WeymenKoo/STIM-Rev1-Hardware/01_client_board/tests/B0-bringup/photos/P4a_prepower.jpg

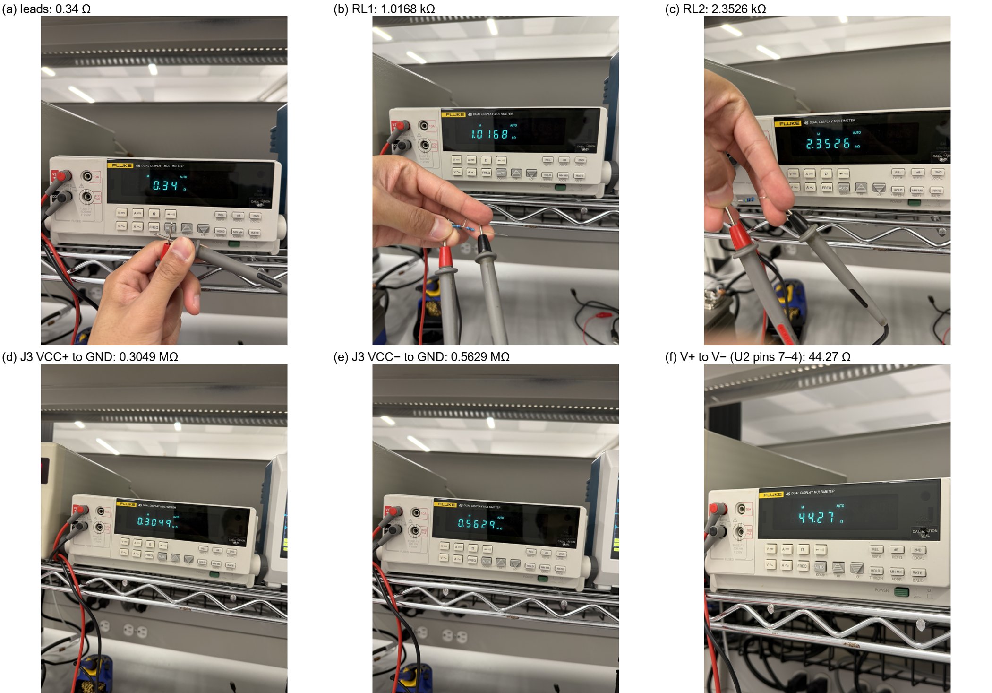
01_client_board/tests/B0-bringup/photos/P4a_prepower.jpg
