WeymenKoo/STIM-Rev1-Hardware/01_client_board/tests/B0-bringup/photos/P4_board_closeup.jpg

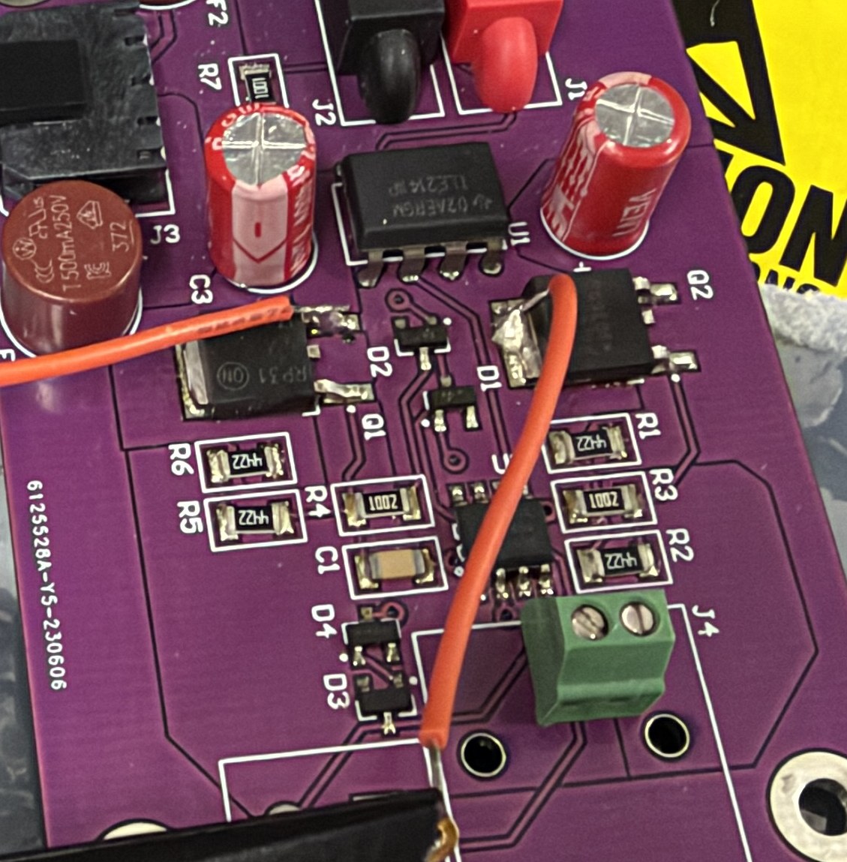
01_client_board/tests/B0-bringup/photos/P4_board_closeup.jpg
