WeymenKoo/STIM-Rev1-Hardware/01_client_board/BENCH-SESSION_30V.docx

Client STIM Board Bench Session Record

Acceptance tests A1, A2, A5b, A4, A3 and A7 at ±30 V — simulation versus bench

JY063 Multi-Channel Neural Interface for Immersive VR · UBC ELEC 491 · Team JY · Weymen Koo

Revision 2026-11-07 · MCLD 3042 bench equipment with a Rigol DHO804 or a Tektronix TBS1000C (2 ch) · companion scripts bench/bench_rig.py (DHO804) and bench/bench_tbs.py (TBS1000C)

# 1. Session identification

Fill in before power is applied. Every number written in this record is a bench value [B]; grey italic values are LTspice predictions [L] from the 2026-10-27 model runs and are provided for comparison only.

Field
Date / location | ____________ MCLD 3042 (3rd-year lab), bench no. ____
Operator(s)
Board | client STIM board (STIM.SchDoc 2026-10-16), S/N: ______ DPAK markings: Q2 top = ________ Q1 bottom = ________
Rails | Xantrex XPH 35-4T, bench unit S/N ______: output 1 = +30.0 V, output 2 = −30.0 V, both I-limit 50 mA (set with output OFF, read on the right meter), outputs floating, out1(−) joined to out2(+) = GND → J3 pin 2
Generator | Rigol DG1022 (bench) via USB, HiZ, Vpp ☐ —or— FG085 ☐ (Vpp field, fixed 50 Ω, set 0 V before connecting)
Scope / probes | Rigol DHO804 S/N ______ via USB ☐ / LAN ☐, 4 × 10× probes, all grounds on J2. preflight run on ______ (date) —or— Tektronix TBS1___C S/N ______ (2 ch) ☐: Default Setup pressed, CH1 + CH2 probe menu 10X and probe switches 10X ☐, bench_tbs.py preflight passed ☐
DMM precision | Fluke 45 (bench) S/N ______, RATE S (5 digits), leads zeroed ☐
DMM second | Brymen BM235 (rail current −)
Load resistors | RL1 nominal 1.00 kΩ, measured: ________ Ω RL2 nominal 2.2 kΩ, measured: ________ Ω (Fluke 45 Ω)
Laptop | bench_rig.py check ☐ lists DHO8 + DG1022 session_log.csv started ☐ (TBS: bench_tbs.py check lists TBS1xxxC + DG1022 ☐)

## 1.1 Probe points (STIM.SchDoc)

Node | Where to clip (never bare tips on SOIC pins — clips or soldered wires)
VCC+ / VCC− | F1 / F2 board side, or J3 pins 1 / 3 (3-pos Micro-Fit: 1 = VCC+, 2 = GND, 3 = VCC−)
GND | J3 pin 2, J2, J5 GND — all scope grounds on J2
VP (V+) | C2 1 µF lead that is NOT on GND (= Q2 emitter, U2 pin 7, U1 pin 7)
VN (V−) | C3 1 µF lead that is NOT on GND (= Q1 emitter, U2 pin 4, U1 pin 4)
OUT | D1–D2 junction = top end of R7 1 k (U2 INA149 pin 6)
LOAD | J1 electrode connector = bottom end of R7 (U1 pin 3)
REF | U1 pin 6 (op-amp output; also U2 pins 1 and 5)
INPUT | J4 BNC centre (generator goes here) = D3/D4 junction = U2 pin 3. J5 screw terminal is the same net
Q2 / Q1 base | R2–R3 junction / R4–R5 junction (DMM only, test 1a)

## 1.2 Before power (tick all)

☐ Laptop: `python3 bench_rig.py check` shows the DHO804 and the DG1022. preflight was run at home (decode OK, generator edge written on sheet 5).

☐ TBS1000C instead of the DHO804: Default Setup on the scope, then `python bench_tbs.py check` (lists TBS1xxxC + DG1022, both probe attenuations read 10) and `python bench_tbs.py preflight` (both probes read ≈ 5 V on PROBE COMP). Only two probes: CH1 LOAD, CH2 OUT. VP / VN / REF loops stay free until the script asks.

☐ Xantrex: both outputs OFF; output 1 preset 30.0 V, output 2 preset 30.0 V; both current limits 50 mA; out1(−) wired to out2(+) and to J3 pin 2.

☐ Fluke 45 in series with the VCC+ lead (mA, 300 mA range for power-up), BM235 in series with the VCC− lead (mA).

☐ RL1 between J1 and J2. Generator BNC on J4, generator output OFF / 0 V. No electrodes, no humans in the loop.

☐ Scope probes on LOAD, OUT, VP, VN; grounds on J2 only. Probe clips not touching anything else; check with the DMM that VP–VN clips are not shorted.

☐ This sheet printed. tests/bench/ folder empty or from a previous run renamed.

## 1.3 Rules

• Both rails on and off together: two fingers on the two Xantrex output buttons. Never one rail alone for more than the press (A7 sim: ~6.6 mA while one rail is missing at ±30 V — test 6 does it on purpose, nothing else should).

• Generator to 0 V before changing the load or the wiring — the script does this at every swap. OUT swings to a rail if the load opens with a command applied.

• Rail current > 15 mA at idle → both outputs OFF, do not debug live. The script stops itself if you type > 15.

• The Fluke 45 is the only meter that resolves ±1 %. The BM235 is for rail current only. The Xantrex meters (10 mA) are not readings.

• Every number written here is tagged [B]. Grey italic numbers are [L] from generic op-amp macromodels; the ones marked “validates the model” are the ones that matter.

## 1.4 Wiring

Xantrex out1 (+30 V) -- Fluke 45 mA -- J3.1 VCC+

Xantrex out1 (-) ---+

Xantrex out2 (+) ---+-- GND -- J3.2 / J2 (fixture GND post)

Xantrex out2 (-30 V) -- BM235 mA -- J3.3 VCC-

DG1022 -- BNC -- J4 INPUT RL fixture: J1 (LOAD) -- J2 (GND)

Scope CH1 LOAD CH2 OUT->REF CH3 VP CH4 VN grounds on the GND post

TBS1000C: CH1 LOAD (never moves) CH2 OUT/VP/VN/REF in turn (A1), INPUT (A3/A4), VCC+ (A7)

Laptop USB -> DHO804 + DG1022 (USB ground = earth = scope ground = J2)

## 1.5 Running order and time (script commands on each sheet)

# | Test | Changes from previous | Time | Done ☐

0 | preflight (at home) | no board: probe-comp decode check, generator flatness + edge | 10 min
1 | A1 bias / bootstrap window | — (1d onset sweep and 1e rail sweep inside) | 40 min
2 | A2 DC accuracy | generator to DC; Fluke 45 to INPUT / LOAD | 10 min
3 | A5b load change | pull fixture link, Fluke 45 in series; swap fixture once | 5 min
4 | A4 frequency response | CH2 to INPUT; scripted sweep | 3 min
5 | A3 step response | scripted single-shot, square 0 / 2 V | 5 min
6 | A7 rail loss (optional) | Xantrex output buttons on prompt | 10 min

## 1.6 Using the TBS1000C when the DHO804 is not there (2 channels)

Same tests, same prompts, same session_log.csv and output files; run bench_tbs.py instead of bench_rig.py with the same options. Where a test needs more than two nodes at the same instant (A1 only), CH1 stays on LOAD and the script asks you to move CH2 between captures. Every capture triggers on LOAD, and the script lines them up on the LOAD phase before it forms VP − VN, REF − VN and VP − REF, so the numbers are the same quantities as on the DHO. It prints the shift it applied (expect < 1 µs of a 3333 µs period).

# | Test | TBS1000C: channels and what changes | Extra | Done ☐

0 | preflight | both probes on PROBE COMP in turn: ≈ 5 V or the 1X/10X setting is wrong; then generator → CH1 | +3 min
1 | A1 | CH1 LOAD fixed. CH2: OUT → VP → VN at idle, then OUT / VP / VN / REF at each amplitude (one prompt per move). 1d onset swept twice (pk+, then pk−) so 1 V/div covers each peak. 1e: CH2 VP → VN | +15 min
2 | A2 | identical: Fluke 45 does the work, scope idle | 0
3 | A5b | identical | 0
4 | A4 | CH1 LOAD, CH2 INPUT. First 20 s: CH1 also on INPUT, so the CH1/CH2 gain (±3 % each [DS]) is divided out | +2 min
5 | A3 | CH1 LOAD, CH2 INPUT, 16 averages per capture instead of single-shot (8 bit: 1 % of 2 V ≈ 1 count) | +1 min
6 | A7 | CH1 LOAD, CH2 VCC+ (F1 board side): shows when the + rail leaves and returns | 0

• 8 bit instead of 12: the script averages 16× and re-scales until each trace fills more than 1/3 of the screen without clipping. The A1 1b “±1 %” and A4 “absolute gain ±1 %” rows are indicative only. Tick them from A2 (Fluke 45), which is the ±1 % arbiter either way.

• Press Default Setup on the TBS before starting (trigger at mid-screen) and set the CH1 and CH2 probe menus to 10X. The script does not change the probe setting; preflight checks it.

• Probe ground clips: both on J2, as on the DHO. The TBS channels share a ground with each other and with mains earth, the same as the DHO.

# 2. Harnesses, fixtures and kit (made and checked at home)

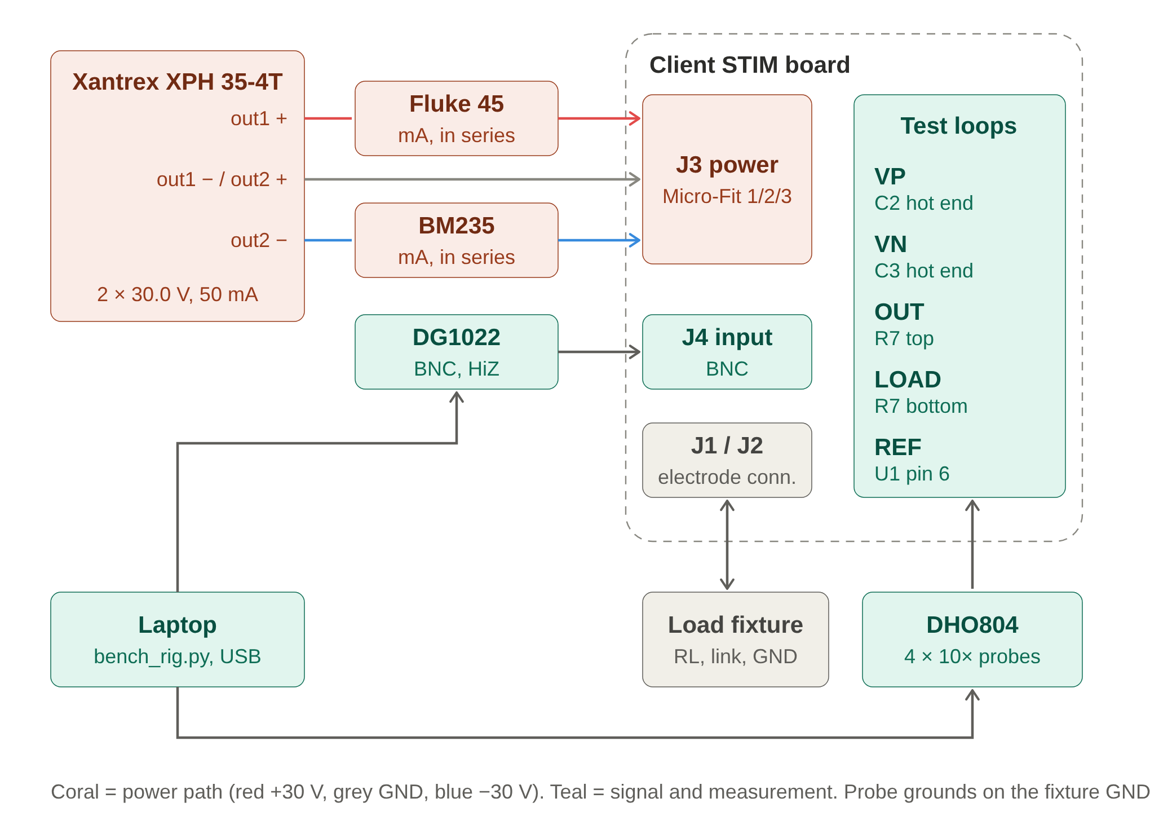
[picture p38: figure]

Figure 1. Bench wiring. Coral = power path, teal = signal and measurement. Rail ammeters sit at the Xantrex posts. All probe grounds on the fixture GND post.

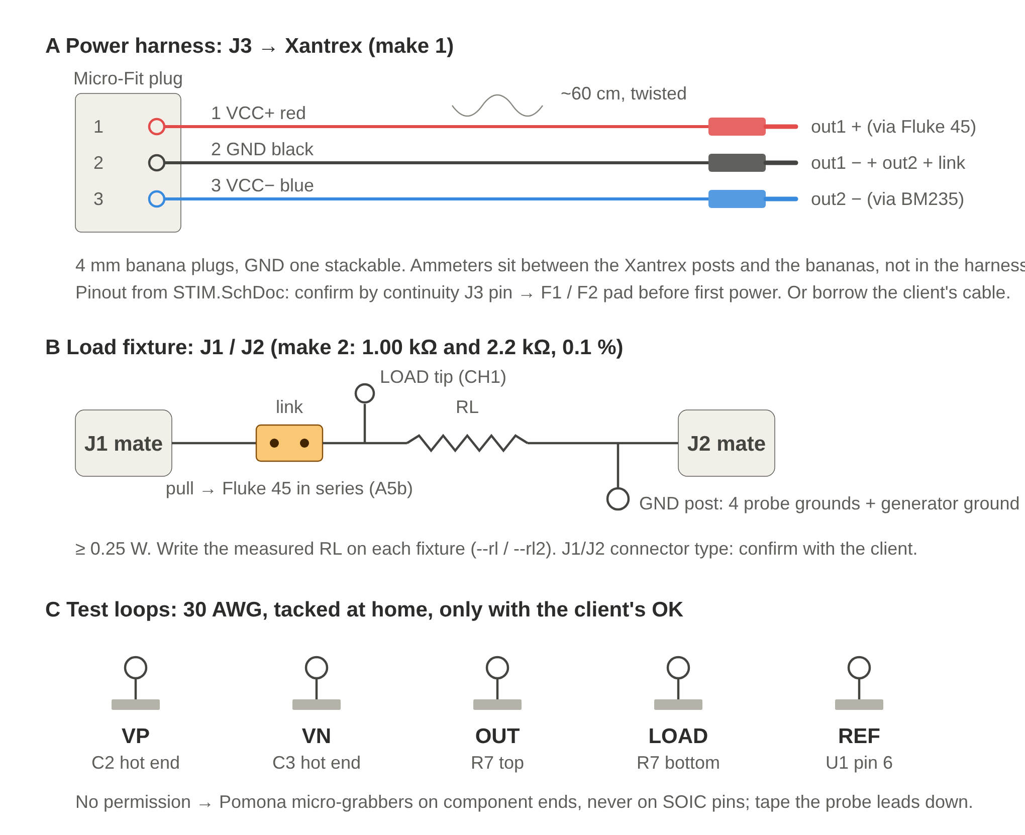
[picture p39: figure]

Figure 2. Harness and fixture mockups. A: J3 → Xantrex. B: load fixture, one per resistor, with the series link for A5b. C: test loops at the five probe nodes.

## 2.1 A. Power harness (make 1)

3-pin Molex Micro-Fit plug on J3 (1 = VCC+, 2 = GND, 3 = VCC−, from STIM.SchDoc) → ~60 cm twisted triple → 4 mm bananas red / black / blue, GND banana stackable. Short banana jumper out1(−) ↔ out2(+). The Fluke 45 and BM235 go between the Xantrex posts and the red / blue bananas, not inside the harness. Micro-Fit needs a crimp tool: ask the client for the cable they already use, or pre-crimped Micro-Fit leads + housing (Digi-Key, next day).

## 2.2 B. Load fixtures (make 2)

J1 mate → 2-pin link → RL → J2 mate, with a GND post (wire loop or turret) at the J2 end and a LOAD loop at the J1 end. RL = 1.00 kΩ and 2.2 kΩ, 0.1 %, ≥ 0.25 W. Pull the link to put the Fluke 45 in series (A5b). Swapping loads = unplug one fixture, plug the other. Write the measured RL on each fixture; those are --rl / --rl2. Confirm the J1/J2 connector type with the client and get two mates.

## 2.3 C. Test loops (with the client's OK)

30 AWG loops tacked at VP (C2 lead not on GND), VN (C3 lead not on GND), OUT (R7 top), LOAD (R7 bottom), REF (U1 pin 6). INPUT is J4. If no permission: Pomona micro-grabbers on component ends only, never SOIC pins, probe leads taped down.

## 2.4 Bring

Item | Note
DHO804 + adapter + 4 × 10× probes + USB cable | preflight run at home with this exact cable
Laptop + charger + USB-B cable for the DG1022 | small USB hub if short on ports
BM235 | optional: rail currents are equal when the load current averages to zero; Fluke 45 on VCC+ is enough
Board, 2 load fixtures, power harness, GND jumper
4 banana–banana leads, 2 banana–minigrabber leads | do not count on the lab's
Spare F1 / F2 fuses | read the marking on the board first
ESD strap, screwdriver, Kapton, zip ties, this sheet, pen
From the lab | Xantrex XPH 35-4T, Fluke 45, DG1022, BNC–BNC cable; TBS1000C + 2 × 10× probes + USB-B cable if the DHO804 is not there

## 2.5 At home before the session (~30 min, tick all)

☐ Continuity: each harness end to end; J3 pin 1 → F1 pad, pin 3 → F2 pad, pin 2 → J2 on the board (unpowered).

☐ Unpowered resistance with the Fluke: VCC+ → GND ______ Ω, VCC− → GND ______ Ω, VCC+ → VCC− ______ Ω. Very low or a short → do not power.

☐ RL1 measured ______ Ω, RL2 measured ______ Ω, written on the fixtures.

☐ python3 bench_rig.py preflight passed (decode OK, generator edge noted) with the DHO804 and FG085 --gen manual.

☐ Client emailed: J3 cable loan, J1/J2 connector part / two mates, permission to tack test loops.

# 3. Test 1 — A1 Bias point and bootstrap window

Question. Does the floating op-amp supply (VP–VN window) form at ±30 V, and can the pump deliver 2 mA and 5 mA? Decides the working current for every test after it, and measures the Q1/Q2 emitter-follower drops (the transistor question).

Probes. CH1 LOAD (J1 / bottom of R7) · CH2 OUT (D1–D2 junction / top of R7) · CH3 VP (C2 lead that is not GND) · CH4 VN (C3 lead that is not GND) · all probe grounds on J2. Fluke 45 in series with the VCC+ lead (mA), BM235 in series with the VCC− lead (mA). ~40 min.

Script: python3 bench_rig.py a1 --rl <RL1> --onset (add --rails 35 for a ±35 V point; --rails 35 40 50 only with a second dual supply)

TBS1000C: python bench_tbs.py a1 --rl <RL1> --onset (CH1 LOAD fixed; the script asks for each CH2 move: OUT → VP → VN → REF)

TBS1000C: 1b “I_load ±1 %” is indicative (8 bit). Decide the ±1 % from A2. VP / VN at I pk+, REF − VN and VP − REF come from separate CH2 captures aligned on LOAD.

## 3.1 1a. Power-up, no signal (generator OFF) — script prompts for the DMM values, reads the scope itself

Quantity | Expected [L] ±30 V | Bench [B] (write here) | Tol. / Pass ☐
Rail current + / − (Fluke 45 / BM235 in series) | ~3.5–5 mA each | | > 15 mA → OFF
VCC+ / VCC− vs GND (Fluke 45, J3 pins 1 / 3) | +30.0 / −30.0 V | | —
VP / VN vs GND (scope mean) | +2.5 / −2.4 V | | ±1 V
OUT / LOAD vs GND | ≈ 0 / 0 V | | —
Window VP − VN | 4.97 V | | ±2 V ☐
Q2 Vbase (R2/R3 junction) − VP | +0.65 V (NPN follower, as modelled) | | record
Q1 Vbase (R4/R5 junction) − VN | −0.65 V (PNP follower, as modelled) | | record
LOAD ripple (AC, 50 mV/div, 1 µs/div): Vpp / f | none [L]; TI models ~1 MHz | | record

Sign of Vbase − Vemitter wrong, or |Vbe| ≫ 0.7 V → the fitted transistor is not what the model assumes. Write the DPAK markings here and carry on; the window numbers decide, not the part.

Q2 marking / Q1 marking _________________________________________________________

## 3.2 1b. 2 mA run (2 Vpk 300 Hz) — script reads at the positive current peak; CH2 moves OUT → REF (U1 pin 6) when prompted

Quantity | Expected [L] ±30 V | Bench [B] (write here) | Tol. / Pass ☐
I_load pk+ / pk− (V(LOAD) ÷ RL) | 2.000 / −2.000 mA | | ±1 % ☐
OUT at I pk+ | 4.00 V | | ±0.2 V
VP / VN at I pk+ | +6.0 / +1.1 V | | ±1 V
REF − VN min (CH2 on REF) | 0.92 V ← validates the model | | record
VP − REF min | 1.05 V | | record
Window VP − VN avg | 4.97 V | | ±2 V ☐
Rail current + / − | 5.2 / 5.2 mA | | ±20 % ☐

Figure 3. Expected 2 mA waveforms [L]. Script saves A1_30V_2mA_bench.csv / _ref.csv and the overlay PNG.

## 3.3 1c. 5 mA run (5 Vpk) — the sim says the current clips; look at the LOAD trace shape first

Quantity | Expected [L] ±30 V | Bench [B] (write here) | Tol. / Pass ☐
Plateau present? flat or sloped? (script: fraction of period on plateau) | yes, flat (> 0.1) | | record
I_load plateau + / − | +4.01 / −3.38 mA | | ±0.5 mA ☐
REF − VN during the + plateau | 0.20 V | | record
VP − REF during the − plateau | 1.00 V | | record
Window VP − VN avg | 4.84 V | | ±2 V ☐
Rail current + / − | 6.0 / 5.9 mA | | ±20 % ☐

D3/D4 (5 V zeners) start to conduct near 5 V: the INPUT the board sees may be below the generator setting. The script uses the measured LOAD, not the setting.

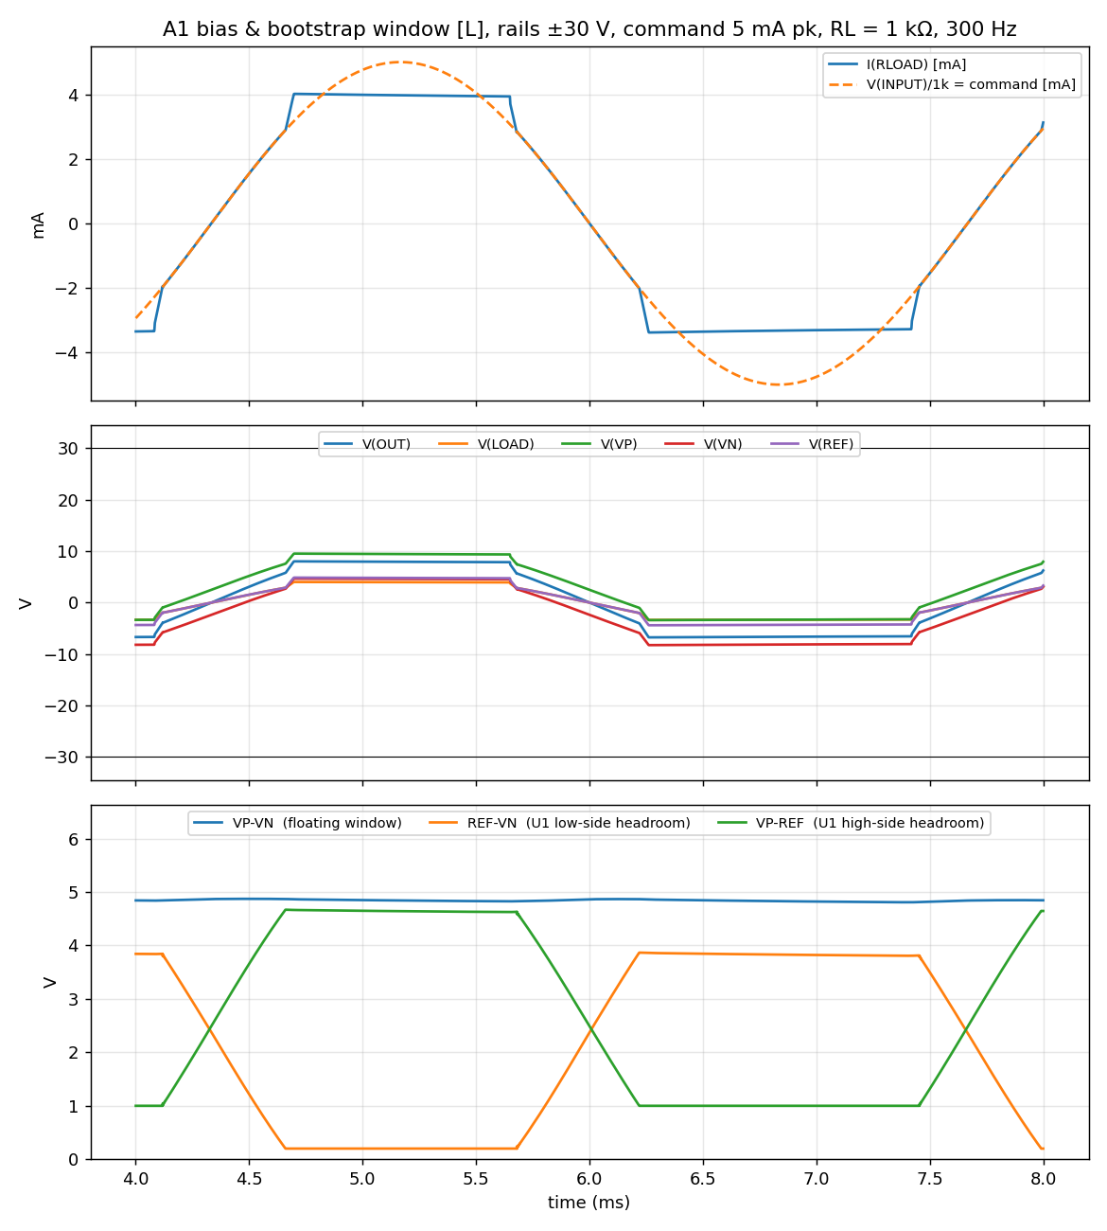
[picture p40: figure]

## 3.4 1d. Plateau onset (scripted, 1 min): 2.0 → 4.0 mA in 0.25 mA steps

Sourcing onset (mA cmd where pk+ < 98 %) Sinking onset (mA) ________________

## 3.5 1e. Optional — window vs rail (the ±50 V claim). Generator OFF, ramp both rails together, DMM/scope only

Rails | VP / VN (V) | Window (V) | Window [L] scaling | I rail + (mA) | 2 mA pk+ / pk− (mA)
±30 V | | | 4.97
±35 V (Xantrex max) | | | ~5.8
±40 V (2 supplies) | | | ~6.6
±50 V (2 supplies) | | | ~8.2

Stop if rail current > 15 mA or window > 30 V (INA149 abs max ±18 V). ±40/±50 V = Xantrex 35 V + TTI EX354RT 5–15 V in series on each side, both units' outputs floating.

## 3.6 Decision after A1 (circle one)

☐ Window within ±2 V and 2 mA within 1 % → model OK at ±30 V; run tests 2–6 at 2 mA (as printed).

☐ Window OK but 2 mA a few % low → real op-amp swing worse than model; run tests 2–6 at 1 mA (script: --cmd-scale 0.5).

☐ Window off by > 2 V → write the DPAK markings; stop, fix the model before test 2.

Notes ___________________________________________________________________________

# 4. Test 2 — A2 DC accuracy vs command

Question. Is I_load = V(INPUT) / 1 kΩ within 1 %? Sim column is a zero-error reference; the bench produces the real offset and gain error.

Method. Fluke 45, RATE S (5 digits), 3 V range for INPUT and LOAD, 30 V range only where the reading exceeds 3 V. At each command the script sets the generator (DC, no AC) and asks for V(INPUT) then V(LOAD); it computes I = V(LOAD)/RL against V(INPUT)/1 kΩ, so the generator's offset accuracy drops out. RL1 measured first with the Fluke 45 (Ω, leads zeroed). ~10 min.

Script: python3 bench_rig.py a2 --rl <RL1>

TBS1000C: python bench_tbs.py a2 --rl <RL1> (identical)

RL1 measured (Ω, Fluke 45) ______________________________________________________

Command | Expected I [L] | V(INPUT) bench | V(LOAD) bench | I = V/RL · error % | Pass ☐
+0.5 V | 0.5000 mA | | | | ±1 %
+1 V | 1.0000 mA | | | | ±1 %
+2 V | 2.0000 mA | | | | ±1 %
−2 V | −2.0000 mA | | | | ±1 %
+5 V | 3.837 mA (clips) | | | | record
−5 V | −3.188 mA (clips) | | | | record

Uncertainty budget: Fluke 45 0.025 % + 2 d on each reading, RL 0.05 % → ≈ ±0.1 % on the error figure; the ±1 % line is resolved. (BM235 would be ±0.7 %: do not use it here.)

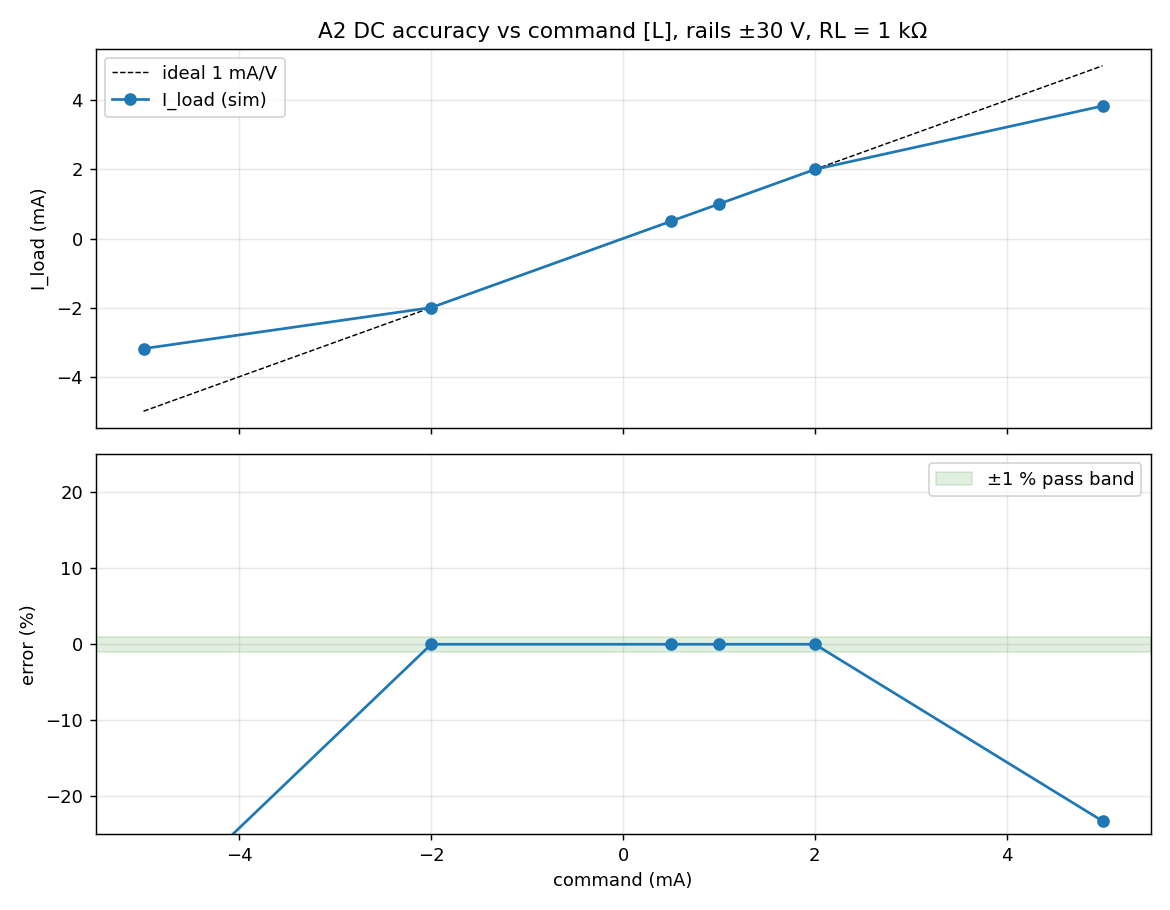
[picture p41: figure]

Offset (µA) / gain error (%) — script prints from the 0.5…2 mA fit _____________

Notes ___________________________________________________________________________

# 5. Test 3 — A5b Output impedance by load change

Question. Does the current move when RL goes 1.0 → 2.2 kΩ at 2 mA? Pass = ΔI/I < 0.1 %.

Method. Fluke 45 IN SERIES with RL (A input, mA DC, manual range 30 mA, RATE S → 1 µA = 0.05 % at 2 mA). Same range for both loads so the meter's gain error cancels; the resistor values only enter Z_out, not ΔI/I. Generator DC 2 V; script takes it to 0 V for the swap. ~5 min.

Script: python3 bench_rig.py a5b --rl <RL1> --rl2 <RL2>

TBS1000C: python bench_tbs.py a5b --rl <RL1> --rl2 <RL2> (identical)

RL1 measured (Ω) RL2 measured (Ω) _____________

Quantity | Expected [L] ±30 V | Bench [B] (write here) | Tol. / Pass ☐
I at RL1 (1.0 kΩ) | 2.0000 mA | | —
I at RL2 (2.2 kΩ) | 2.0003 mA | | —
ΔI / I | +0.015 % | | < 0.1 % ☐ (meter floor 0.05 %)
Z_out = ΔV / ΔI | |8.1 MΩ| | | > 1.2 MΩ ☐

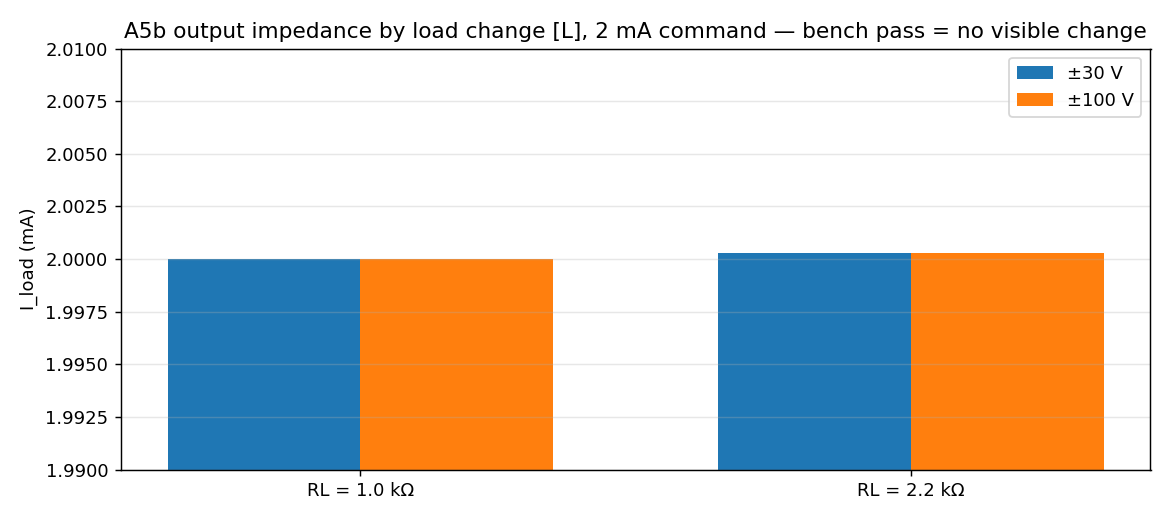
[picture p42: figure]

Notes ___________________________________________________________________________

# 6. Test 4 — A4 Frequency response (scripted)

Question. Is the current flat to 10 kHz? Expected dead flat; ±0.5 dB is the measurement's tolerance, not the circuit's.

Method. CH1 LOAD, CH2 INPUT (J4 BNC centre). Script sets the DG1022 to 2 Vpk at each frequency, sine-fits both channels and takes the ratio I_load / V(INPUT), so generator flatness and scope gain drop out. 1 and 10 Hz use single acquisitions (slow), the rest average 8. ~3 min. With FG085 / --gen manual: dial each frequency when prompted.

Script: python3 bench_rig.py a4 --rl <RL1> --extra

TBS1000C: python bench_tbs.py a4 --rl <RL1> --extra (first: CH1 clipped on INPUT beside CH2 for the gain cal, then back on LOAD)

TBS1000C: write the CH1/CH2 gain the script prints: ________ . The absolute gain at 10 Hz is after that correction and is still only good to a few tenths of a %.

f (Hz) | Expected [L] | mA/V bench | dB vs 10 Hz | phase ° | Pass ☐ (±0.5 dB)
1 | 0.000 dB
10 | 0.000 dB (ref) | | 0 (ref)
100 | 0.000 dB
300 | 0.000 dB
1 k | 0.000 dB (−0.02°)
10 k | +0.002 dB
extra: 3 / 30 / 3 k / 30 k / 100 k | flat; loop peak +6 dB at ~600 kHz, not reached | | | | record

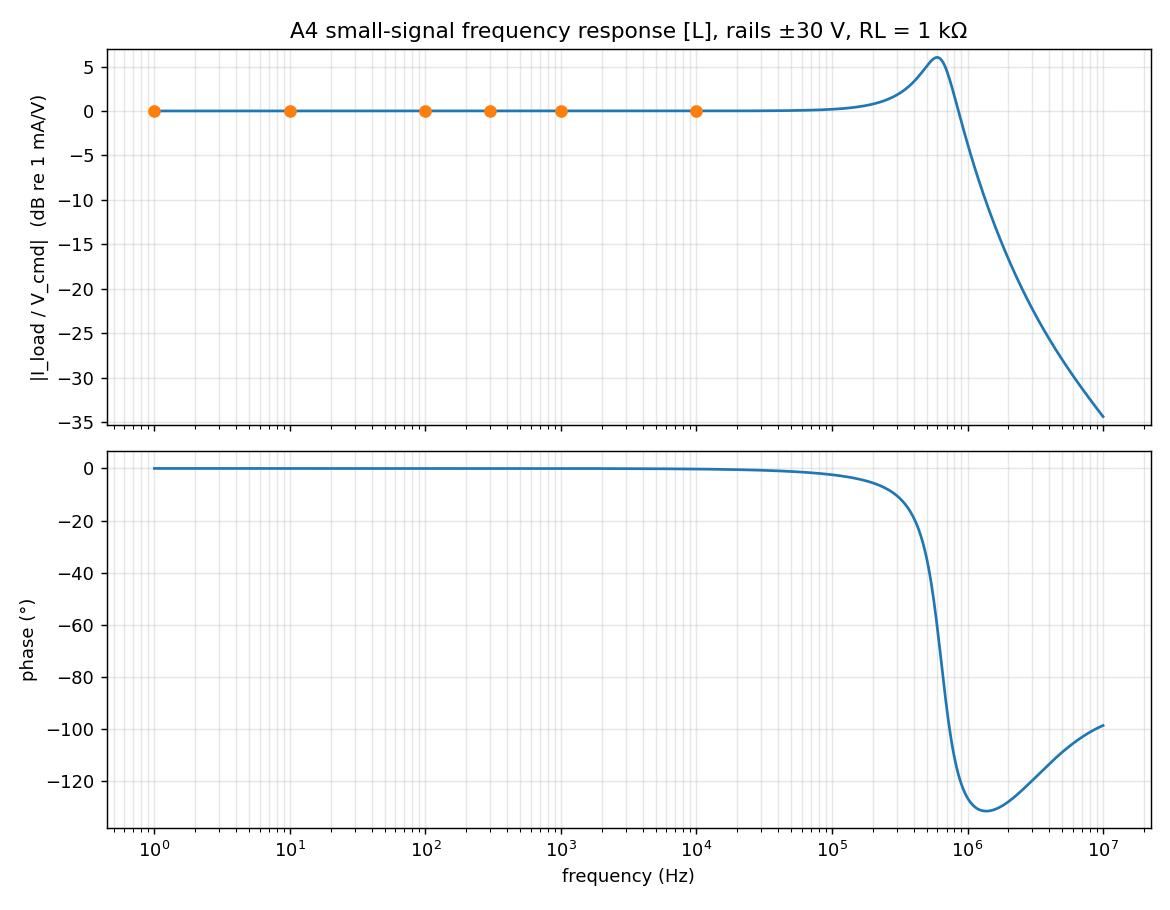
[picture p43: figure]

Figure 4. Expected [L]: flat to 10 kHz. Script writes A4_30V_bench.csv/.png with the sim overlaid.

Absolute gain at 10 Hz (mA/V, expect 1.000 ±1 %) ________________________________

Notes ___________________________________________________________________________

# 7. Test 5 — A3 Step response and settling (scripted single-shot)

Question. How fast does the pump settle to 1 % after a 0 → 2 mA step, and how much does it overshoot?

Method. CH1 LOAD (0.5 V/div), CH2 INPUT. DG1022 square 0 / 2 V, 500 Hz (edge ~10 ns [DS] — much faster than the 1 µs sim stimulus, so expect MORE overshoot than [L], not less). Script triggers on CH2 rising, captures 5 µs/div then 100 µs/div, computes everything. ~5 min.

Script: python3 bench_rig.py a3 --rl <RL1>

TBS1000C: python bench_tbs.py a3 --rl <RL1> (16 averages per capture)

Generator edge 10–90 % (ns) — from preflight / script ___________________________

Quantity | Expected [L] ±30 V | Bench [B] (write here) | Tol. / Pass ☐
Overshoot vs final (pk − 2 mA) / 2 mA | 18.4 % (1 µs edge) | | ±10 pts ☐
Last exit from ±1 % band (µs after edge end) | 2.75 µs | | ±50 % ☐
Ring frequency (MHz) | ~0.7 MHz | | record
Final value | 2.000 mA | | ±1 %

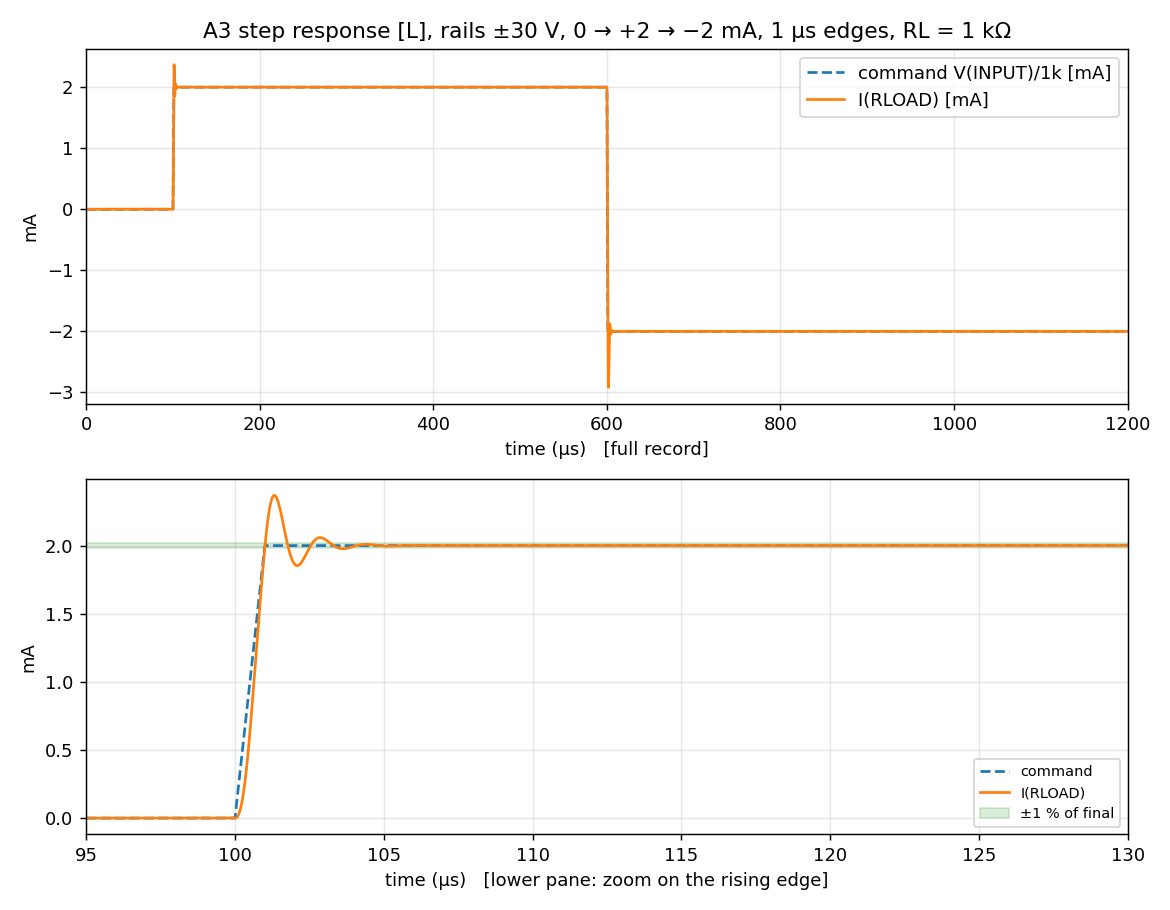
[picture p44: figure]

Figure 5. Expected [L] with a 1 µs edge. If the overshoot is much larger with the 10 ns edge, re-run the sim with the measured edge before calling it a mismatch.

Notes ___________________________________________________________________________

# 8. Test 6 — A7 Single-rail loss (optional; the client's only prototype)

Question. What current reaches the load when the + rail drops out mid-stimulus? FMEA input for the 10 mA hard limit.

Method. Generator DC 2 V, RL 1 kΩ, CH1 LOAD, 10 ms/div single-shot (script arms the trigger each time). SEQ 2: Xantrex output 1 (+ rail) OFF when prompted, then ON. SEQ 3: both outputs OFF, then both ON with two fingers — this also measures the stagger of the two-finger power-up used all session. SEQ 1 (one rail for seconds) is NOT done. 50 mA limit on both outputs. Alternative: Korad as the + rail, scripted (--korad), its (−) on GND only. ~10 min.

Script: python3 bench_rig.py a7 --rl <RL1> [--korad /dev/tty.usbserial-XXXX]

TBS1000C: python bench_tbs.py a7 --rl <RL1> (CH2 on VCC+ at F1)

Quantity | Expected [L] ±30 V | Bench [B] (write here) | Tol. / Pass ☐
SEQ 2: I_load after + rail lost (continuous) | −5.9 mA | | ±50 % ☐
SEQ 2: transient peak during the drop | −6.3 mA | | record
SEQ 2: I_load after + rail restored | 2.000 mA | | ±1 %
SEQ 3: peak during two-finger enable | 2.02 mA (ideal simultaneous) | | < 3 mA ☐
SEQ 3: stagger between the two outputs (ms, from the trace) | 0 | | record

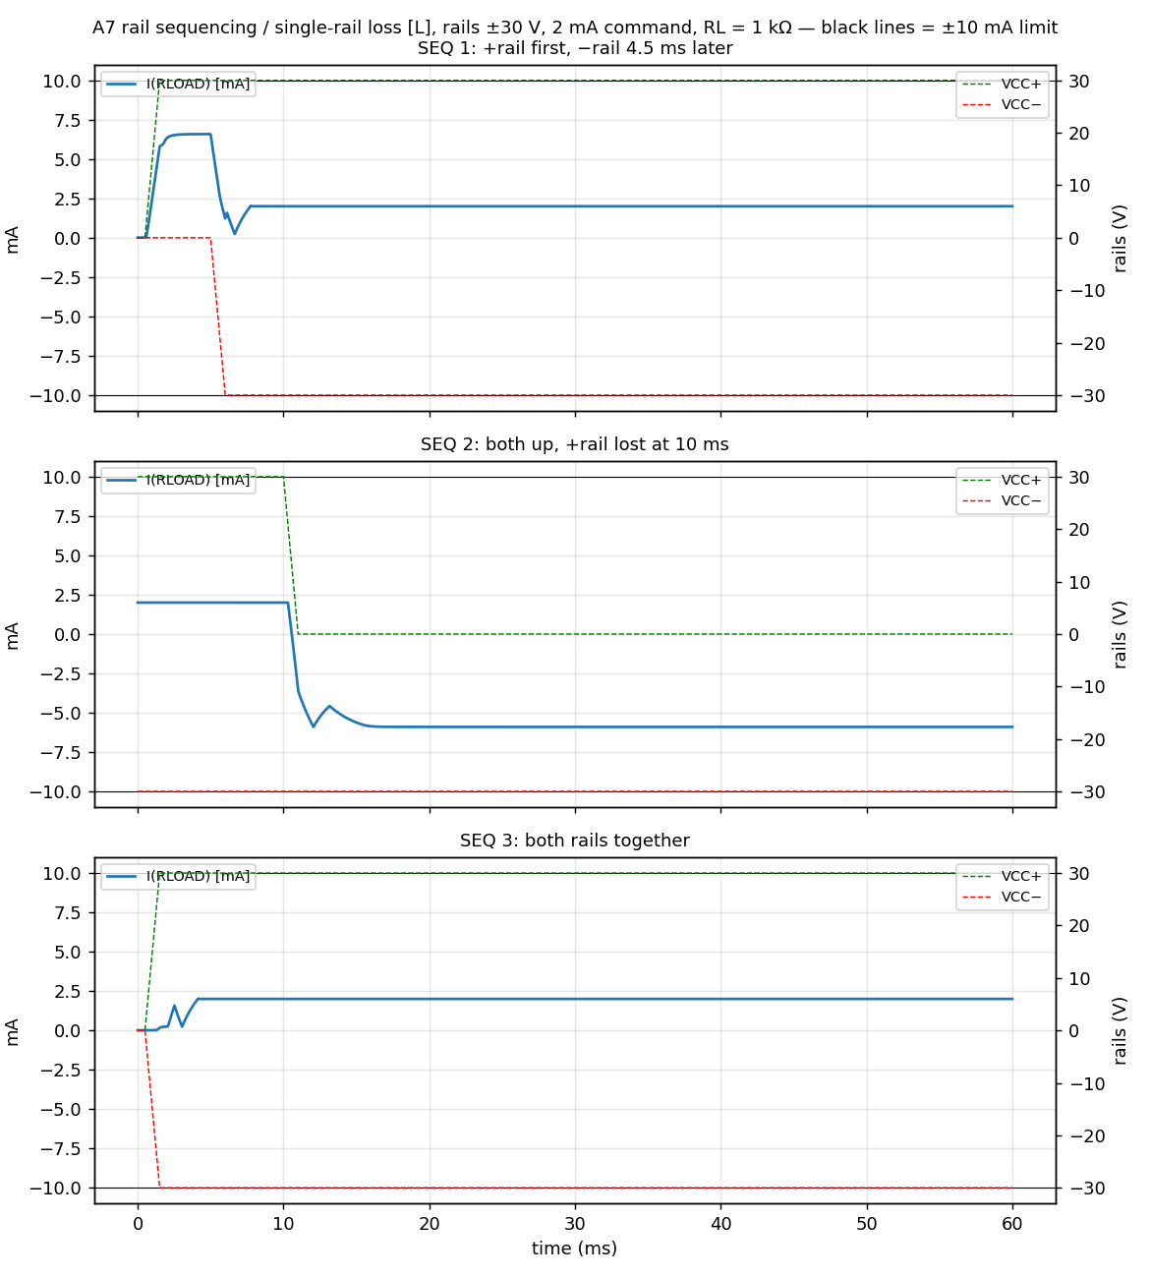
[picture p45: figure]

Notes ___________________________________________________________________________

# 9. After the session

session_log.csv has every number with its expected value and pass flag — paste the [B] columns into tests/<ID>/RECORD.md and acceptance-tests.md from it; the overlay PNGs (sim dashed, bench solid) are already in tests/<ID>/bench/. Decide the A2–A5 working current from the test-1 decision box. A3: if the 10 ns edge gives much more overshoot than [L], re-run A3-step-settling.asc with the measured edge before calling it a mismatch. One line per Rev-2 thought to 03_safety_plan/parking-lot.md. Transistor finding (1a Vbe rows, 1e window law) → DECISIONS.md.

JY063 · Client STIM board bench session record · ±30 V
