WeymenKoo/STIM-Rev1-Hardware/01_client_board/deck/stim-stage-design-calculator.xlsx

JY063 STIM stage — bootstrapped Howland current pump: design calculator |  |  |  |  |  | Legend: yellow + blue = input you may edit · green = key result · black = calculated (do not edit)
# | Quantity | Symbol | Value | Unit | Formula | What it means | Source / notes
 | Purpose: quick hand-calculation model of the stimulator output stage (the circuit in TI SLYY054 as built on the client board). It is the mathematical counterpart of the LTspice model: change any yellow cell and every result below updates.
 | How to use: (1) edit only YELLOW cells with BLUE numbers; (2) read the KEY RESULTS block; (3) every result row shows its formula in column F and a plain-language explanation in column G. Units are chosen so Ohm's law works directly: volts (V) = milliamps (mA) × kilo-ohms (kΩ); power in milliwatts (mW) = V × mA.
 | Example operating point already entered: ±100 V rails, 5 mA peak into a 10 kΩ dummy head, 1 kΩ sense resistor (the values used in the simulation deck).
 | Limits of this sheet: steady-state (DC / slow-signal) maths only. Stability, ringing, power-up faults and ripple coupling come from the LTspice simulation and are quoted, not derived. Hand estimates are typically within ~10–20 % of the simulation; where they differ, trust the simulation and the bench.
 | KEY RESULTS (auto-filled from the calculations below)
 | Command voltage needed from the DAC |  | 10.00 | V | → see row 95
 | Voltage across the head at peak |  | 100.0 | V | → see row 96
 | Headroom left at this operating point (must be ≥ 1.5 V) |  | -2.76 | V | → see row 116
 | Largest head resistance for full current — typical parts |  | 5.81 | kΩ | → see row 130
 | Largest head resistance for full current — worst-case parts |  | 3.07 | kΩ | → see row 131
 | Rail voltage needed for this head — worst-case parts |  | 169.3 | V | → see row 134
 | Worst-case current error at this current |  | 0.19% |  | → see row 166
 | Smallest current that still meets the accuracy target |  | 0.471 | mA | → see row 168
 | Output impedance near DC (higher = better current source) |  | 31.6 | MΩ | → see row 174
 | Hottest power transistor (normal operation) |  | 103.8321837 | °C | → see row 145
 | Power transistor temperature if the output is shorted |  | 221.0919615 | °C | → see row 148
 | Allowed supply ripple at the chosen switching frequency (preliminary) |  | 294.1176471 | mVpp | → see row 181
 | Highest full-current frequency (slew-rate limit) |  | 7.2 | kHz | → see row 185
 | Battery current drawn (all channels, peak) |  | 142.0178336 | mA | → see row 193
 | Pass / fail checks
 | Operating point inside compliance (headroom) |  | FAIL: current will clip |  |  | → see row 122
 | Head resistance OK with worst-case parts |  | FAIL: raise rails |  |  | → see row 135
 | Op-amp floating supply inside its allowed range |  | PASS |  |  | → see row 123
 | Command below the input clamp (zener) voltage |  | WARN: clamp may conduct — needs stiff DAC buffer or 6V2 zener |  |  | → see row 98
 | Accuracy target met at this current |  | PASS |  |  | → see row 169
 | Power transistor voltage rating (80 % derating) |  | PASS |  |  | → see row 149
 | Power transistor temperature, normal operation |  | PASS |  |  | → see row 150
 | Power transistor survives an output short |  | FAIL: add copper area / current limit |  |  | → see row 151
 | Frequency band reachable at full current |  | PASS |  |  | → see row 186
 | 1. OPERATING POINT (what you want the stimulator to do)
 | These describe the job, not the circuit. Change them to explore other heads, currents or supplies.
1 | Supply rail magnitude (the converter makes +Vrail and −Vrail) | V_rail | 100.0 | V | (input) | Higher rails let the board push current through higher-resistance heads, at the cost of heat and safety margin. | Project design value (power team); deck Fig 7
2 | Peak stimulation current requested | I | 10.000 | mA | (input) | The largest current the stimulator must deliver (positive or negative). Project KPI: 5 mA. | Project KPI
3 | Head + electrode resistance to drive | R_load | 10.00 | kΩ | (input) | The 'dummy head'. Real skin+gel electrodes: measure and enter here. Higher = needs more voltage. | Simulation deck default (10 kΩ); replace with measured value
4 | Sense resistor R7 (sets the current per volt of command) | R7 | 1.000 | kΩ | (input) | The circuit forces the command voltage across this resistor, so current = command ÷ R7. | Client STIM.SchDoc (as modelled in S01_STIM_board.asc)
5 | Output resistance of whatever drives the input (DAC buffer) | R_src | 0.0 | Ω | (input) | 0 Ω = ideal DAC buffer. The bench function generator is 50 Ω, which adds a small gain error. | Deck Step 4/8 (50 Ω generator vs DAC buffer)
6 | Air temperature inside the enclosure | T_a | 40 | °C | (input) | Used for the transistor temperature estimate. 40 °C allows for a warm enclosure. | Assumption (edit as needed)
7 | Accuracy target (current error allowed) | ε_KPI | 1.0% |  | (input) | ±1 % = the delivered current must be within 1 % of the request. | Project KPI 1
8 | Highest signal frequency the stimulator must reproduce | f_KPI | 1.000 | kHz | (input) | 300 Hz waveforms with 1 kHz DAC updates → 1 kHz used as the requirement. | Project KPI
9 | Flyback converter switching frequency | f_sw | 150 | kHz | (input) | Ripple from the converter leaks into the head more at higher frequency. Client schematics: 500 kHz and 950 kHz. | Power team / client schematics
10 | Allowed ripple current in the head | I_rip | 5.0 | µA peak | (input) | 5 µA = 0.1 % of 5 mA. A project choice, not a standard. | Deck Step 6 (chosen budget)
11 | Number of stimulation channels on the battery | N | 1 | - | (input) | Each channel has its own copy of this stage. | Project (edit)
12 | Converter efficiency (battery → ±rails) | η | 0.80 | - | (input) | Fraction of battery power that reaches the rails. 0.7–0.85 is typical for a small flyback. | Assumption
13 | Battery voltage | V_bat | 18.0 | V | (input) | 18 V alkaline pack. | Project (power team)
 | 2. BOARD COMPONENT VALUES (client prototype)
 | Values on the client board. R4–R6 mirror R3–R1 (the bottom half is a mirror image), so only the top half is entered.
14 | Bias string resistor R1 | R1 | 44.2 | kΩ | (input) | Top of the bias string, from +rail. | Client STIM.SchDoc (as modelled in S01_STIM_board.asc); same value in SLYY054 Fig 4
15 | Bias string resistor R2 | R2 | 44.2 | kΩ | (input) | In series with R1. | Client STIM.SchDoc (as modelled in S01_STIM_board.asc)
16 | Bias string resistor R3 (sets the half-window) | R3 | 10.0 | kΩ | (input) | The current through R3 sets how far the op-amp supply sits above the output (≈ I × R3). | Client STIM.SchDoc (as modelled in S01_STIM_board.asc)
17 | Upper string resistance R1 + R2 | R_top | 88.4 | kΩ | R_top = R1 + R2 | Big resistor that feeds current from the rail into the bootstrap. | Derived
18 | Window-setting resistance | R_mid | 10.0 | kΩ | R_mid = R3 | Renamed for clarity. | Derived
19 | Diode forward drop D1/D2 (BAS16) at ~1 mA | V_D | 0.65 | V | (input) | Each diode cancels the base–emitter drop of its transistor. | BAS16 datasheet (≈0.62–0.72 V at 1 mA)
20 | Transistor base–emitter drop (MJD340/350) at a few mA | V_BE | 0.65 | V | (input) | A silicon transistor turns on at about 0.6–0.7 V. | Typical silicon BJT
 | 3. COMPONENT DATASHEET LIMITS
 | From manufacturer datasheets. 'Typical' values describe an average part; 'max/min' are guaranteed limits for the worst part you might receive.
 | U2 — INA149 difference amplifier (drives the output)
21 | Minimum total supply |  | 4.0 | V | (input) | Below this the chip stops working properly. | TI INA149 datasheet / product page, https://www.ti.com/product/INA149
22 | Maximum total supply |  | 36.0 | V | (input) | Above this the chip can be damaged (±18 V). | TI INA149 datasheet / product page, https://www.ti.com/product/INA149
23 | Supply current, typical |  | 0.81 | mA | (input) | Current the chip draws just to run. | TI INA149 datasheet / product page, https://www.ti.com/product/INA149
24 | Supply current, maximum |  | 0.90 | mA | (input) |  | TI INA149 datasheet / product page, https://www.ti.com/product/INA149
25 | Offset voltage, maximum |  | 1.10 | mV | (input) | A small built-in error voltage; becomes an error current of Vos ÷ R7. | TI INA149 datasheet / product page, https://www.ti.com/product/INA149
26 | Gain error, maximum |  | 0.02% |  | (input) | Its internal resistors are trimmed to 0.02 %. | TI INA149 datasheet / product page, https://www.ti.com/product/INA149
27 | Common-mode rejection, minimum |  | 90 | dB | (input) | How well it ignores the large voltage it is floating at. 90 dB = 1 part in 31,600. | TI INA149 datasheet / product page, https://www.ti.com/product/INA149
28 | Output cannot get closer than this to its own supply |  | 1.50 | V | (input) | Datasheet: ±13.5 V swing on ±15 V supplies → 1.5 V short of each rail. | TI INA149 datasheet / product page, https://www.ti.com/product/INA149; TI SLYY054, J. Caldwell, 'A High-Voltage Bidirectional Current Source' (2013), https://www.ti.com/lit/pdf/slyy054 (Eq. 3)
29 | Output short-circuit current |  | 25 | mA | (input) | Most current the chip can push if the output is shorted. Used for the transistor short-circuit check. | TI SLYY054, J. Caldwell, 'A High-Voltage Bidirectional Current Source' (2013), https://www.ti.com/lit/pdf/slyy054 (Eq. 6)
30 | Input resistance from +IN to REF |  | 400 | kΩ | (input) | 380 kΩ + 20 kΩ internal network. Matters only if the driving source has resistance. | INA149 datasheet (internal 380 kΩ/20 kΩ network); deck model 399 kΩ
31 | Slew rate, typical |  | 5.0 | V/µs | (input) | Fastest the output voltage can change. | TI INA149 datasheet / product page, https://www.ti.com/product/INA149
32 | Input common-mode range (at ±15 V supplies) |  | 275 | V | (input) | Inputs may sit this far from the chip's own supply — the property that makes the bootstrap possible. | TI INA149 datasheet / product page, https://www.ti.com/product/INA149
 | U1 — TLE2141 op-amp (copies the load voltage onto REF)
33 | Maximum total supply |  | 44 | V | (input) |  | TI TLE2141 datasheet / product page, https://www.ti.com/product/TLE2141
34 | Supply current, typical |  | 3.40 | mA | (input) |  | TI TLE2141 datasheet / product page, https://www.ti.com/product/TLE2141
35 | Supply current, maximum |  | 4.50 | mA | (input) |  | TI TLE2141 datasheet / product page, https://www.ti.com/product/TLE2141
36 | Offset voltage, maximum |  | 1.40 | mV | (input) | Becomes an error current of Vos ÷ R7. | TI TLE2141 datasheet / product page, https://www.ti.com/product/TLE2141 (most pessimistic grade)
37 | Input bias current, maximum |  | 1.50 | µA | (input) | Its input draws this current out of the load node, so it adds directly to the current error. | TI TLE2141 datasheet / product page, https://www.ti.com/product/TLE2141
38 | Input must stay this far below its + supply |  | 1.8 | V | (input) |  | TI TLE2141 datasheet / product page, https://www.ti.com/product/TLE2141
 | Q1 / Q2 — MJD350 (PNP) / MJD340 (NPN) high-voltage transistors
39 | Maximum collector–emitter voltage |  | 300 | V | (input) | Voltage the transistor can block. | onsemi MJD340/MJD350 datasheet, https://www.onsemi.com/pdf/datasheet/mjd340-d.pdf
40 | Maximum continuous collector current |  | 500 | mA | (input) |  | onsemi MJD340/MJD350 datasheet, https://www.onsemi.com/pdf/datasheet/mjd340-d.pdf
41 | Current gain hFE, minimum | β_min | 30 | - | (input) | Guaranteed minimum at 50 mA. At the few-mA currents used here it may differ; this is the safe assumption. | onsemi MJD340/MJD350 datasheet, https://www.onsemi.com/pdf/datasheet/mjd340-d.pdf
42 | Current gain hFE, typical (estimate) | β_typ | 75 | - | (input) | Chosen so this sheet reproduces the simulated 13.75 kΩ compliance limit. Measure on the bench to confirm. | Fitted to Project LTspice characterisation deck (STIM_Characterized), v4, Oct 2026 (Fig 7)
43 | Power rating with minimal copper at 25 °C ambient |  | 1.56 | W | (input) |  | onsemi MJD340/MJD350 datasheet, https://www.onsemi.com/pdf/datasheet/mjd340-d.pdf
44 | Maximum junction temperature |  | 150 | °C | (input) |  | onsemi MJD340/MJD350 datasheet, https://www.onsemi.com/pdf/datasheet/mjd340-d.pdf
45 | Thermal resistance, junction to air (minimal copper) | θ_JA | 80.1 | °C/W | θ_JA = (Tj_max − 25) / P_D | Degrees of temperature rise per watt. Larger copper area on the PCB lowers it — override if known. | onsemi MJD340/MJD350 datasheet, https://www.onsemi.com/pdf/datasheet/mjd340-d.pdf (derived from 1.56 W rating)
 | Other parts
46 | Input clamp zener BZX84C5V1, lowest voltage |  | 4.80 | V | (input) | Protects the input. A low-tolerance part starts conducting near this voltage. | BZX84C5V1 datasheet (4.8–5.4 V)
47 | Sense resistor R7 tolerance |  | 0.1% |  | (input) | 0.1 % precision resistor assumed. | Deck Step 8 assumption
48 | Ripple leakage at 150 kHz (both rails in phase) |  | 34.0 | µA/V | (input) | Simulated: each volt of rail ripple at 150 kHz pushes 34 µA into the head. Model-dependent (preliminary). | Project LTspice characterisation deck (STIM_Characterized), v4, Oct 2026 Fig 17
49 | Effective output capacitance |  | 36 | pF | (input) | Inferred from the simulated output impedance falling to 4.4 MΩ at 1 kHz. | Project LTspice characterisation deck (STIM_Characterized), v4, Oct 2026 Fig 23
50 | Battery usable capacity |  | 500 | mAh | (input) | Rough alkaline-pack figure; edit for your pack. | Assumption
 | STEP 1 — How the current is set (ideal behaviour)
 | The INA149 makes OUT = command + REF. U1 copies the load voltage onto REF. So the voltage across R7 always equals the command, and the current through R7 (which is the current through the head) equals command ÷ R7 — no matter what the head resistance is.
51 | Current per volt of command (transconductance) | G_m | 1.000 | mA/V | G_m = 1 / R7 | With R7 = 1 kΩ: 1 mA for every 1 V of command. | Derived
52 | Command voltage needed from the DAC | V_in | 10.000 | V | V_in = I × R7 | The DAC must produce this peak voltage. | Derived
53 | Voltage across the head at peak current | V_load | 100.00 | V | V_load = I × R_load (Ohm's law) | The head needs this voltage to carry the current. | Derived
54 | Amplifier output voltage at peak | V_out | 110.00 | V | V_out = V_in + V_load | The amplifier sits above the head by exactly the R7 drop. | Derived
55 | Command stays below the input clamp |  | WARN: clamp may conduct — needs stiff DAC buffer or 6V2 zener |  | V_in < V_Z(min) | If the command reaches the zener voltage the clamp steals input current (accuracy loss with a 50 Ω source). | Deck Step 1 footnote
 | STEP 2 — The floating (bootstrapped) supply at this operating point
 | The op-amps can only take 36–44 V, so they are powered from a ≈20 V 'window' that rides up and down with the output. Q2 (top) and Q1 (bottom) are emitter followers: their emitters copy their base voltage minus V_BE, and they carry the op-amps' current from the high-voltage rails. The base voltages come from the resistor string R1-R2-R3-D1-OUT (and its mirror below). Unlike SLYY054 Eq. 4, the transistor base current is included here, because it is what limits compliance on this board.
56 | Node conductance at the transistor base | G | 0.11131 | 1/kΩ | G = 1/R_top + 1/R_mid | Helper quantity for solving the base voltage (sum of the two currents' paths). | Derived
57 | Fraction of the output change that reaches across R3 | k | 0.1016 | - | k = R_mid / (R_top + R_mid) | Small (≈0.1): this is why the window shrinks only slowly as the output moves. | Derived
58 | Op-amp supply current, both chips, typical | I_Q | 4.21 | mA | I_Q = I_Q(INA149) + I_Q(TLE2141) | Current that flows from the top window rail to the bottom one just to run the chips. | Derived
59 | Op-amp supply current, both chips, maximum | I_Q,max | 5.40 | mA | I_Q,max = sum of maxima |  | Derived
 | Idle (no current, output at 0 V)
60 | Transistor base current at idle | I_B0 | 0.0554 | mA | I_B = I_Q / (β + 1) | The transistor needs only a small base current to pass the chips' supply current. | Derived
61 | Q2 base voltage at idle | V_A0 | 10.25 | V | V_A = (V_rail/R_top + (V_out+V_D)/R_mid − I_B) / G, with V_out = 0 | Current balance at the base node (Kirchhoff): current in from the rail = base current + current down R3. | Derived
62 | Top of the floating supply at idle | V_P0 | 9.60 | V | V_P = V_A − V_BE | Emitter = base − 0.65 V. | Derived
63 | Floating supply width at idle | V_P − V_N | 19.20 | V | Window = 2 × V_P0 (symmetric at idle) | Simulation: ≈19.5 V. The chips see only this, not the ±100 V rails. | Derived
64 | Bias string current at idle | I_str | 1.015 | mA | I_str = (V_rail − V_A0) / R_top | Standing current each string draws from its rail. | Derived
 | At the positive peak (output high, Q2 supplies the load current)
65 | Q2 emitter current at the positive peak | I_E2 | 14.21 | mA | I_E2 = I_Q + I | Q2 must supply the chips AND the stimulation current they deliver to the head. | Derived
66 | Q2 base current at the positive peak | I_B2 | 0.1870 | mA | I_B2 = I_E2 / (β + 1) | This current is stolen from the bias string, which lowers the top of the window. | Derived
67 | Q2 base voltage at the peak | V_A | 107.89 | V | V_A = (V_rail/R_top + (V_out+V_D)/R_mid − I_B2) / G | Kirchhoff current balance at the base node. | Derived
68 | Top of the floating supply at the peak | V_P | 107.24 | V | V_P = V_A − V_BE |  | Derived
69 | Headroom: room between output and top of its supply | V_P − V_out | -2.76 | V | HR = V_P − V_out | Must stay above 1.5 V or the current clips (deck Fig 6: 3.8 V simulated at 10 kΩ). | Derived
70 | Q1 base current at the positive peak (chips only) | I_B1 | 0.0554 | mA | I_B1 = I_Q / (β + 1) |  | Derived
71 | Q1 base voltage at the peak | V_B | 88.57 | V | V_B = ((V_out − V_D)/R_mid − V_rail/R_top + I_B1) / G | Mirror-image balance on the lower string. | Derived
72 | Bottom of the floating supply at the peak | V_N | 89.22 | V | V_N = V_B + V_BE |  | Derived
73 | Room between output and bottom of its supply | V_out − V_N | 20.78 | V | V_out − V_N | Grows as the top shrinks: the window slides off-centre (deck Fig 3: ≈16 V). | Derived
74 | Floating supply width at the peak | V_P − V_N | 18.02 | V | Window = V_P − V_N | Stays near 19 V. | Derived
75 | Operating point inside compliance |  | FAIL: current will clip |  | HR ≥ 1.5 V | If not, the head resistance is too high for this rail voltage. | Derived
76 | Floating supply inside op-amp ratings |  | PASS |  | 4 V ≤ window ≤ 36 V (INA149), ≤ 44 V (TLE2141) |  | Derived
 | STEP 3 — Compliance: the largest head the board can drive at full current
 | Clipping starts when the headroom falls to 1.5 V. Setting HR = 1.5 V in the Step 2 equation and solving for V_out gives the highest output voltage. Three versions: SLYY054's estimate (ignores base current), typical parts, and worst-case parts (lowest β, highest chip current).
77 | Max output voltage — SLYY054 method (no base current) | V_O,max | 85.24 | V | V_O,max = V_rail − HR_min × (R_top + R_mid)/R_mid [SLYY054 Eq. 7–8] | Optimistic: SLYY054 itself says so. | TI SLYY054, J. Caldwell, 'A High-Voltage Bidirectional Current Source' (2013), https://www.ti.com/lit/pdf/slyy054
78 | Max output voltage — typical parts | V_O,max | 68.06 | V | V_O,max = [ (V_rail/R_top + V_D/R_mid − I_B)/G − V_BE − HR_min ] / k, I_B = (I_Q + I)/(β_typ + 1) | Includes the base current Q2 draws at full load. | Derived
79 | Max output voltage — worst-case parts | V_O,max | 40.68 | V | Same, with I_Q,max and β_min | A bad batch of transistors and chips. Design to this. | Derived
80 | Largest head — SLYY054 method | R_max | 7.52 | kΩ | R_max = (V_O,max − V_in) / I |  | TI SLYY054, J. Caldwell, 'A High-Voltage Bidirectional Current Source' (2013), https://www.ti.com/lit/pdf/slyy054
81 | Largest head — typical parts | R_max | 5.81 | kΩ | R_max = (V_O,max − V_in) / I | Simulation (deck Fig 7): 13.75 kΩ at ±100 V. | Derived
82 | Largest head — worst-case parts | R_max | 3.07 | kΩ | R_max = (V_O,max − V_in) / I | If this is below your measured head resistance, raise the rails or stiffen the bias string. | Derived
83 | Voltage 'lost' to the circuit (typical) | V_rail − I·R_max | 41.9 | V | V_lost = V_rail − I × R_max | Roughly constant (~31 V in simulation). Quick rule: R_max ≈ (V_rail − V_lost) / I. | Derived
84 | Rail voltage needed for the entered head — typical parts | V_rail,req | 141.9 | V | V_rail ≥ R_top × [ (V_out·k + V_BE + HR_min)·G − V_D/R_mid + I_B ] | Step 3 equation solved the other way round: what rail is needed for this head? | Derived
85 | Rail voltage needed for the entered head — worst-case parts | V_rail,req | 169.3 | V | Same, with I_Q,max and β_min | Give this number to the power team. | Derived
86 | Head resistance OK with worst-case parts |  | FAIL: raise rails |  | R_load ≤ R_max (worst case) |  | Derived
 | The negative half is a mirror image (Q1 and the lower string), so the same limits apply to negative currents.
 | STEP 4 — Power transistors Q1/Q2 (voltage, heat, short circuit)
 | Each transistor drops the difference between the ±rail and the floating supply. Power = voltage × current turns into heat. The worst case for Q2 is when the output is at its negative peak (largest voltage across Q2), or when the output is shorted.
87 | Q2 voltage at the positive peak | V_CE | -7.2 | V | V_CE = V_rail − V_P |  | Derived
88 | Q2 power at the positive peak | P | -102.8514115 | mW | P = V_CE × I_E2 (V × mA = mW) |  | Derived
89 | Top of the window at the negative peak | V_P | -89.2 | V | Step 2 formula with V_out → −V_out (Q2 carries only the chips' current here) |  | Derived
90 | Q2 voltage at the negative peak | V_CE | 189.2 | V | V_CE = V_rail − V_P |  | Derived
91 | Q2 power at the negative peak | P | 796.6256531 | mW | P = V_CE × I_Q |  | Derived
92 | Highest transistor power, normal operation | P_max | 796.6256531 | mW | P_max = max(P_pos, P_neg) | DC worst case (a sine averages lower). Q1 is the mirror image and sees the same. | Derived
93 | Transistor junction temperature, normal operation | T_j | 103.8321837 | °C | T_j = T_a + P × θ_JA | Keep below ~125 °C for reliability. | Derived
94 | Largest Q2 voltage anywhere in the swing | V_CE,max | 151.5 | V | V_CE at V_out = −V_O,max | Happens at the opposite extreme of the swing. | Derived
95 | Q2 power if the output is shorted (SLYY054 Eq. 6) | P_SC | 2260.02768 | mW | P_SC = (V_rail − V_window/2) × I_SC(INA149) | The chip pushes its full short-circuit current through Q2. | TI SLYY054, J. Caldwell, 'A High-Voltage Bidirectional Current Source' (2013), https://www.ti.com/lit/pdf/slyy054
96 | Transistor temperature during an output short | T_j,SC | 221.0919615 | °C | T_j = T_a + P_SC × θ_JA | SLYY054 used large copper areas for exactly this reason. | Derived
97 | Voltage rating with 80 % derating |  | PASS |  | V_CE,max ≤ 0.8 × V_CEO |  | onsemi MJD340/MJD350 datasheet, https://www.onsemi.com/pdf/datasheet/mjd340-d.pdf
98 | Temperature, normal operation |  | PASS |  | T_j ≤ 125 °C |  | Derived
99 | Survives an output short |  | FAIL: add copper area / current limit |  | T_j,SC ≤ 150 °C | Lower θ_JA (bigger copper pour) in Section 3 to see how much copper is needed. | Derived
 | STEP 5 — Op-amp input limits
 | Each chip's inputs must stay inside a range set by its own (floating) supply.
100 | U1 input distance below its + supply | V_P − V_load | 7.24 | V | V_P − V_load | U1's input sits at the head voltage; it must stay 1.8 V below the top of the window. | Derived
101 | U1 input inside its range |  | PASS |  | V_P − V_load ≥ 1.8 V |  | TI TLE2141 datasheet / product page, https://www.ti.com/product/TLE2141
102 | INA149 inputs' distance from its floating supply | |V_out| | 110.0 | V | |V_out − 0| | The inputs sit near 0 V while the chip floats at V_out. | Derived
103 | INA149 common-mode inside ±275 V |  | PASS |  | |V_out| ≤ 275 V | Specified at ±15 V supplies; the chip runs on ≈±10 V here — confirm against the datasheet curve. | TI INA149 datasheet / product page, https://www.ti.com/product/INA149
 | STEP 6 — Accuracy budget (worst case)
 | Every imperfection adds a small error. Offsets add a FIXED error current (dominant at small currents); gain-type errors add a FIXED PERCENTAGE. The worst-case total assumes every error pushes the same way; the RSS total is a more realistic estimate.
104 | Fixed error current from offsets and bias current | I_off | 4.00 | µA | I_off = Vos(INA)/R7 + Vos(TLE)/R7 + I_B(TLE) (mV/kΩ = µA) | Deck Fig 24: ≈4.0 µA. Flows even with zero command. | Derived
105 | … as a fraction of the current | ε_off | 0.040% |  | ε_off = I_off / I |  | Derived
106 | Gain errors (INA149 trim + R7 tolerance) | ε_gain | 0.120% |  | ε_gain = ε_INA + ε_R7 |  | Derived
107 | CMRR as a ratio | CMRR | 31622.7766 | - | CMRR = 10^(dB/20) |  | Derived
108 | Error from finite common-mode rejection | ε_CMRR | 0.032% |  | ε_CMRR = R_load / (R7 × CMRR) | Grows with head resistance. | Derived
109 | Error from the driving source resistance | ε_src | 0.000% |  | ε_src = R_src × R_load / (R7 × R_in) | Deck: 50 Ω generator into 10 kΩ → ≈0.11–0.125 %. Zero with an ideal buffer. | Derived
110 | Total error, worst case | ε_WC | 0.19% |  | ε_WC = sum of all terms | Deck: 0.95 % at 0.5 mA, 0.23 % at 5 mA (10 kΩ, ideal source). | Derived
111 | Total error, statistical (RSS) | ε_RSS | 0.11% |  | ε_RSS = √(Σ terms²) | Typical spread across many boards (deck Monte Carlo is in between). | Derived
112 | Smallest current that meets the accuracy target | I_min | 0.471 | mA | I_min = I_off / (ε_KPI − ε_gain − ε_CMRR − ε_src) | Below this, offsets dominate; a stored zero calibration removes most of them. | Derived
113 | Accuracy target met at this current |  | PASS |  | ε_WC ≤ ε_KPI |  | Derived
 | STEP 7 — Output impedance (how 'stiff' the current source is)
 | An ideal current source has infinite output impedance: the current does not change when the head resistance changes. Here it is limited by the INA149's common-mode rejection (and by the driving source's resistance).
114 | Limit set by CMRR | Z_CMRR | 31.6 | MΩ | Z = R7 × CMRR |  | Derived
115 | Limit set by the driving source | Z_src | 1000000.0 | MΩ | Z = R7 × R_in / R_src (very large if R_src = 0) | 50 Ω source → ≈8 MΩ (deck Fig 23). | Derived
116 | Output impedance near DC | Z_out | 31.6 | MΩ | Z_out = Z_CMRR ∥ Z_src | Deck Fig 23: 35 MΩ with worst-case CMRR. | Derived
117 | Current change when the head changes by R_load (near DC) | ΔI/I | 0.032% |  | ΔI/I ≈ R_load / Z_out |  | Derived
118 | Output capacitance reactance at 1 kHz | X_C | 4.42 | MΩ | X_C = 1 / (2π f C_out) | Above ~100 Hz the output impedance is set by this capacitance (deck Fig 23: 4.4 MΩ at 1 kHz). | Derived
119 | Timing lag this causes at R_load | τ | 0.36 | µs | τ = R_load × C_out (kΩ × pF = ns) | A timing shift, not an amplitude error (deck Fig 12: 0.39 µs at 10 kΩ). | Derived
 | STEP 8 — Supply ripple allowance (PRELIMINARY)
 | Ripple on the ±rails leaks into the head. In simulation the leakage grows in proportion to frequency up to ~300 kHz, then peaks near 0.8 MHz. Valid only for switching frequencies up to ~300 kHz; above that read deck Fig 18. The value depends on op-amp supply rejection, so confirm on the bench.
120 | Leakage per volt of ripple at f_sw | k(f) | 34.0 | µA/V | k(f) = k₁₅₀ × f_sw / 150 kHz |  | Project LTspice characterisation deck (STIM_Characterized), v4, Oct 2026
121 | Largest allowed ripple on each rail | V_pp | 294.1176471 | mVpp | V_pp = 2 × I_rip / k(f) | Deck Fig 18: 290 mVpp at 150 kHz. | Derived
122 | Switching frequency inside this formula's valid range |  | PASS |  | f_sw ≤ 300 kHz |  | Derived
 | STEP 9 — Speed (how fast a full-current waveform can be)
 | The INA149 output can only change at 5 V/µs. A sine wave of peak voltage V needs a slope of 2πfV, which sets the highest full-amplitude frequency.
123 | Highest frequency at full current into this head | f_max | 7.2 | kHz | f_max = SR / (2π × V_out) | Conservative: uses the datasheet typical 5 V/µs. SLYY054 measured ≈31 V/µs (50 kHz at ±10 mA into 10 kΩ), so the real board is likely faster. | TI SLYY054, J. Caldwell, 'A High-Voltage Bidirectional Current Source' (2013), https://www.ti.com/lit/pdf/slyy054; TI INA149 datasheet / product page, https://www.ti.com/product/INA149
124 | Required band reachable at full current |  | PASS |  | f_max ≥ f_KPI |  | Derived
 | Small-signal settling (≤5.4 µs to 1 %) and the loop's light damping (ζ ≈ 0.25–0.5) come from simulation only — see deck Steps 3 and 7.
 | STEP 10 — Power budget (for the battery / power team)
 | Peak current each rail must supply per channel: bias strings + op-amps + stimulation current. Conservative (uses the peak, not the average).
125 | Standing current per rail, per channel | I_stand | 5.23 | mA | I_stand = I_str + I_Q | Flows from both rails all the time, even with no stimulation. | Derived
126 | Power from both rails, per channel (at peak current) | P_ch | 2045.056804 | mW | P = V_rail × (2·I_stand + I) | The stimulation current comes from only one rail at a time (+rail for positive, −rail for negative). | Derived
127 | Total rail power, all channels | P_tot | 2045.056804 | mW | P_tot = N × P_ch |  | Derived
128 | Battery current | I_bat | 142.0178336 | mA | I_bat = P_tot / (η × V_bat) |  | Derived
129 | Battery life at this (peak) load | t | 3.5 | h | t = capacity / I_bat | Pessimistic: real stimulation averages well below peak. | Derived
 | NOT COMPUTED HERE — results that need simulation or the bench
 | Supply faults (deck Step 5): out-of-order power-up → 21.9 mA pulse; loss of one rail → ≈9.7 mA continuous (model estimates). Requires an output disconnect + independent current limit.
 | Loop stability (deck Step 7): stable in simulation but lightly damped (ζ ≈ 0.25 at 1 kΩ, ≈0.5 at 10 kΩ). Bench check: step response into 1 kΩ and 10 kΩ.
 | Ripple above 300 kHz, harmonics, and op-amp supply rejection (deck Step 6). Electrode–skin impedance (must be measured, then entered in Section 1).
