WeymenKoo/STIM-Rev1-Hardware/02_rev1_channel/Kicad Projects/STIM_Rev1/Manufacturing/README.md

# Manufacturing

Filled after layout: Fabrication Toolkit writes Gerbers, drill, BoM and CPL here.
