WeymenKoo/STIM-Rev1-Hardware/01_client_board/tests/A3-step-settling/A3_30V_5mA.png

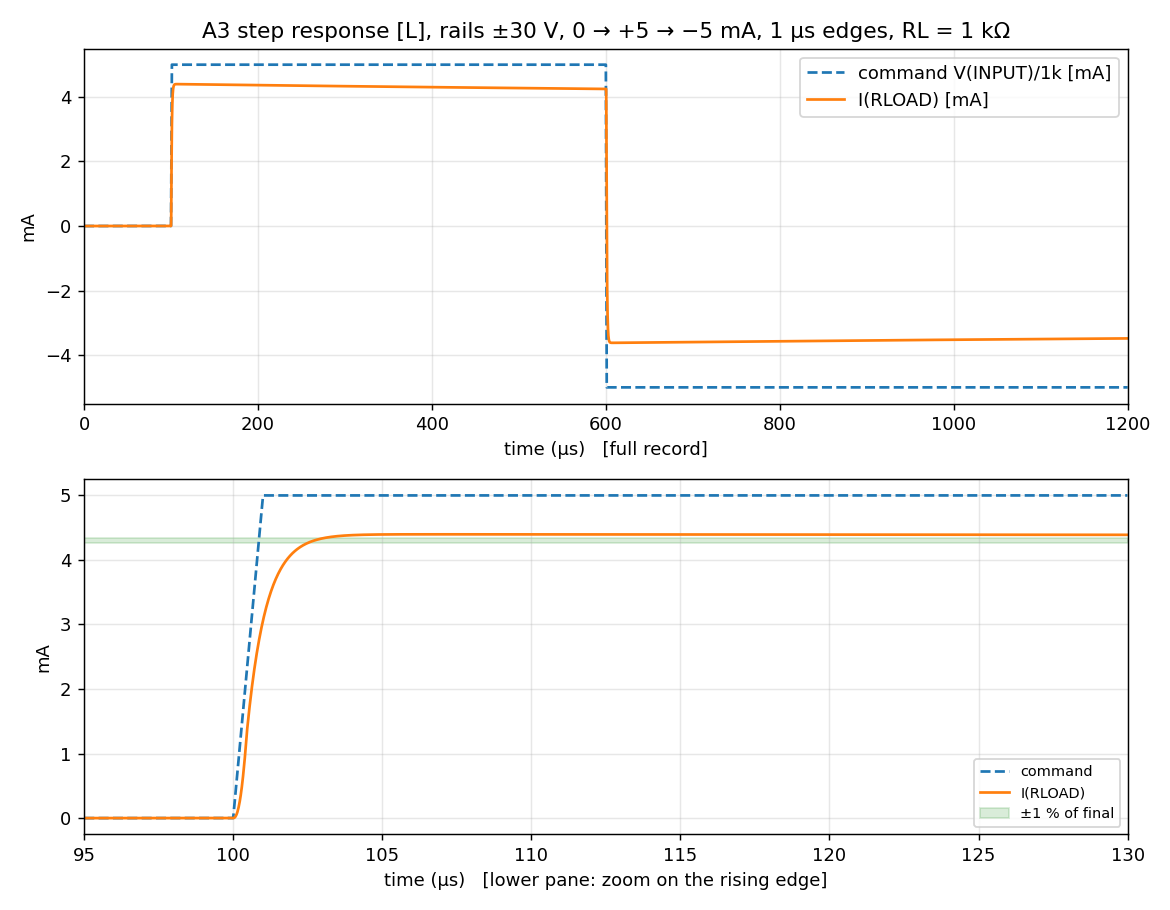
01_client_board/tests/A3-step-settling/A3_30V_5mA.png
