WeymenKoo/STIM-Rev1-Hardware/01_client_board/tests/bench/preflight_tbs_gen_flatness.csv

f_Hz | Vpk_fit | Vpp_scope | dB_vs_10Hz
1 | 0.017846824046606747 | 4.04 | -0.0005819212876817438
10 | 0.01784801975541302 | 4.04 | 0.0
100 | 1.9927898515680234 | 4.0067 | 40.957429297476715
300 | 1.9941439652450488 | 4.0111 | 40.96332941167408
1000.0 | 1.9976467337587187 | 4.0184 | 40.97857303081171
10000.0 | 2.010438410187281 | 4.0355 | 41.034014700827335
100000.0 | 2.0260671629263673 | 4.0664 | 41.101275997694756
