WeymenKoo/STIM-Rev1-Hardware/01_client_board/tests/bench/preflight_tbs_probecomp_ch1.csv

t_s | CH1
-0.0032 | -0.0425
-0.0031968 | -0.0540625
-0.0031936 | -0.0565625
-0.0031904000000000004 | -0.0615625
-0.0031872000000000003 | -0.0584375
-0.003184 | -0.0428125
-0.0031808 | -0.0365625
-0.0031776 | -0.03125
-0.0031744 | -0.06
-0.0031712000000000003 | -0.026875
-0.0031680000000000002 | -0.043125000000000004
-0.0031648 | -0.050625
-0.0031616 | -0.0409375
-0.0031584 | -0.045
-0.0031552000000000004 | -0.041875
-0.0031520000000000003 | -0.051562500000000004
-0.0031488 | -0.0271875
-0.0031456 | -0.0325
-0.0031424 | -0.030625
-0.0031392 | -0.056875
-0.0031360000000000003 | -0.0371875
-0.0031328000000000003 | -0.051250000000000004
-0.0031296 | -0.0303125
-0.0031264 | -0.03375
-0.0031232 | -0.0275
-0.0031200000000000004 | -0.051562500000000004
-0.0031168000000000003 | -0.04
-0.0031136000000000002 | -0.04
-0.0031104 | -0.03875
-0.0031072 | -0.0340625
-0.003104 | -0.04125
-0.0031008000000000003 | -0.0346875
-0.0030976000000000003 | -0.0228125
-0.0030944 | -0.0309375
-0.0030912 | -0.0309375
-0.003088 | -0.03625
-0.0030848 | -0.0471875
-0.0030816000000000003 | -0.0403125
-0.0030784000000000002 | -0.03
-0.0030752 | -0.0490625
-0.003072 | -0.0453125
-0.0030688 | -0.0340625
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
