WeymenKoo/STIM-Rev1-Hardware/01_client_board/tests/bench/preflight_tbs_probecomp_ch2.csv

t_s | CH2
-0.0032 | -0.00875
-0.0031968 | -0.00875
-0.0031936 | -0.015
-0.0031904000000000004 | -0.0071875
-0.0031872000000000003 | -0.0046875
-0.003184 | -0.00375
-0.0031808 | -0.010937500000000001
-0.0031776 | -0.012812500000000001
-0.0031744 | -0.00875
-0.0031712000000000003 | -0.00875
-0.0031680000000000002 | -0.021562500000000002
-0.0031648 | -0.00375
-0.0031616 | 0.0
-0.0031584 | -0.0084375
-0.0031552000000000004 | -0.0153125
-0.0031520000000000003 | -0.006875
-0.0031488 | -0.0175
-0.0031456 | -0.00625
-0.0031424 | -0.012812500000000001
-0.0031392 | -0.010625
-0.0031360000000000003 | -0.006875
-0.0031328000000000003 | -0.01125
-0.0031296 | -0.0103125
-0.0031264 | -0.0115625
-0.0031232 | -0.0046875
-0.0031200000000000004 | -0.0096875
-0.0031168000000000003 | 0.0
-0.0031136000000000002 | -0.004375
-0.0031104 | -0.020625
-0.0031072 | -0.005
-0.003104 | -0.00625
-0.0031008000000000003 | -0.01375
-0.0030976000000000003 | -0.0203125
-0.0030944 | -0.0040625
-0.0030912 | -0.0190625
-0.003088 | -0.010625
-0.0030848 | -0.0190625
-0.0030816000000000003 | -0.005625
-0.0030784000000000002 | -0.0115625
-0.0030752 | 0.0
-0.003072 | -0.008125
-0.0030688 | -0.014375
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
