WeymenKoo/STIM-Rev1-Hardware/01_client_board/tests/B0-bringup/bench/B0_pm05p0V.csv

t_s | V+ (CH1) | V- (CH2)
-0.008 | 3.9115625 | 2.6546875
-0.007992 | 3.91875 | 2.666875
-0.007984 | 3.9225 | 2.658125
-0.007976 | 3.9228125 | 2.6590625
-0.007968 | 3.915625 | 2.6565625
-0.00796 | 3.9203125 | 2.6584375000000002
-0.007952 | 3.916875 | 2.65875
-0.007944 | 3.9146875 | 2.6534375
-0.007936 | 3.91875 | 2.6671875000000003
-0.007928000000000001 | 3.92875 | 2.6578125
-0.00792 | 3.90875 | 2.666875
-0.007912 | 3.9146875 | 2.6584375000000002
-0.007904 | 3.9246875 | 2.658125
-0.007896 | 3.9234375 | 2.6621875
-0.007888000000000001 | 3.9196875 | 2.6621875
-0.00788 | 3.92375 | 2.6584375000000002
-0.007872 | 3.9228125 | 2.6621875
-0.007864 | 3.9234375 | 2.658125
-0.007856 | 3.9103125000000003 | 2.658125
-0.007848 | 3.9234375 | 2.6553125
-0.00784 | 3.9246875 | 2.6621875
-0.007832 | 3.9103125000000003 | 2.6621875
-0.007824 | 3.9196875 | 2.6621875
-0.007816 | 3.9165625 | 2.6621875
-0.007808 | 3.9146875 | 2.6621875
-0.0078000000000000005 | 3.9103125000000003 | 2.6621875
-0.007792 | 3.915625 | 2.658125
-0.007784 | 3.915625 | 2.6621875
-0.007776 | 3.9162500000000002 | 2.6634375
-0.007768000000000001 | 3.9196875 | 2.6571875
-0.00776 | 3.9109375 | 2.6553125
-0.007752 | 3.91875 | 2.666875
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
