WeymenKoo/STIM-Rev1-Hardware/01_client_board/tests/B0-bringup/bench/B0_pm05p0V_run2_raw.csv

# TBS1102C CURVe? counts, LSB-first order (re-decoded 2026-11-06 from the first write, where the byte-order guess had swapped some records); V = (counts - YOFF) * YMULT + YZERO; t = XZERO + (n - PT_OFF) * XINCR
# CH1 @1.9s | YMULT=0.0003125 | YOFF=0.0 | YZERO=0.0 | XINCR=8e-06 | XZERO=-0.008 | PT_OFF=0.0 | width=2 | byte_order=little
# CH2 @1.9s | YMULT=0.0003125 | YOFF=0.0 | YZERO=0.0 | XINCR=8e-06 | XZERO=-0.008 | PT_OFF=0.0 | width=2 | byte_order=little
# CH1 @3.1s | YMULT=0.0003125 | YOFF=0.0 | YZERO=0.0 | XINCR=8e-06 | XZERO=-0.008 | PT_OFF=0.0 | width=2 | byte_order=little
# CH2 @3.1s | YMULT=0.0003125 | YOFF=0.0 | YZERO=0.0 | XINCR=8e-06 | XZERO=-0.008 | PT_OFF=0.0 | width=2 | byte_order=little
# CH1 @4.4s | YMULT=0.0003125 | YOFF=0.0 | YZERO=0.0 | XINCR=8e-06 | XZERO=-0.008 | PT_OFF=0.0 | width=2 | byte_order=little
# CH2 @4.4s | YMULT=0.0003125 | YOFF=0.0 | YZERO=0.0 | XINCR=8e-06 | XZERO=-0.008 | PT_OFF=0.0 | width=2 | byte_order=little
# CH1 @5.6s | YMULT=0.0003125 | YOFF=0.0 | YZERO=0.0 | XINCR=8e-06 | XZERO=-0.008 | PT_OFF=0.0 | width=2 | byte_order=little
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
