WeymenKoo/STIM-Rev1-Hardware/01_client_board/tests/B0-bringup/bench/B0_pm05p0V_run2_startup.csv

t_s | V+ (CH1) | V- (CH2)
-0.32 | -0.08 | 0.0
-0.31968 | -0.08 | 0.0
-0.31936000000000003 | -0.08 | -0.08
-0.31904 | -0.08 | 0.0
-0.31872 | -0.08 | -0.08
-0.3184 | -0.08 | 0.0
-0.31808000000000003 | -0.08 | -0.08
-0.31776 | -0.08 | 0.0
-0.31744 | -0.08 | 0.0
-0.31712 | -0.08 | -0.08
-0.3168 | -0.08 | -0.08
-0.31648 | -0.08 | 0.0
-0.31616 | -0.08 | -0.08
-0.31584 | -0.08 | -0.08
-0.31552 | -0.16 | 0.0
-0.3152 | -0.08 | 0.0
-0.31488 | -0.08 | 0.0
-0.31456 | -0.08 | 0.0
-0.31424 | -0.08 | 0.0
-0.31392000000000003 | -0.08 | 0.0
-0.3136 | -0.08 | -0.08
-0.31328 | -0.08 | 0.0
-0.31296 | -0.08 | -0.08
-0.31264000000000003 | -0.16 | 0.0
-0.31232 | -0.08 | -0.08
-0.312 | -0.08 | -0.08
-0.31168 | -0.08 | -0.08
-0.31136 | -0.08 | 0.0
-0.31104 | -0.08 | 0.0
-0.31072 | -0.08 | -0.08
-0.3104 | -0.08 | 0.0
-0.31008 | -0.08 | -0.08
-0.30976 | 0.0 | 0.0
-0.30944 | -0.08 | -0.08
-0.30912 | -0.08 | 0.0
-0.3088 | -0.08 | -0.08
-0.30848000000000003 | -0.08 | 0.0
-0.30816 | -0.16 | 0.0
-0.30784 | -0.08 | 0.0
-0.30752 | -0.16 | -0.08
-0.30720000000000003 | -0.08 | -0.08
-0.30688 | -0.16 | -0.08
-0.30656 | -0.08 | -0.08
-0.30624 | -0.08 | -0.08
-0.30592 | -0.08 | 0.0
-0.3056 | 0.0 | 0.0
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
