WeymenKoo/STIM-Rev1-Hardware/01_client_board/tests/B0-bringup/bench/B0_pm05p0V_run2_startup_raw.csv

# TBS1102C CURVe? counts; V = (counts - YOFF) * YMULT + YZERO; t = XZERO + (n - PT_OFF) * XINCR
# CH1 | YMULT=0.0003125 | YOFF=0.0 | YZERO=0.0 | XINCR=0.00032 | XZERO=-0.32 | PT_OFF=0.0 | width=2 | byte_order=little
# CH2 | YMULT=0.0003125 | YOFF=0.0 | YZERO=0.0 | XINCR=0.00032 | XZERO=-0.32 | PT_OFF=0.0 | width=2 | byte_order=little
n | CH1 counts | CH2 counts
0 | -256 | 0
1 | -256 | 0
2 | -256 | -256
3 | -256 | 0
4 | -256 | -256
5 | -256 | 0
6 | -256 | -256
7 | -256 | 0
8 | -256 | 0
9 | -256 | -256
10 | -256 | -256
11 | -256 | 0
12 | -256 | -256
13 | -256 | -256
14 | -512 | 0
15 | -256 | 0
16 | -256 | 0
17 | -256 | 0
18 | -256 | 0
19 | -256 | 0
20 | -256 | -256
21 | -256 | 0
22 | -256 | -256
23 | -512 | 0
24 | -256 | -256
25 | -256 | -256
26 | -256 | -256
27 | -256 | 0
28 | -256 | 0
29 | -256 | -256
30 | -256 | 0
31 | -256 | -256
32 | 0 | 0
33 | -256 | -256
34 | -256 | 0
35 | -256 | -256
36 | -256 | 0
37 | -512 | 0
38 | -256 | 0
39 | -512 | -256
40 | -256 | -256
41 | -512 | -256
42 | -256 | -256
43 | -256 | -256
44 | -256 | 0
45 | 0 | 0
46 | -256 | -256
47 | 0 | -256
48 | -256 | -256
49 | -256 | -256
50 | -512 | -256
51 | -256 | -256
52 | -256 | -256
53 | -512 | 0
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
