WeymenKoo/STIM-Rev1-Hardware/01_client_board/tests/B0-bringup/bench/B0_pm05p0V_run2_trend.csv

t_since_on_s | Vplus_V | Vminus_V | Vplus_minus_Vminus_V | ptp_Vplus_V | ptp_Vminus_V
1.9 | 4.4857 | 3.0522 | 1.4334 | 0.08 | 0.16
3.1 | 4.4857 | 3.0533 | 1.4324 | 0.06 | 0.11
4.4 | 4.4855 | 3.0513 | 1.4342 | 0.06 | 0.08
5.6 | 4.4854 | 3.0525 | 1.4329 | 0.06 | 0.1
6.9 | 4.4866 | 3.0517 | 1.4349 | 0.08 | 0.08
8.1 | 4.4855 | 3.0492 | 1.4363 | 0.06 | 0.08
9.4 | 4.4863 | 3.0483 | 1.4381 | 0.06 | 0.08
10.6 | 4.4856 | 3.0483 | 1.4373 | 0.08 | 0.08
11.9 | 4.4858 | 3.0474 | 1.4384 | 0.08 | 0.08
13.1 | 4.4863 | 3.0482 | 1.4381 | 0.06 | 0.11
14.4 | 4.4872 | 3.0495 | 1.4377 | 0.08 | 0.11
15.6 | 4.4863 | 3.0472 | 1.4391 | 0.08 | 0.11
16.9 | 4.4864 | 3.0471 | 1.4392 | 0.06 | 0.08
18.2 | 4.4898 | 3.0477 | 1.4421 | 0.08 | 0.08
19.4 | 4.4871 | 3.0469 | 1.4402 | 0.08 | 0.06
20.7 | 4.4857 | 3.0469 | 1.4388 | 0.08 | 0.08
21.9 | 4.4874 | 3.047 | 1.4405 | 0.08 | 0.09
