WeymenKoo/STIM-Rev1-Hardware/01_client_board/tests/B0-bringup/bench/B0_pm05p0V_run2_wave.csv

t_s | V+ @1.9s | V- @1.9s | V+ @3.1s | V- @3.1s | V+ @4.4s | V- @4.4s | V+ @5.6s | V- @5.6s | V+ @6.9s | V- @6.9s | V+ @8.1s | V- @8.1s | V+ @9.4s | V- @9.4s | V+ @10.6s | V- @10.6s | V+ @11.9s | V- @11.9s | V+ @13.1s | V- @13.1s | V+ @14.4s | V- @14.4s | V+ @15.6s | V- @15.6s | V+ @16.9s | V- @16.9s | V+ @18.2s | V- @18.2s | V+ @19.4s | V- @19.4s | V+ @20.7s | V- @20.7s | V+ @21.9s | V- @21.9s
-0.008 | 4.48 | 3.04 | 4.48 | 3.0100000000000002 | 4.48 | 3.0700000000000003 | 4.48 | 3.04 | 4.51 | 3.04 | 4.48 | 3.0700000000000003 | 4.48 | 3.04 | 4.48 | 3.04 | 4.48 | 3.04 | 4.48 | 3.04 | 4.48 | 3.04 | 4.48 | 3.04 | 4.48 | 3.04 | 4.5 | 3.04 | 4.48 | 3.09 | 4.48 | 3.04 | 4.51 | 3.04
-0.007992 | 4.48 | 3.04 | 4.48 | 3.04 | 4.48 | 3.04 | 4.48 | 3.04 | 4.51 | 3.04 | 4.48 | 3.04 | 4.48 | 3.04 | 4.51 | 3.0700000000000003 | 4.5 | 3.04 | 4.48 | 3.04 | 4.48 | 3.0700000000000003 | 4.54 | 3.04 | 4.48 | 3.04 | 4.51 | 3.0700000000000003 | 4.51 | 3.04 | 4.48 | 3.04 | 4.48 | 3.04
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
