WeymenKoo/STIM-Rev1-Hardware/01_client_board/tests/A1-bias-bootstrap/A1_100V_5mA.png

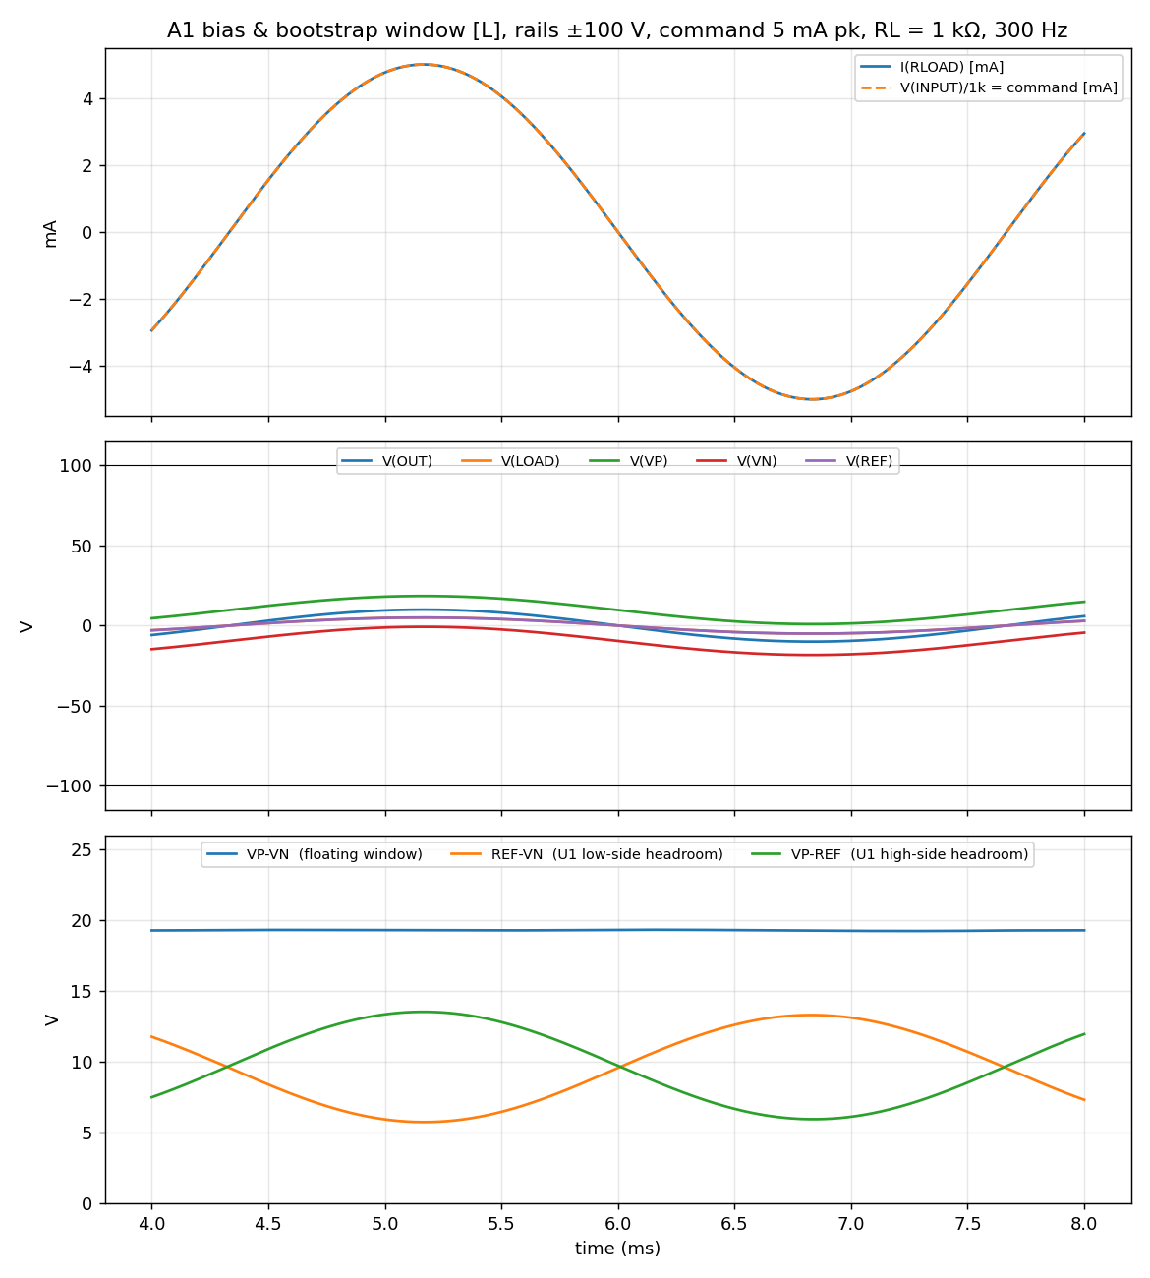
01_client_board/tests/A1-bias-bootstrap/A1_100V_5mA.png
