WeymenKoo/STIM-Rev1-Hardware/01_client_board/tests/A2-accuracy-vs-command/A2_100V.png

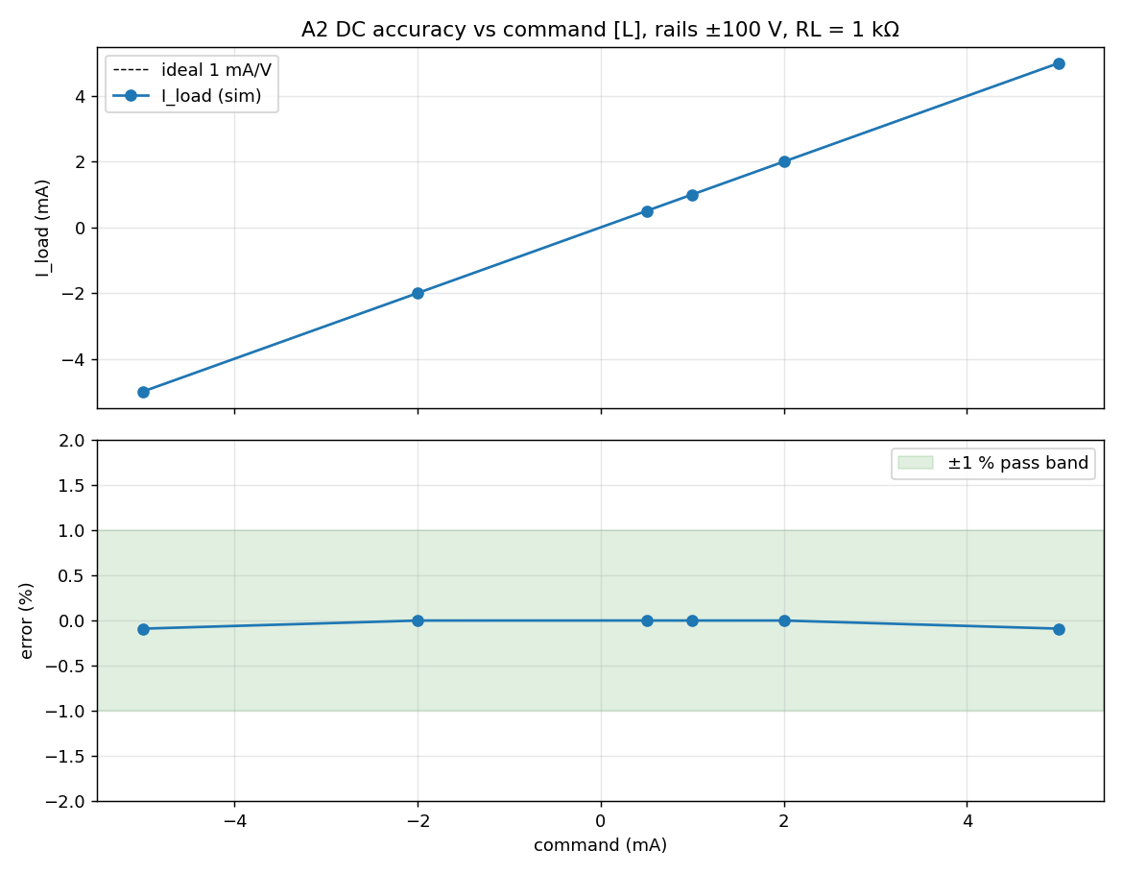
01_client_board/tests/A2-accuracy-vs-command/A2_100V.png
