WeymenKoo/STIM-Rev1-Hardware/01_client_board/tests/A5a-output-impedance-ac/A5a_30V.png

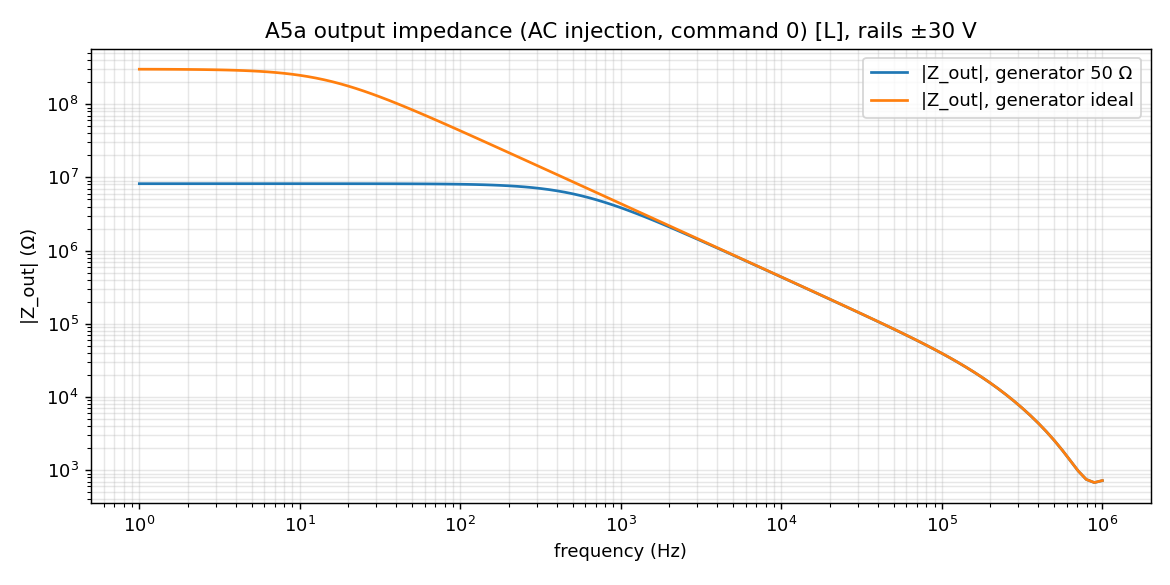
01_client_board/tests/A5a-output-impedance-ac/A5a_30V.png
