WeymenKoo/STIM-Rev1-Hardware/01_client_board/tests/A7-rail-loss/A7_100V.png

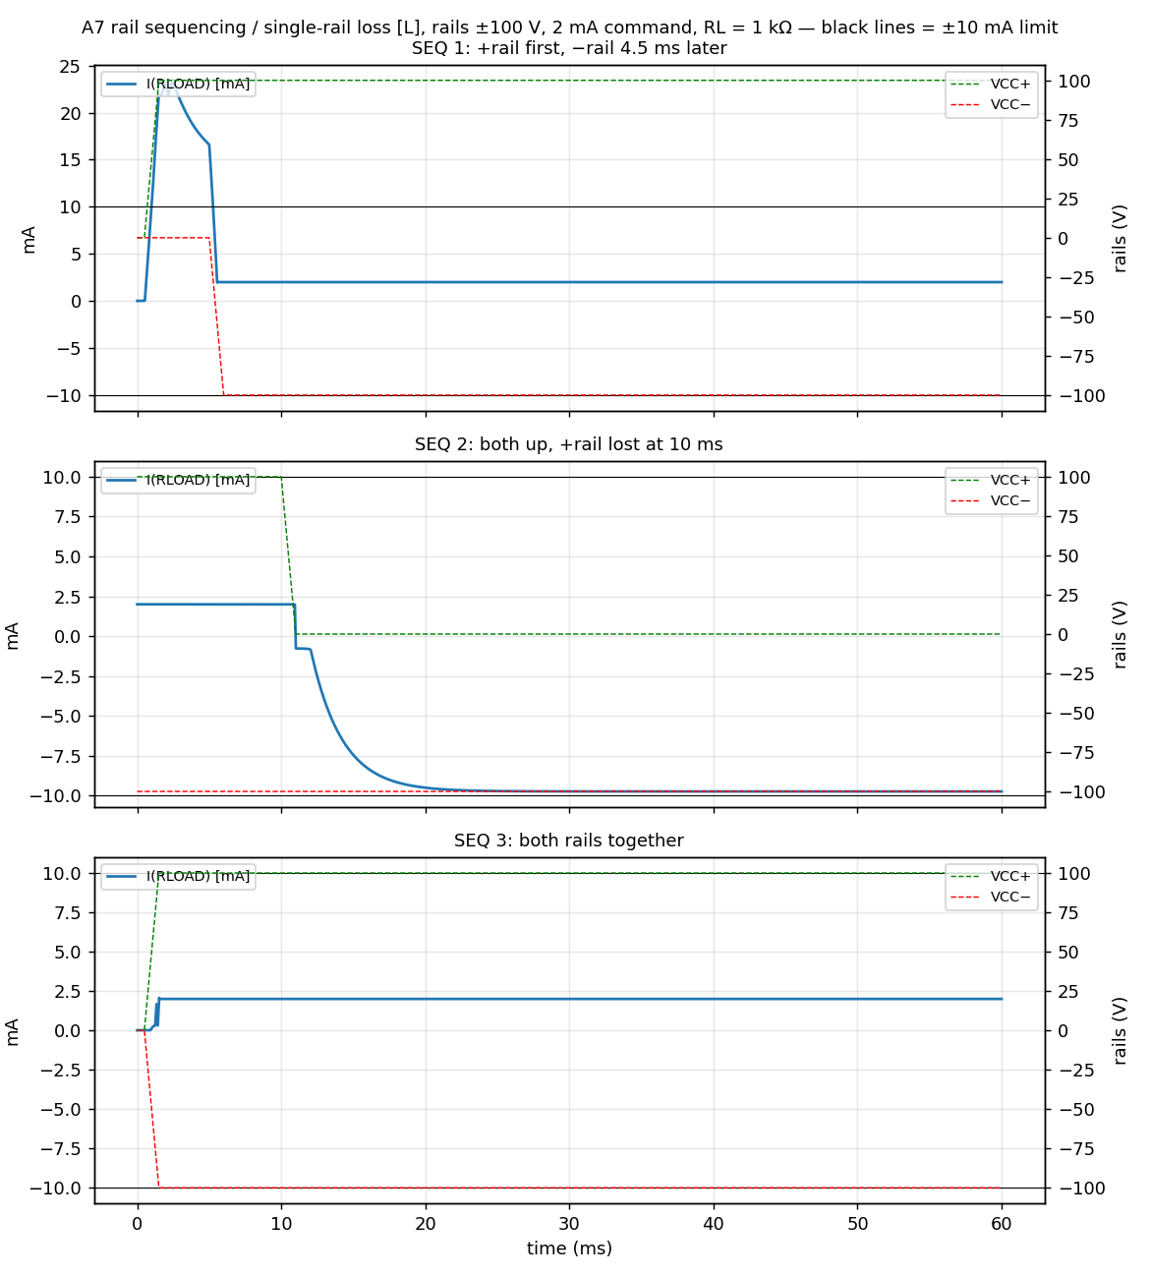
01_client_board/tests/A7-rail-loss/A7_100V.png
