WeymenKoo/STIM-Rev1-Hardware/01_client_board/tests/B0-bringup/bench/B0_pm05p0V.png

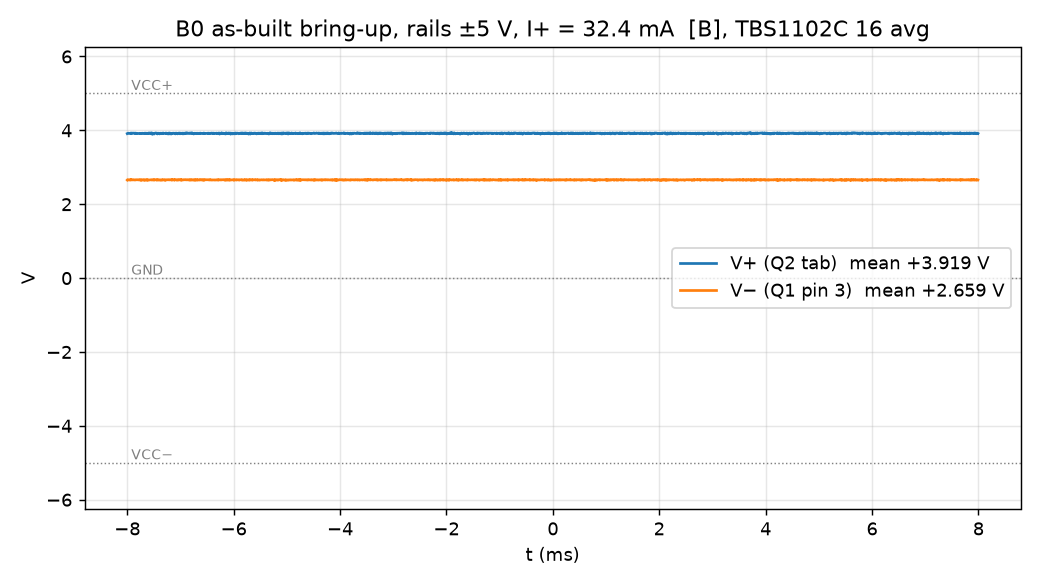
01_client_board/tests/B0-bringup/bench/B0_pm05p0V.png
