WeymenKoo/STIM-Rev1-Hardware/01_client_board/tests/B0-bringup/bench/B0_pm05p75V_heat_noRL.png

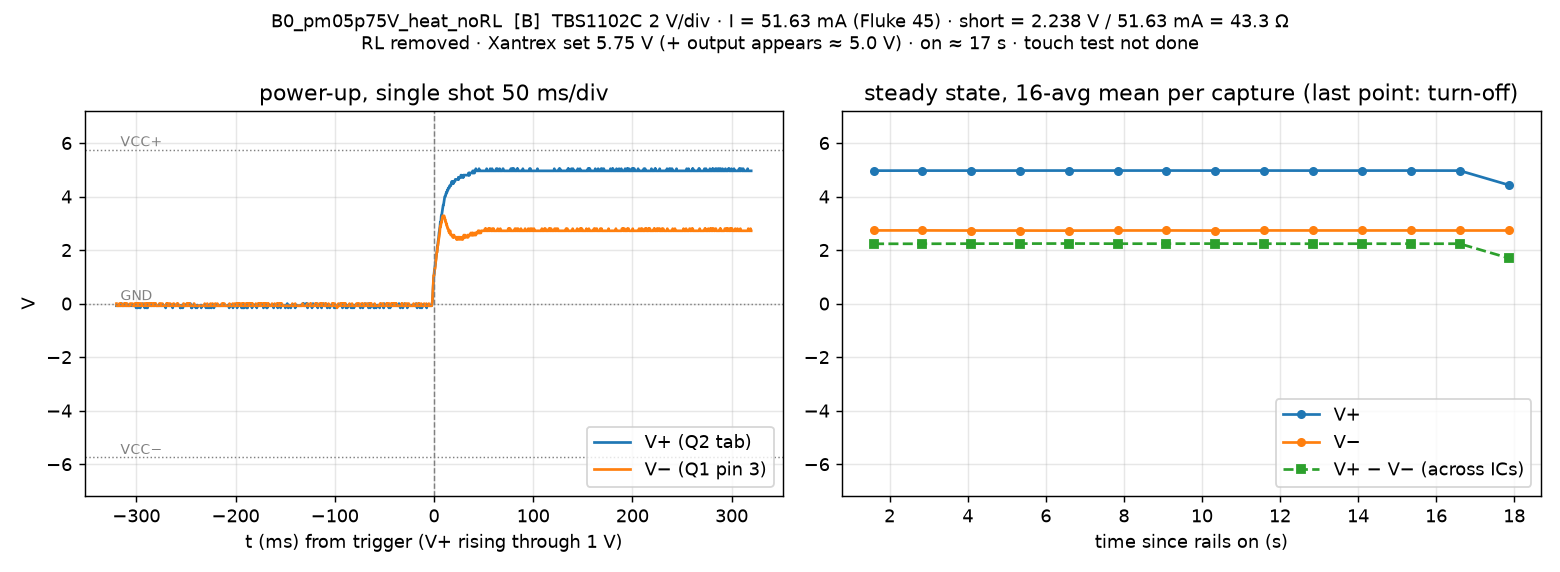
01_client_board/tests/B0-bringup/bench/B0_pm05p75V_heat_noRL.png
