WeymenKoo/STIM-Rev1-Hardware/02_rev1_channel/Kicad Projects/STIM_Rev1/Schematic/STIM_Rev1.pdf

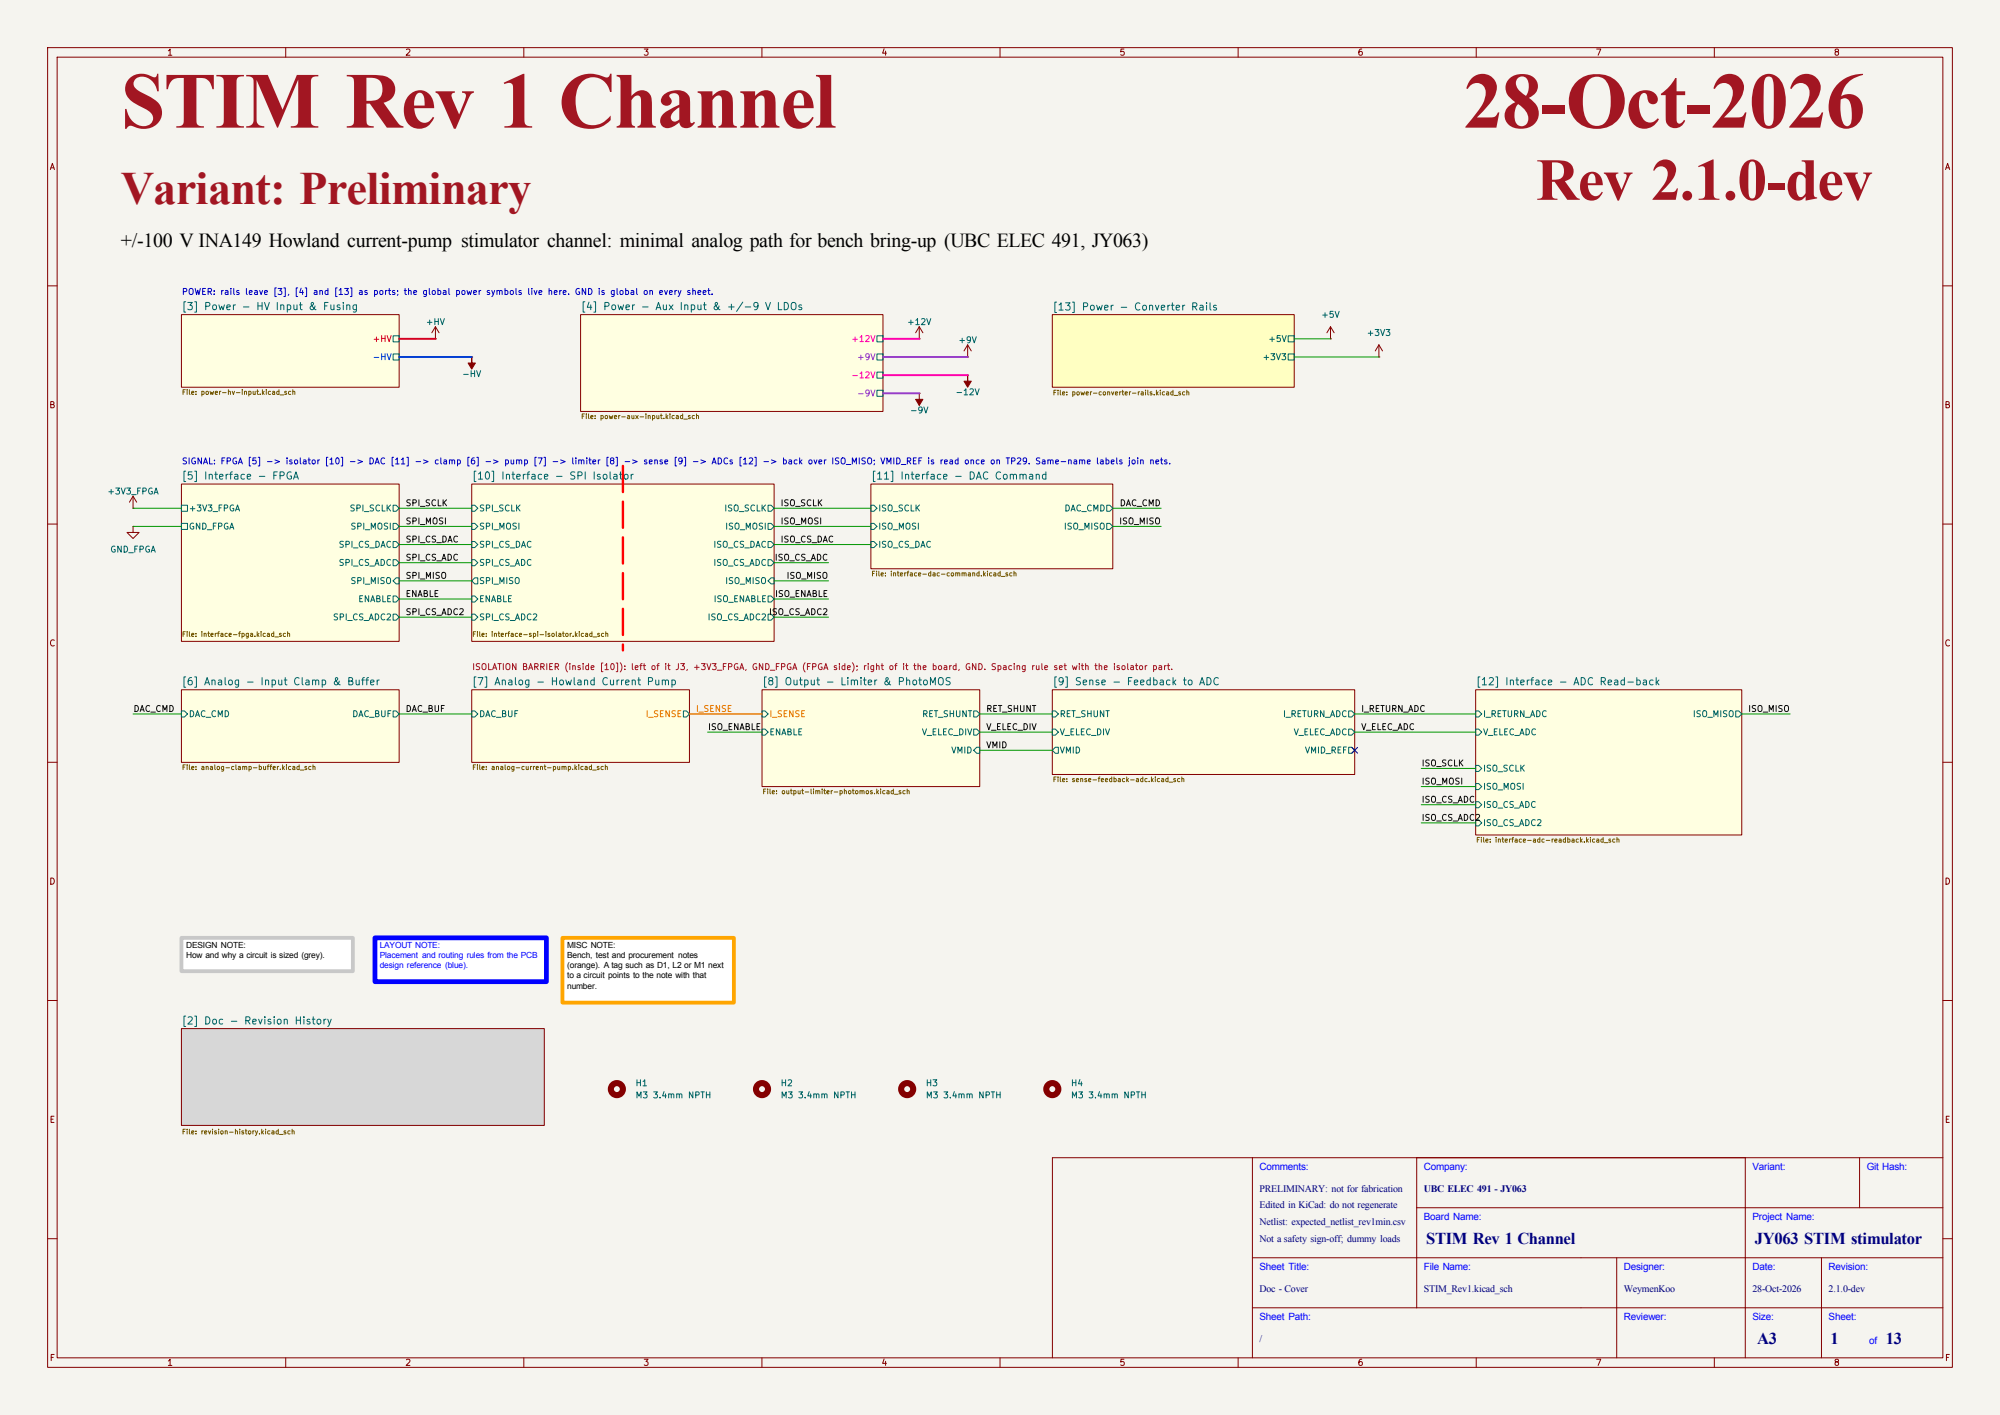
[picture p98: page 1]

+/-100 V INA149 Howland current-pump stimulator channel: minimal analog path for bench bring-up (UBC ELEC 491, JY063)

POWER: rails leave [3], [4] and [13] as ports; the global power symbols live here. GND is global on every sheet. SIGNAL: FPGA [5] -> isolator [10] -> DAC [11] -> clamp [6] -> pump [7] -> limiter [8] -> sense [9] -> ADCs [12] -> back over ISO_MISO; VMID_REF is read once on TP29. Same-name labels join nets.
[3] Power - HV Input & Fusing

[4] Power - Aux Input & +/-9 V LDOs

File: power-aux-input.kicad_sch +HV -HV

File: interface-adc-readback.kicad_sch +12V +9V -12V -9V

File: power-converter-rails.kicad_sch

ISO_MISO MISC NOTE: Bench, test and procurement notes

File: interface-dac-command.kicad_sch

ISOLATION BARRIER (inside [10]): left of it J3, +3V3_FPGA, GND_FPGA (FPGA side); right of it the board, GND. Spacing rule set with the isolator part.
[7] Analog - Howland Current Pump

[6] Analog - Input Clamp & Buffer

[9] Sense - Feedback to ADC

[12] Interface - ADC Read-back

(orange). A tag such as D1, L2 or M1 next

Revision: 2.1.0-dev Date: Project Name: 28-Oct-2026 Reviewer: Designer:

1 | 2 | 3 | 4 | 5 | 6

AB

C

D

AB

C

D 2

### Sheet: of 13 Size: A4

### Revision: 2.1.0-dev Date: Project Name: 28-Oct-2026 Reviewer: Designer:

revision-history.kicad_sch | WeymenKoo Board Name: Company: | Variant: UBC ELEC 491 - JY063 STIM Rev 1 Channel | JY063 STIM stimulator
Sheet Title: | File Name:
/[2] Doc - Revision History/ Sheet Path: Doc - Revision History Comments: PRELIMINARY: not for fabrication Edited in KiCad: do not regenerate Netlist: expected_netlist_rev1min.csv Not a safety sign-off; dummy loads | Git Hash:

## 26-OCT-2026 - Schematic Review Version: 2.0.0-dev Preliminary

# [2] Doc - Revision History

## - _________________________________

## - _________________________________

## - _________________________________

## - _________________________________

## - _________________________________

## - _________________________________

## - _________________________________

## - _________________________________

## - _________________________________

## - _________________________________

## - _________________________________

## - _________________________________ DD-MMM-YYYY - Next Revision Version: ______

## - Reduced the low-voltage input to one +12 V (J2, 2-pin screw terminal); U32 isolated DC-DC makes +/-12 V on board. - Removed +5 V; LM4040 bias R50 now from

## +9 V (5.1k). - Changed U1 and U3 from OPA171 to

## OPA192: output accuracy passes without the zero calibration. - Added red LEDs: PWR (D8), HV LIVE (D7)

and OUT EN (D6, in the PhotoMOS LED string;

## RLED1 now 750 Ohm). - Fixed the AQY214S symbol (its pins were

hidden). - Resized passives: 0603 by default;

0805/1206/2512 only where voltage, power or precision needs it; one part per value. - Wired the top sheet; ERC clean; page

## numbers now follow the sheet titles. - Formatted after the FoC Motor Controller and

## AMULET: cover index, block frames with captions, this page. PCB text in JetBrains

Mono; 3D model for every part.

## - Cut the board to the analog path for bench bring-up: HV input, clamp, buffer, Howland pump, limiter, PhotoMOS, TVS, read-back. - Removed the trips, latch, power-on reset, rail

## monitors, enable logic and parking switch (kept in simulation for Rev 2). - Changed rail shunts RSP/RSN to 10 Ohm for

current measurement. - Changed FPGA connector J3 to DAC_CMD,

ENABLE, I_RETURN_ADC, V_ELEC_ADC,

## VMID_REF and grounds; no power. - Added the read-back stage (OPA4192) for the

FPGA ADC. - Added bench bias jumpers JP1/JP2,

## current-loop header JP3, 29 test loops and M3

mounting holes.

## 23-OCT-2026 - Initial Capture Version: 1.0.0 Draft

## 25-OCT-2026 - Minimal Rev 1 Version: 2.0.0-dev Preliminary

## - Captured the full Rev 1 channel from the

simulated netlist and the P4 BoM: 14 sheets,

## 156 parts. - Included the full safety chain: over-current

and mismatch trips, fault latch, power-on reset,

## rail monitors, parking switch. - Netlist matched expected_netlist.csv with 0

differences; ERC clean.

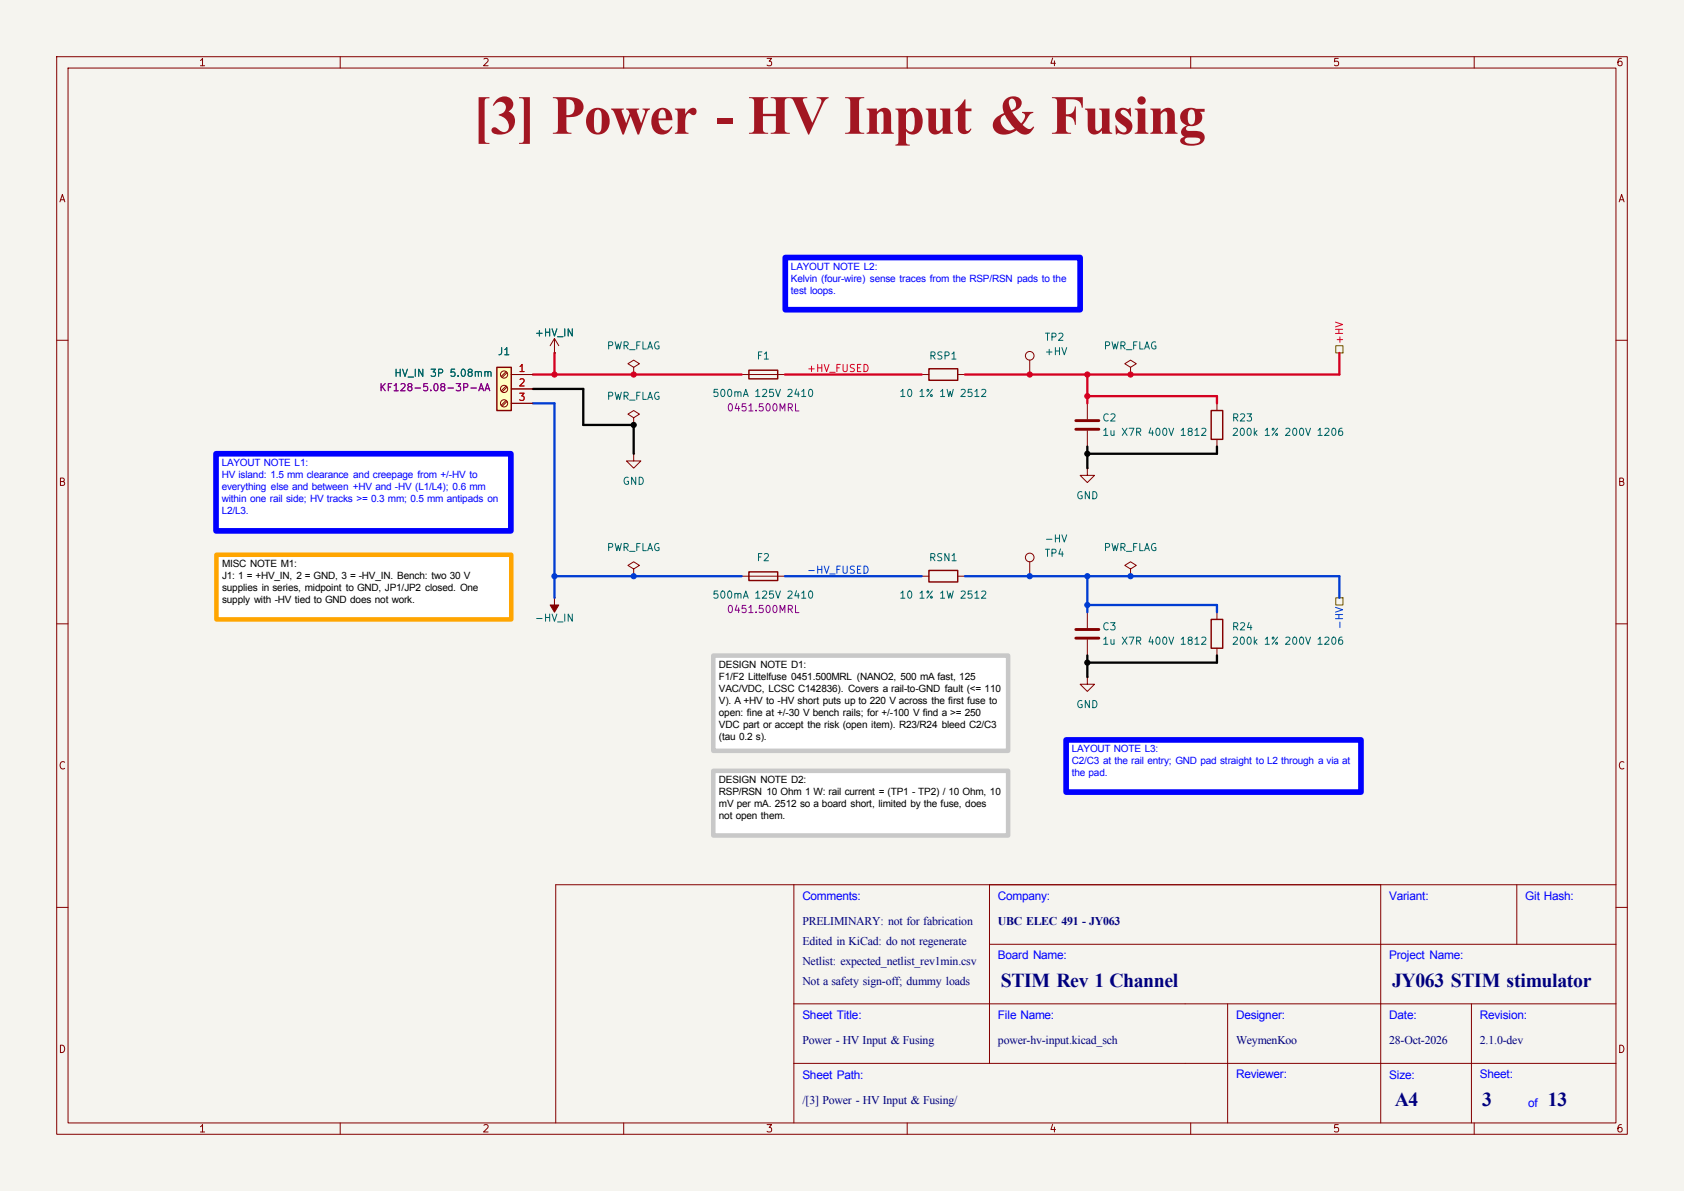
[picture p99: page 3]

[3] Power - HV Input & Fusing

LAYOUT NOTE L2: Kelvin (four-wire) sense traces from the RSP/RSN pads to the

the pad. LAYOUT NOTE L1: HV island: 1.5 mm clearance and creepage from +/-HV to

everything else and between +HV and -HV (L1/L4); 0.6 mm
within one rail side; HV tracks >= 0.3 mm; 0.5 mm antipads on
L2/L3. MISC NOTE M1: J1: 1 = +HV_IN, 2 = GND, 3 = -HV_IN. Bench: two 30 V

supplies in series, midpoint to GND, JP1/JP2 closed. One

DESIGN NOTE D2: RSP/RSN 10 Ohm 1 W: rail current = (TP1 - TP2) / 10 Ohm, 10 mV per mA. 2512 so a board short, limited by the fuse, does not open them. DESIGN NOTE D1: F1/F2 Littelfuse 0451.500MRL (NANO2, 500 mA fast, 125 VAC/VDC, LCSC C142836). Covers a rail-to-GND fault (<= 110 V). A +HV to -HV short puts up to 220 V across the first fuse to

open: fine at +/-30 V bench rails; for +/-100 V find a >= 250 VDC part or accept the risk (open item). R23/R24 bleed C2/C3

Revision: 2.1.0-dev Date: Project Name: 28-Oct-2026 Reviewer: Designer:

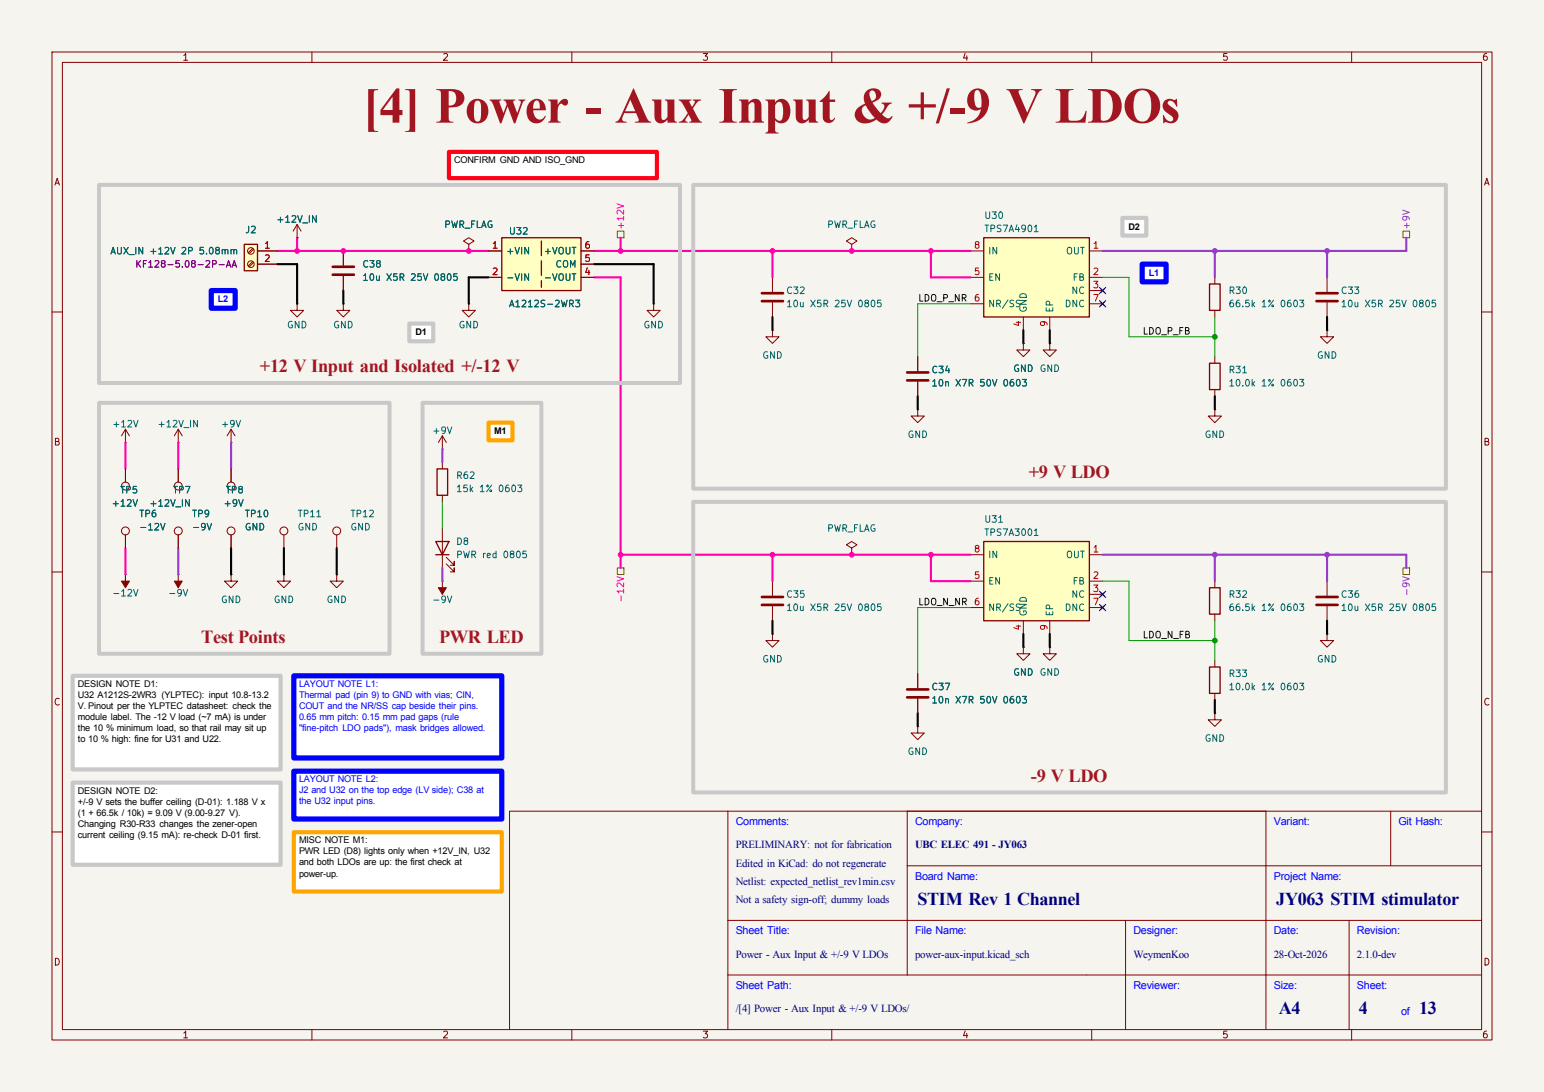
[picture p100: page 4]

LDO_P_NR [4] Power - Aux Input & +/-9 V LDOs

M1 L2 DESIGN NOTE D2: +/-9 V sets the buffer ceiling (D-01): 1.188 V x

"fine-pitch LDO pads"), mask bridges allowed. Test Points

the U32 input pins. DESIGN NOTE D1: U32 A1212S-2WR3 (YLPTEC): input 10.8-13.2 V. Pinout per the YLPTEC datasheet: check the module label. The -12 V load (~7 mA) is under

the 10 % minimum load, so that rail may sit up

and both LDOs are up: the first check at power-up. LAYOUT NOTE L2: J2 and U32 on the top edge (LV side); C38 at

Changing R30-R33 changes the zener-open

Revision: 2.1.0-dev Date: Project Name: 28-Oct-2026 Reviewer: Designer:

AB

C

D

AB

C

D 5

### Sheet: of 13 Size: A4

### Revision: 2.1.0-dev Date: Project Name: 28-Oct-2026 Reviewer: Designer:

interface-fpga.kicad_sch | WeymenKoo Board Name: Company: | Variant: UBC ELEC 491 - JY063 STIM Rev 1 Channel | JY063 STIM stimulator
Sheet Title: | File Name:

### /[5] Interface - FPGA/ Sheet Path: Interface - FPGA

Comments: PRELIMINARY: not for fabrication Edited in KiCad: do not regenerate Netlist: expected_netlist_rev1min.csv Not a safety sign-off; dummy loads | Git Hash: PWR_FLAG
1 | 2
3 | 4
5 | 6
7 | 8
9 | 10
11 | 12
13 | 14
15 | 16

J3

FPGA_IF 2x8 2.54mm

A2541WV-2x8P [ASSUME] PWR_FLAG

ENABLE +3V3_FPGA SPI_CS_ADC2 | GND_FPGA SPI_SCLK

SPI_MOSI SPI_MISO

SPI_CS_DAC
SPI_CS_ADC | MISC NOTE M1: FPGA: hold the DAC at 0 for 3 ms after ENABLE (D-08; the AQY214S closes in 0.5 ms, so this can shorten); clear the DAC

when ENABLE drops; one SPI bus, three chip selects (DAC [11], two ADCs [12]); subtract the once-measured VMID_REF

(TP29) from both read-back channels in software. LAYOUT NOTE L1: J3 on the left (LV) edge, on the FPGA side of the isolation

barrier with side 1 of [10]. Every signal has a GND_FPGA neighbour on the ribbon. GND_FPGA is its own pour under J3 and the isolator side 1, not board GND. [5] Interface - FPGA

DESIGN NOTE D1: J3 2x8 IDC: 1 +3V3_FPGA, 3 SPI_SCLK, 5 SPI_MOSI, 7 SPI_MISO, 9 SPI_CS_DAC, 11 SPI_CS_ADC, 13 ENABLE

(3.3 V; low or open = switches open), 15 SPI_CS_ADC2 (3.3 V, active low: chip select of the second ADC U42 on [12] through U44 on [10]; no spare pin left, see [10] D3); even pins

GND_FPGA. All nets here are FPGA-side; they cross to the board only through [10]. [ASSUME] +3V3_FPGA from the FPGA powers isolator side 1 (ICD_J3 said no power on J3: decide and update the ICD). J5 on [10] is the board-side twin of

this header for the isolator bypass. Analog DAC_CMD / read-back pins are gone: [11] and [12] do that. J3

FPGA_IF 2x8 2.54mm

A2541WV-2x8P [ASSUME] 1 | 2
3 | 4
5 | 6
7 | 8
9 | 10
11 | 12
13 | 14
15 | 16 PWR_FLAG

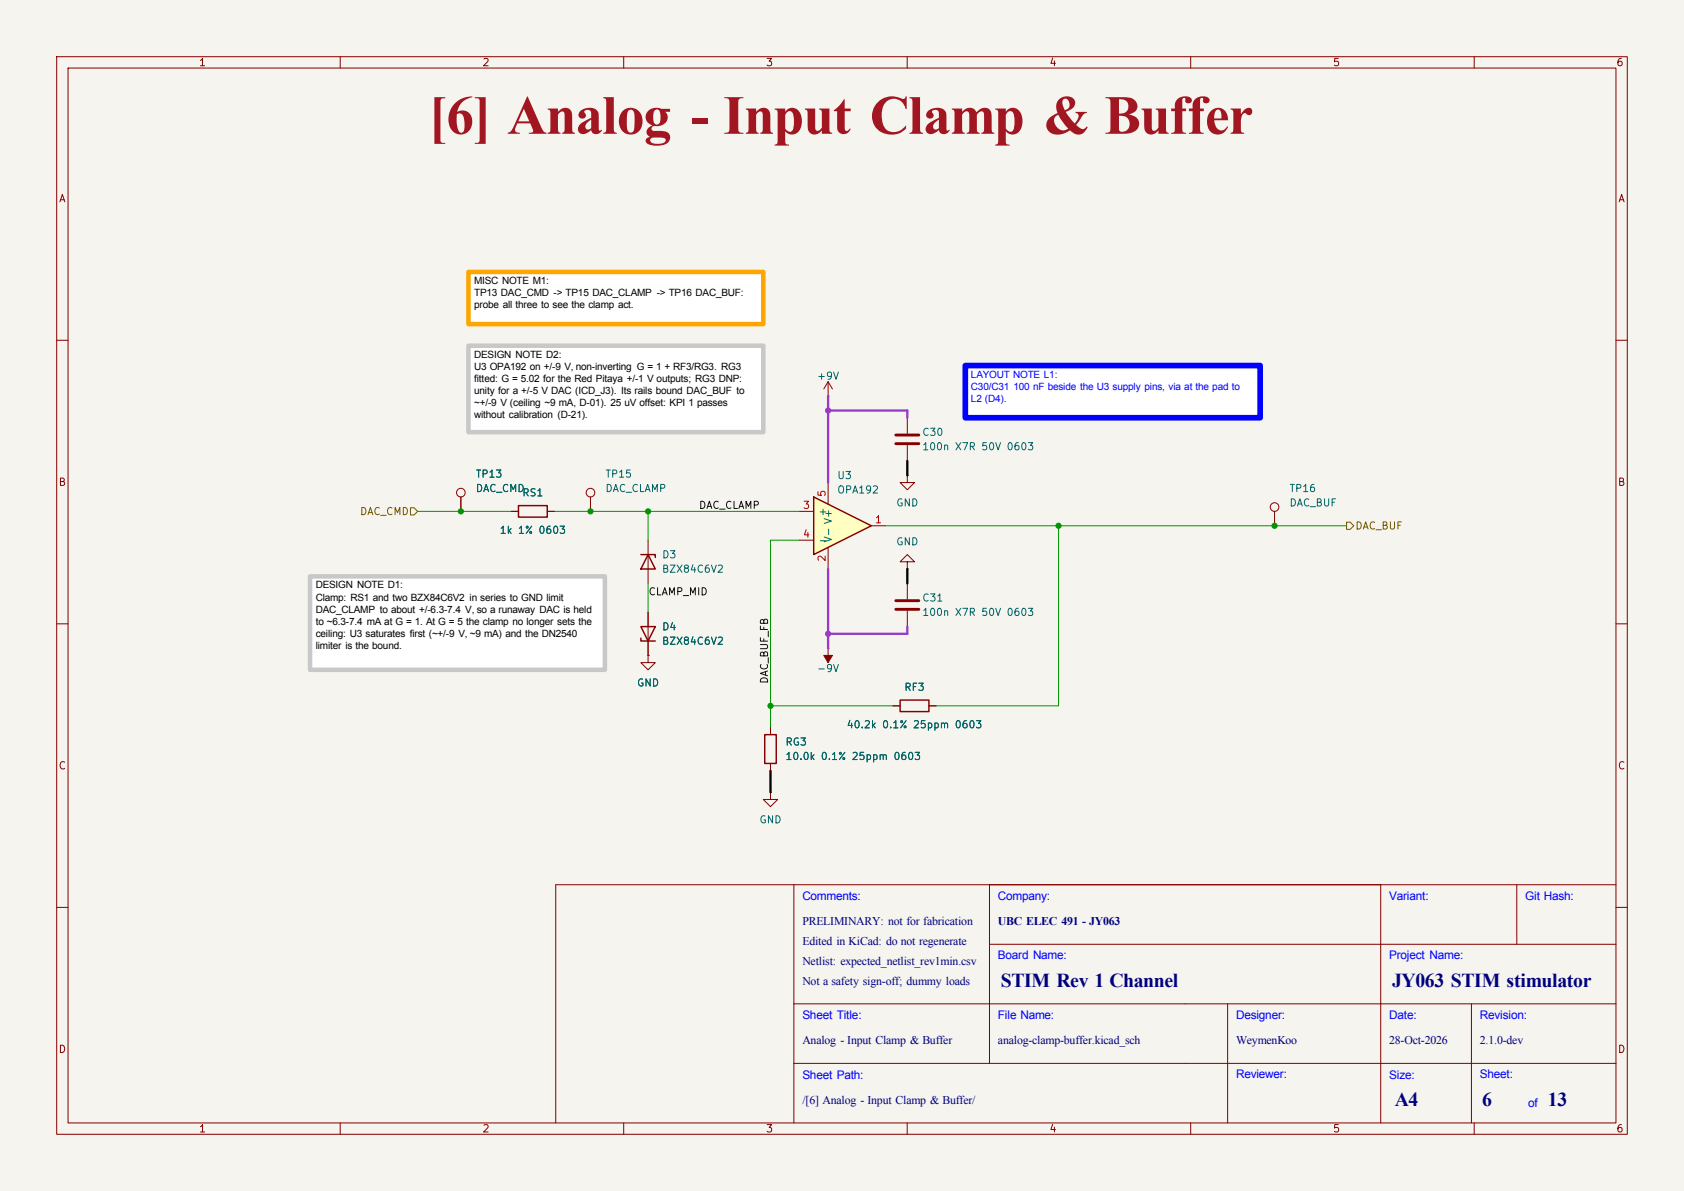
[picture p101: page 6]

probe all three to see the clamp act. [6] Analog - Input Clamp & Buffer

fitted: G = 5.02 for the Red Pitaya +/-1 V outputs; RG3 DNP: unity for a +/-5 V DAC (ICD_J3). Its rails bound DAC_BUF to ~+/-9 V (ceiling ~9 mA, D-01). 25 uV offset: KPI 1 passes without calibration (D-21). MISC NOTE M1: TP13 DAC_CMD -> TP15 DAC_CLAMP -> TP16 DAC_BUF:

DESIGN NOTE D2: U3 OPA192 on +/-9 V, non-inverting G = 1 + RF3/RG3. RG3

LAYOUT NOTE L1: C30/C31 100 nF beside the U3 supply pins, via at the pad to

L2 (D4). DESIGN NOTE D1: Clamp: RS1 and two BZX84C6V2 in series to GND limit DAC_CLAMP to about +/-6.3-7.4 V, so a runaway DAC is held

to ~6.3-7.4 mA at G = 1. At G = 5 the clamp no longer sets the
ceiling: U3 saturates first (~+/-9 V, ~9 mA) and the DN2540

Revision: 2.1.0-dev Date: Project Name: 28-Oct-2026 Reviewer: Designer:

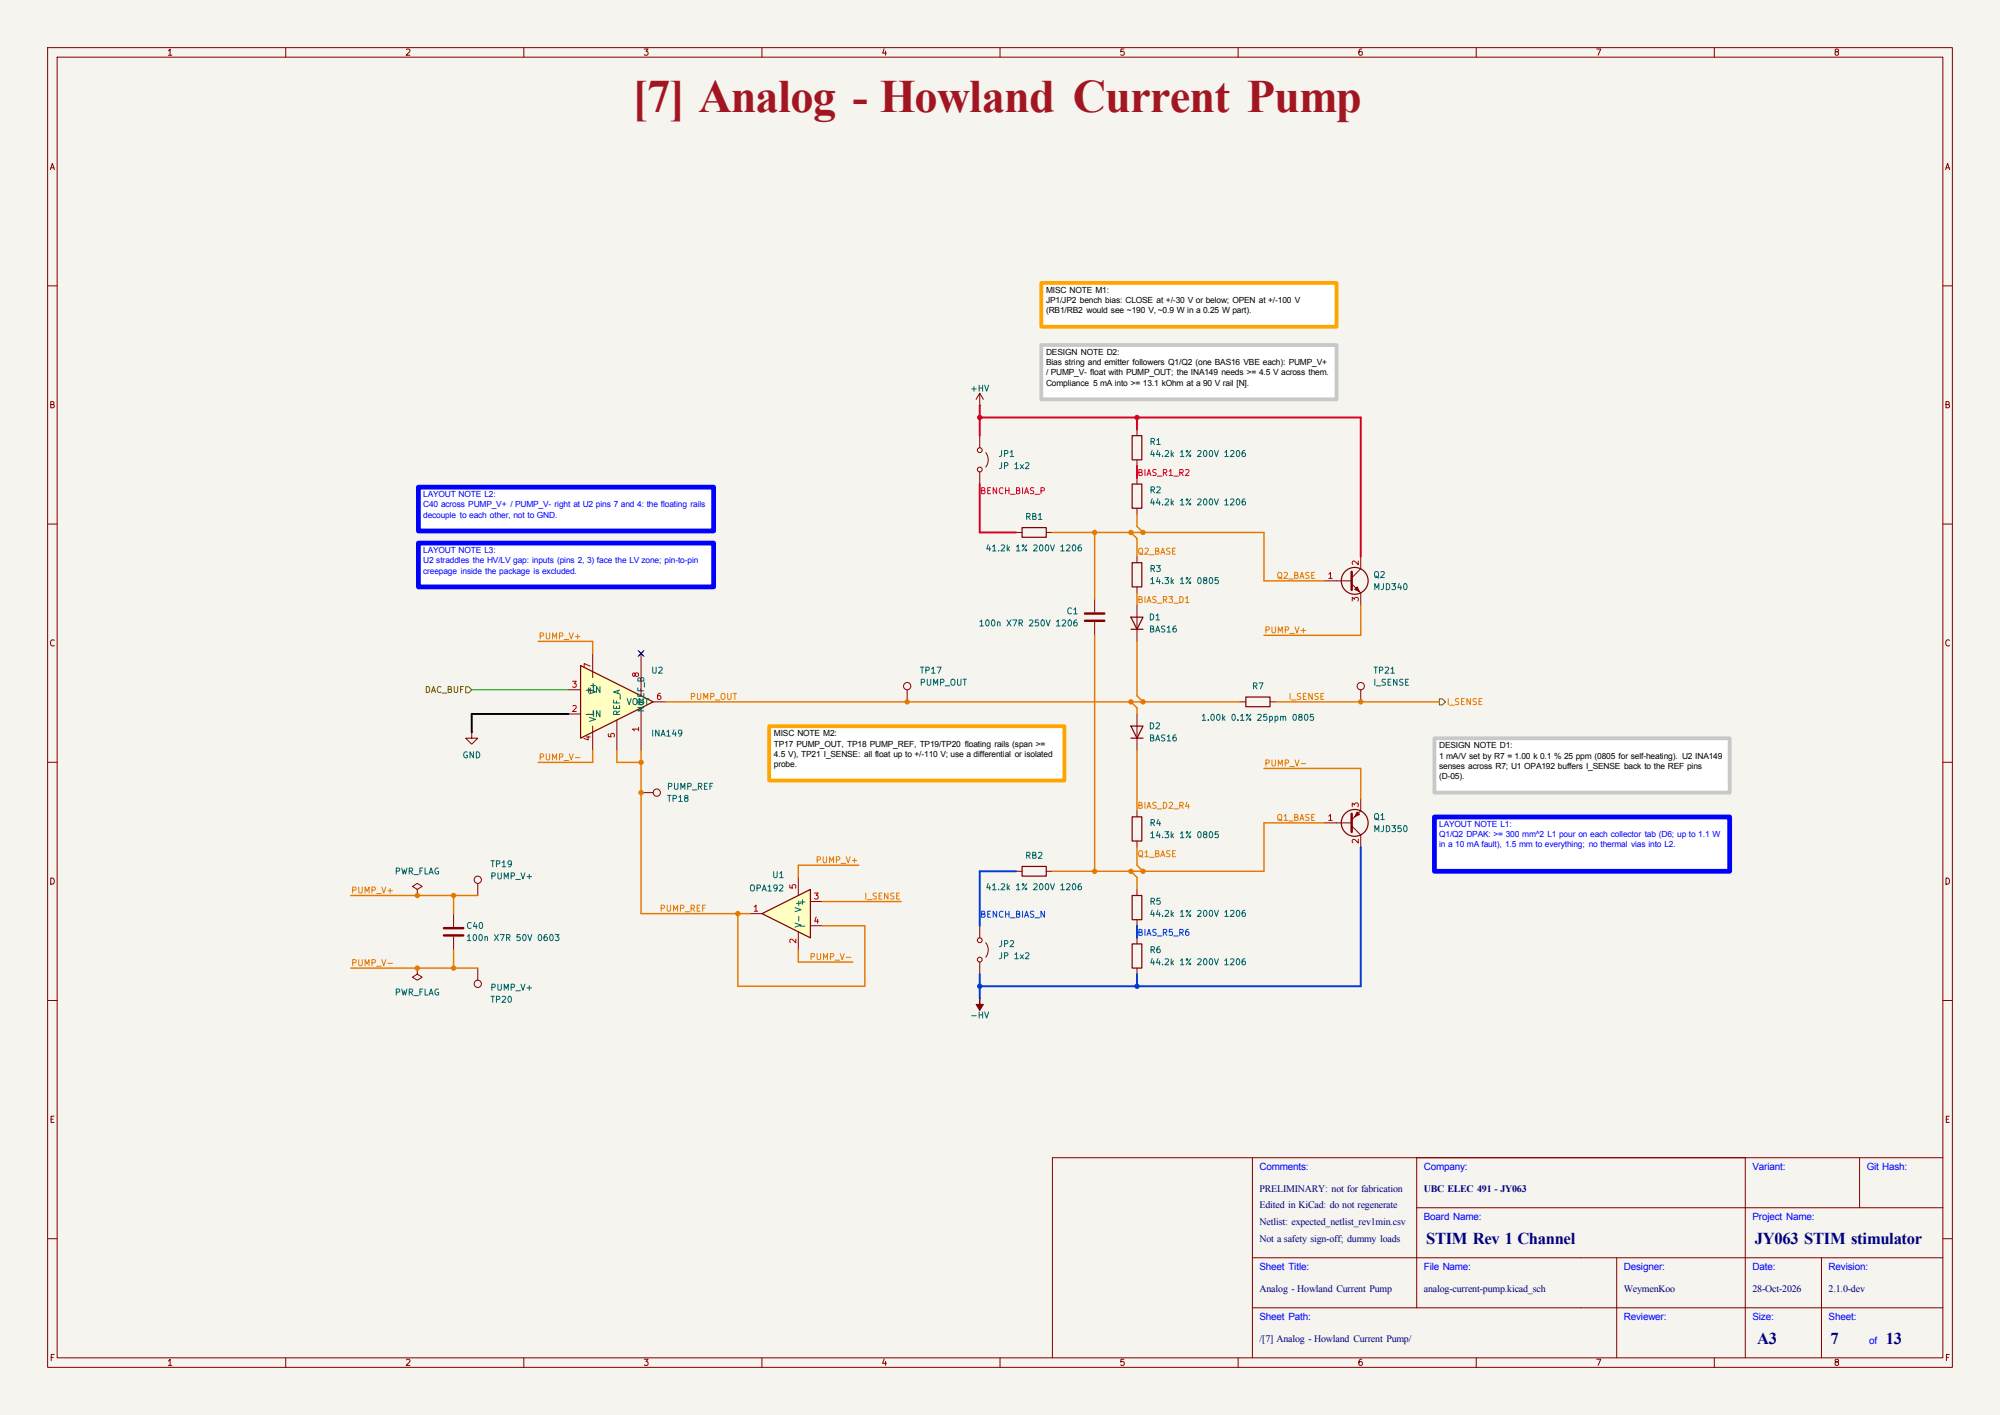
[picture p102: page 7]

[7] Analog - Howland Current Pump

MISC NOTE M1: JP1/JP2 bench bias: CLOSE at +/-30 V or below; OPEN at +/-100 V

(RB1/RB2 would see ~190 V, ~0.9 W in a 0.25 W part). DESIGN NOTE D2: Bias string and emitter followers Q1/Q2 (one BAS16 VBE each): PUMP_V+

/ PUMP_V- float with PUMP_OUT; the INA149 needs >= 4.5 V across them. Compliance 5 mA into >= 13.1 kOhm at a 90 V rail [N]. MISC NOTE M2: TP17 PUMP_OUT, TP18 PUMP_REF, TP19/TP20 floating rails (span >=

in a 10 mA fault), 1.5 mm to everything; no thermal vias into L2. LAYOUT NOTE L3: U2 straddles the HV/LV gap: inputs (pins 2, 3) face the LV zone; pin-to-pin

creepage inside the package is excluded.

4.5 V), TP21 I_SENSE: all float up to +/-110 V; use a differential or isolated

senses across R7; U1 OPA192 buffers I_SENSE back to the REF pins

Revision: 2.1.0-dev Date: Project Name: 28-Oct-2026 Reviewer: Designer:

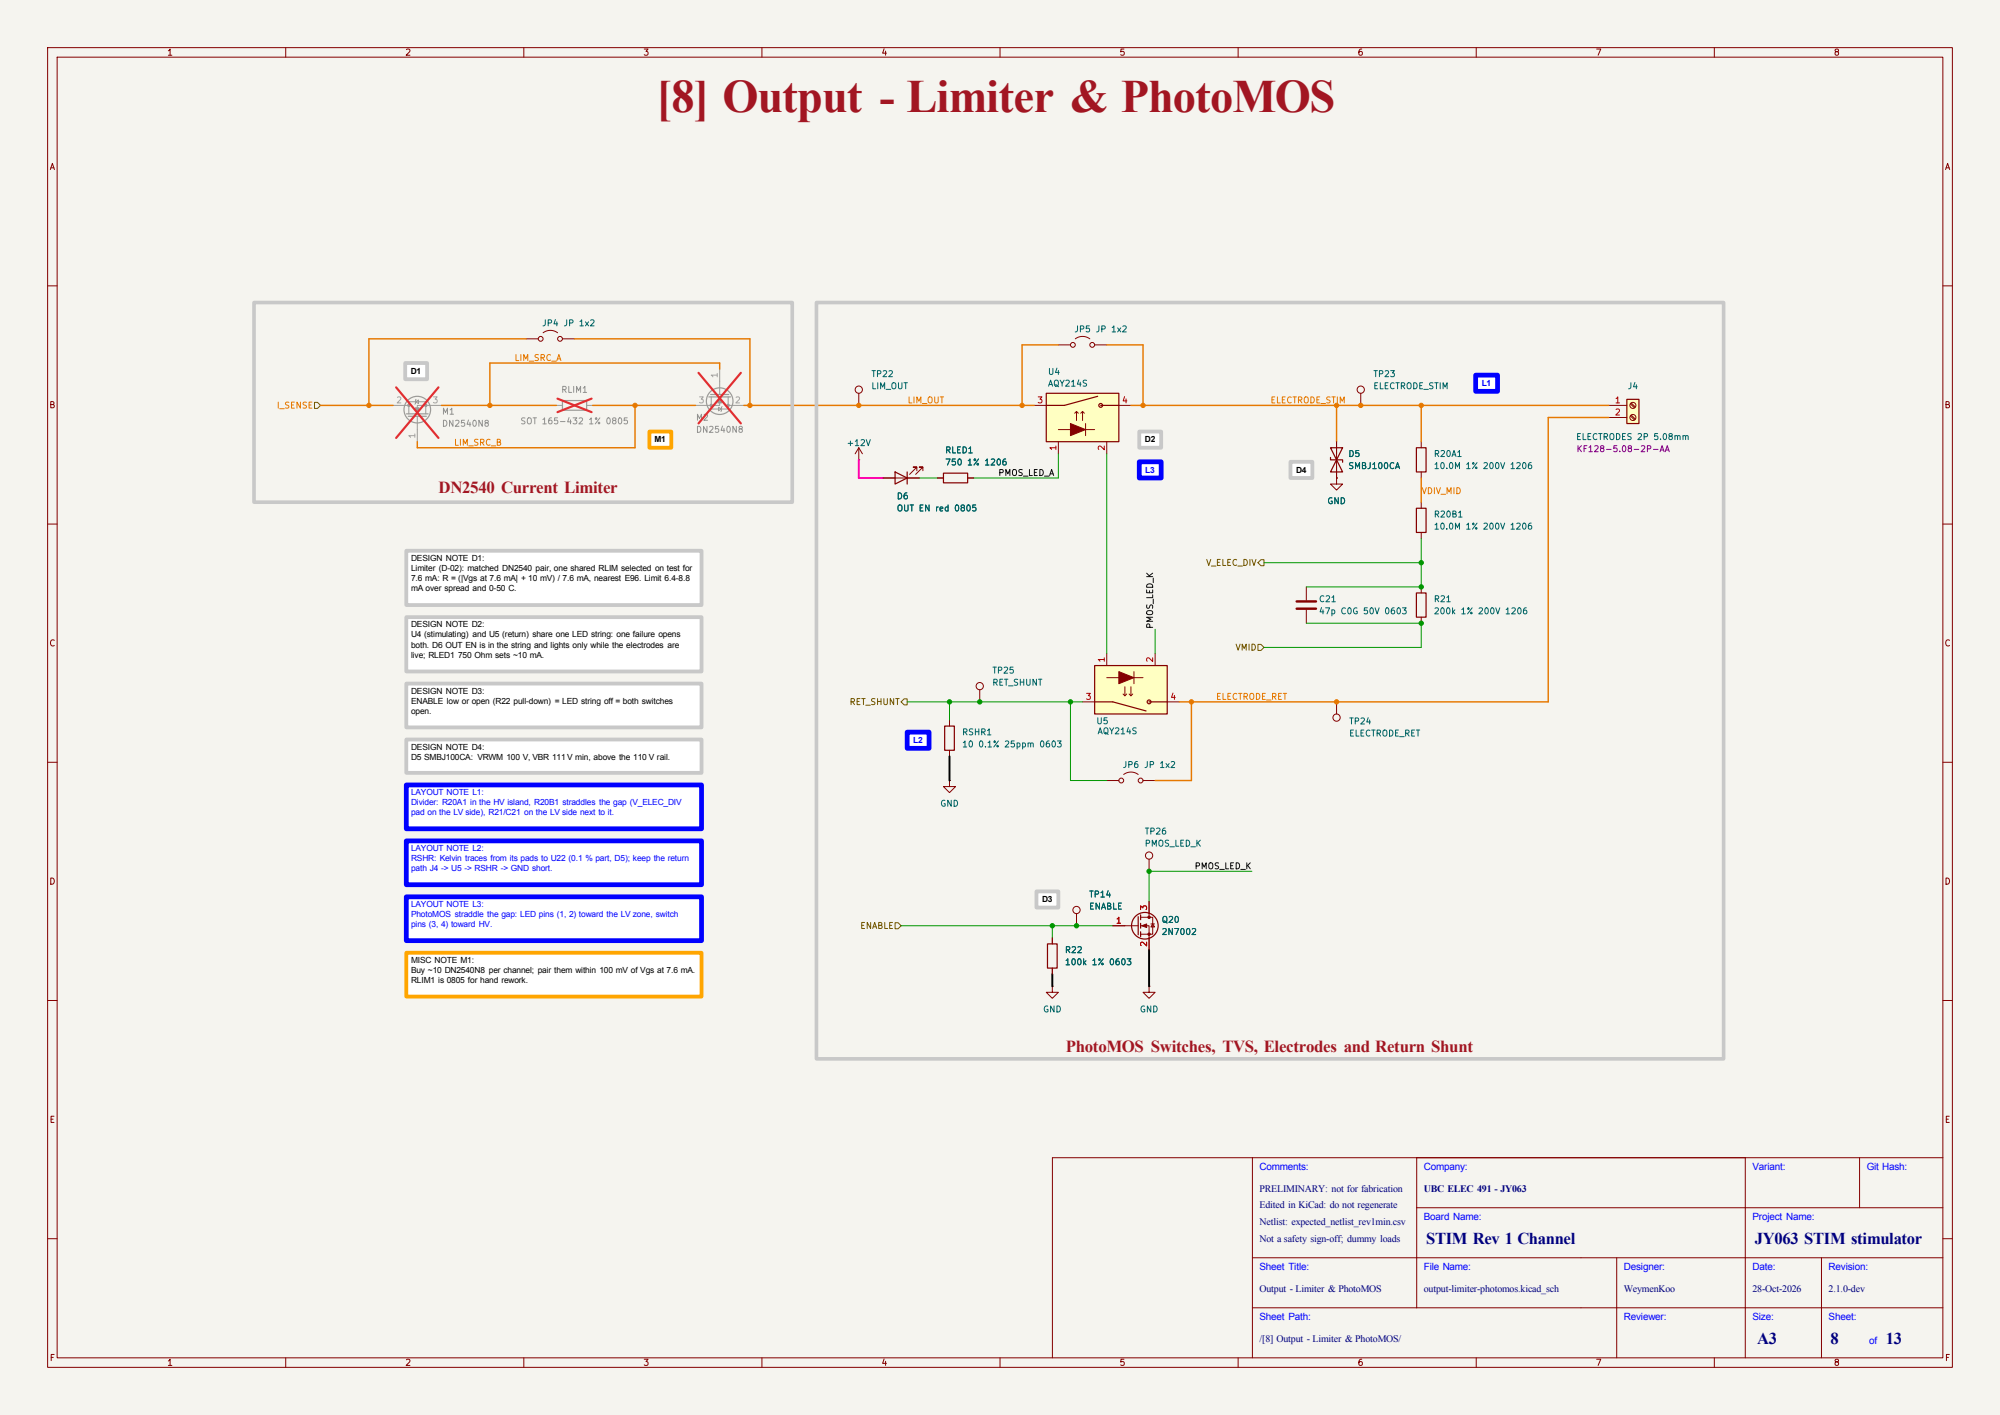
[picture p103: page 8]

live; RLED1 750 Ohm sets ~10 mA. DESIGN NOTE D3: ENABLE low or open (R22 pull-down) = LED string off = both switches open. LAYOUT NOTE L1: Divider: R20A1 in the HV island, R20B1 straddles the gap (V_ELEC_DIV

pad on the LV side), R21/C21 on the LV side next to it. LAYOUT NOTE L2: RSHR: Kelvin traces from its pads to U22 (0.1 % part, D5); keep the return

path J4 -> U5 -> RSHR -> GND short. LAYOUT NOTE L3: PhotoMOS straddle the gap: LED pins (1, 2) toward the LV zone, switch

PhotoMOS Switches, TVS, Electrodes and Return Shunt

Revision: 2.1.0-dev Date: Project Name: 28-Oct-2026 Reviewer: Designer:

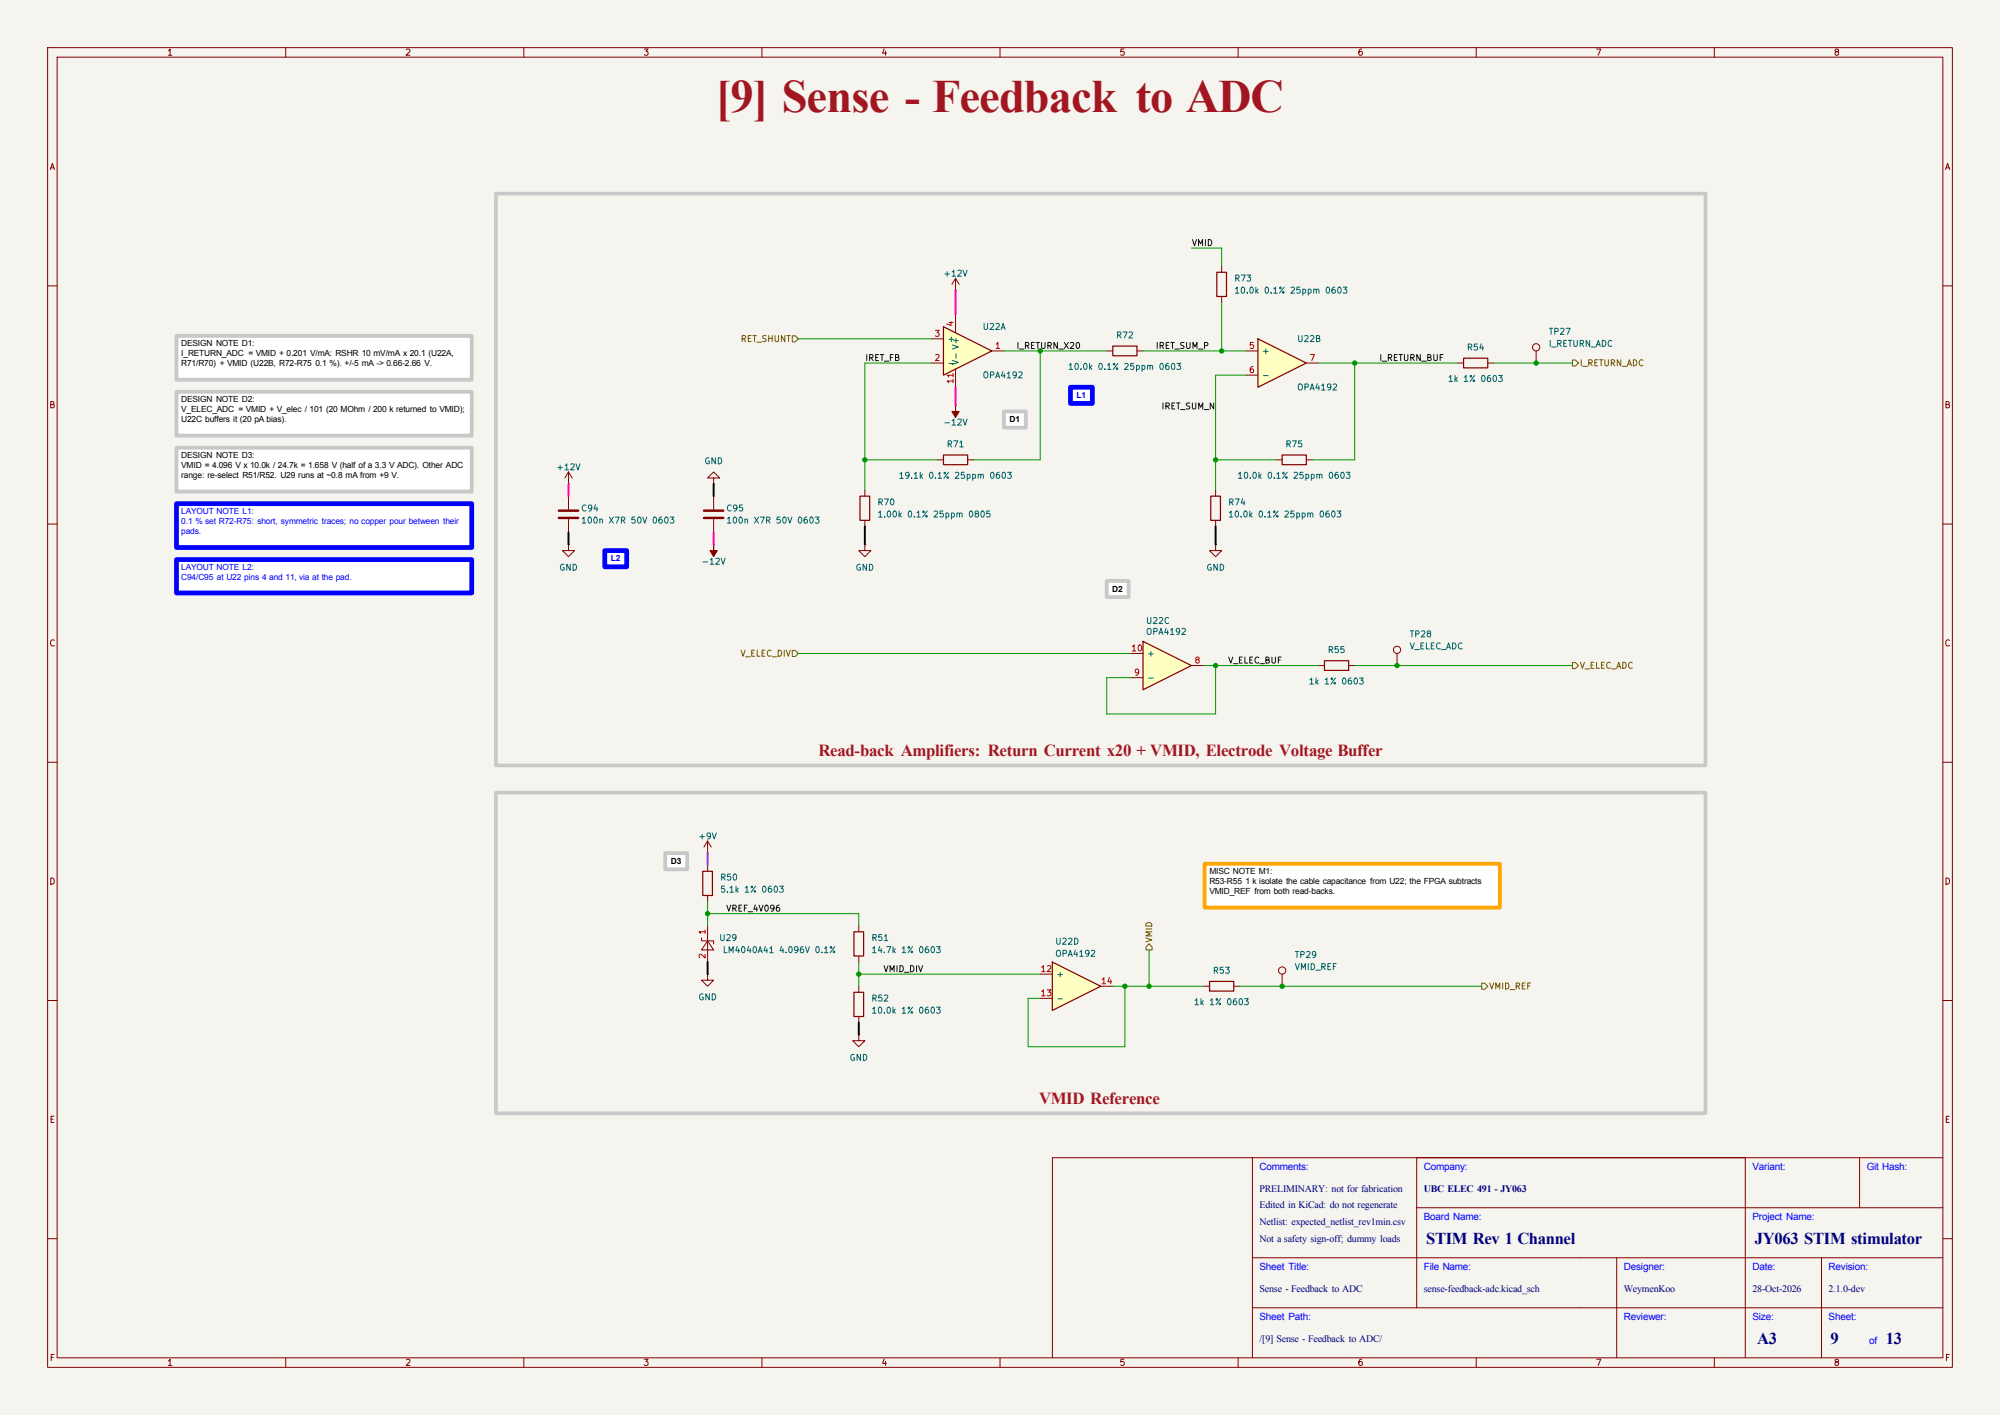
[picture p104: page 9]

range: re-select R51/R52. U29 runs at ~0.8 mA from +9 V. DESIGN NOTE D1:
I_RETURN_ADC = VMID + 0.201 V/mA: RSHR 10 mV/mA x 20.1 (U22A,
R71/R70) + VMID (U22B, R72-R75 0.1 %). +/-5 mA -> 0.66-2.66 V.

LAYOUT NOTE L2: C94/C95 at U22 pins 4 and 11, via at the pad. DESIGN NOTE D2: V_ELEC_ADC = VMID + V_elec / 101 (20 MOhm / 200 k returned to VMID); U22C buffers it (20 pA bias). DESIGN NOTE D3: VMID = 4.096 V x 10.0k / 24.7k = 1.658 V (half of a 3.3 V ADC). Other ADC

Read-back Amplifiers: Return Current x20 + VMID, Electrode Voltage Buffer

Revision: 2.1.0-dev Date: Project Name: 28-Oct-2026 Reviewer: Designer:

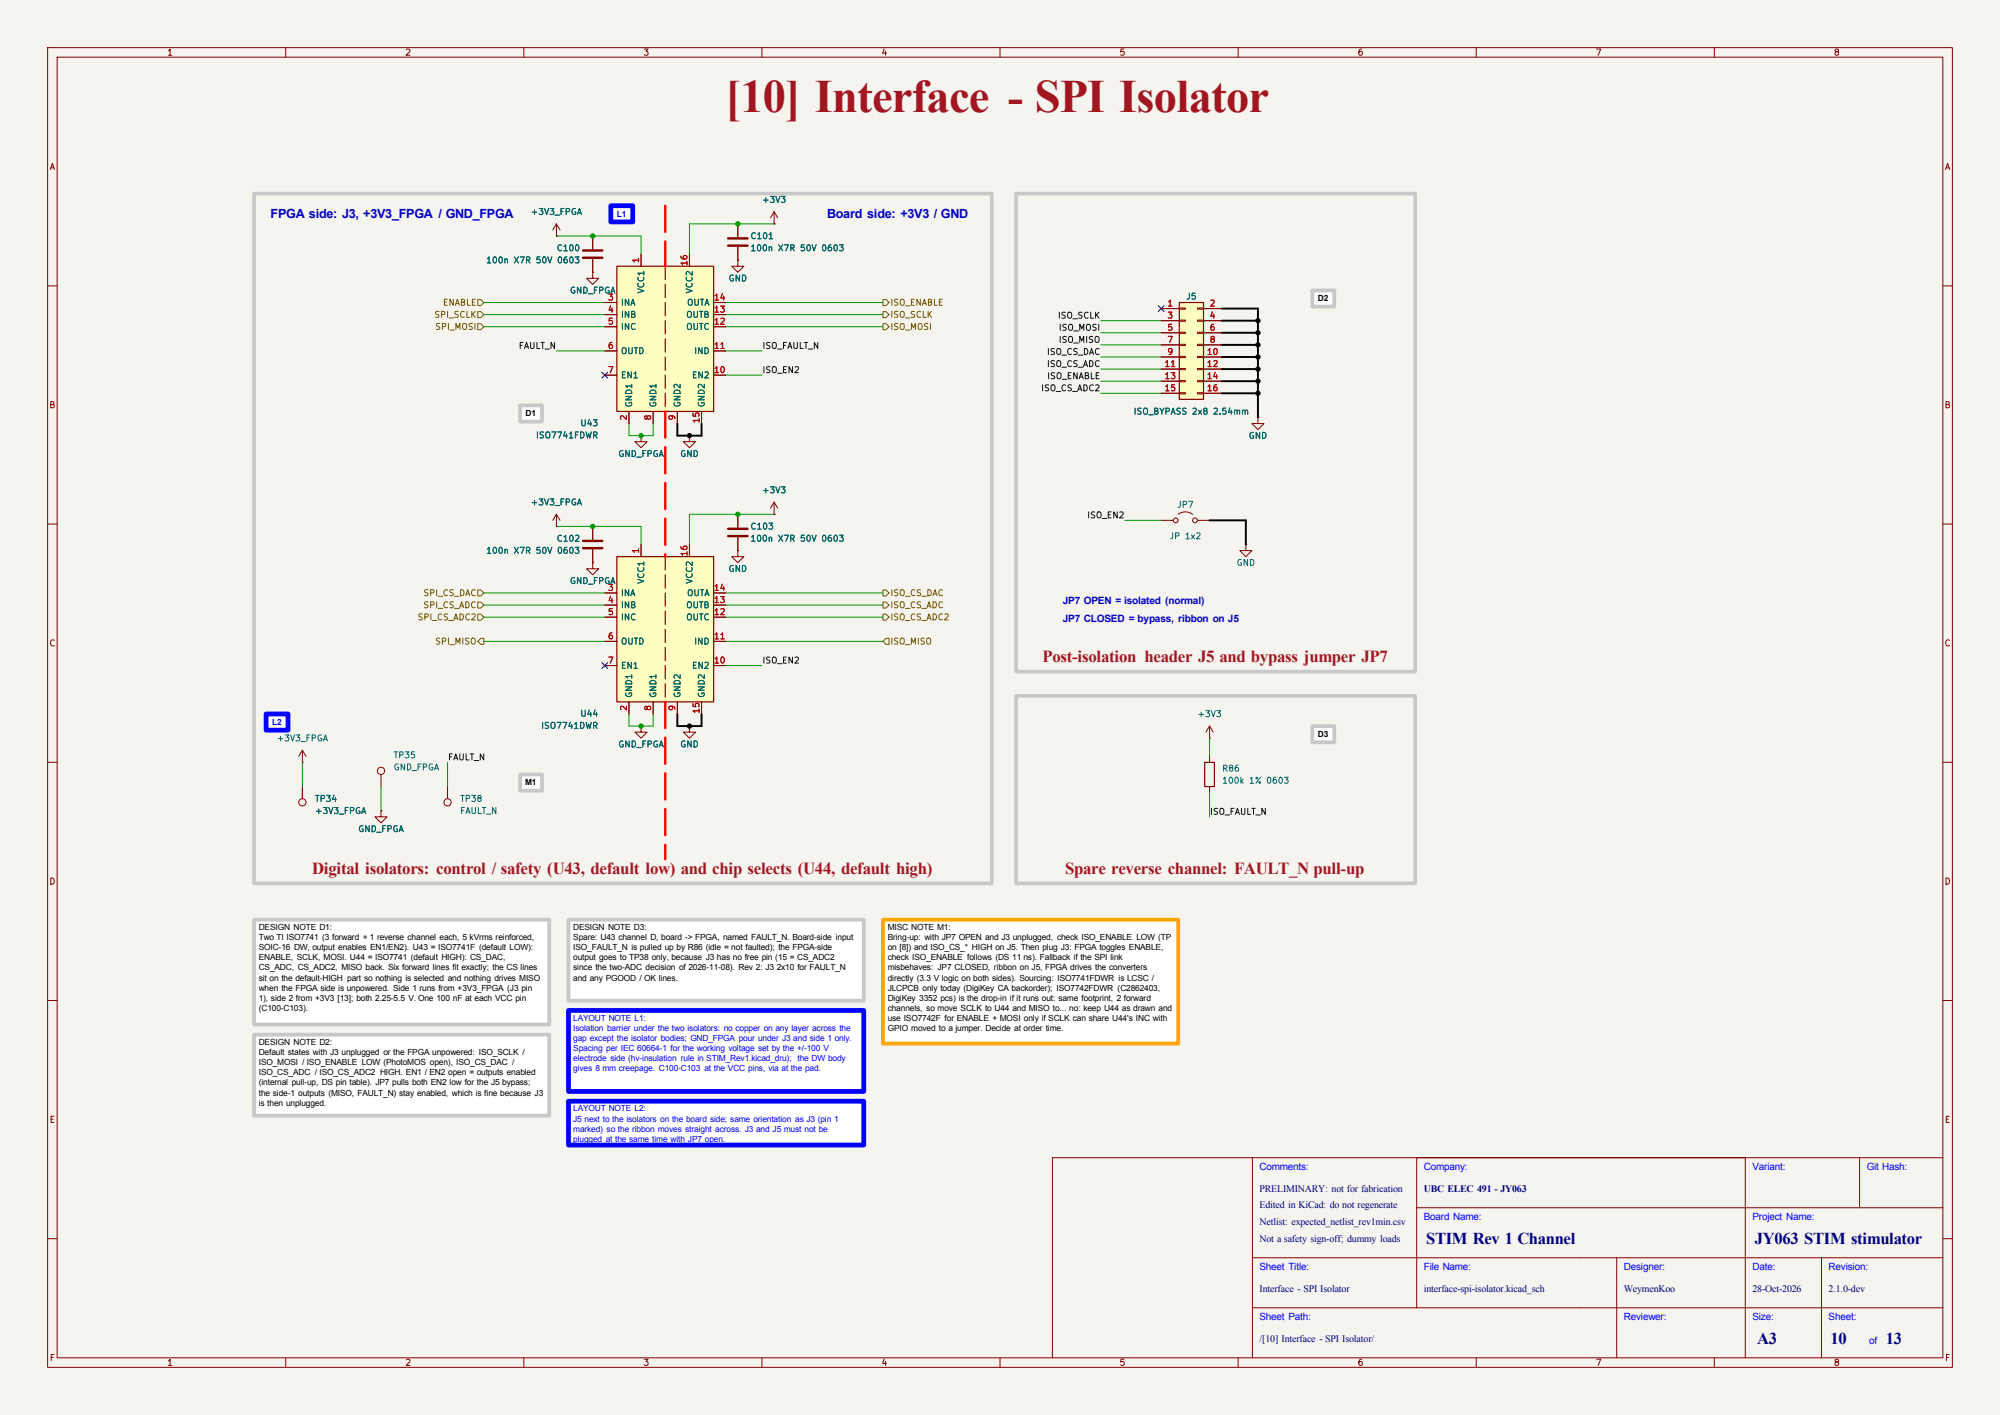
[picture p105: page 10]

JP7 OPEN = isolated (normal)
JP7 CLOSED = bypass, ribbon on J5

GND_FPGA
Digital isolators: control / safety (U43, default low) and chip selects (U44, default high)

gives 8 mm creepage. C100-C103 at the VCC pins, via at the pad. DESIGN NOTE D1: Two TI ISO7741 (3 forward + 1 reverse channel each, 5 kVrms reinforced, SOIC-16 DW, output enables EN1/EN2). U43 = ISO7741F (default LOW): ENABLE, SCLK, MOSI. U44 = ISO7741 (default HIGH): CS_DAC,

DESIGN NOTE D3: Spare: U43 channel D, board -> FPGA, named FAULT_N. Board-side input

MISC NOTE M1: Bring-up: with JP7 OPEN and J3 unplugged, check ISO_ENABLE LOW (TP

ISO_FAULT_N is pulled up by R86 (idle = not faulted); the FPGA-side
output goes to TP38 only, because J3 has no free pin (15 = CS_ADC2
since the two-ADC decision of 2026-11-08). Rev 2: J3 2x10 for FAULT_N
and any PGOOD / OK lines. LAYOUT NOTE L2: J5 next to the isolators on the board side; same orientation as J3 (pin 1 marked) so the ribbon moves straight across. J3 and J5 must not be

on [8]) and ISO_CS_* HIGH on J5. Then plug J3: FPGA toggles ENABLE, check ISO_ENABLE follows (DS 11 ns). Fallback if the SPI link misbehaves: JP7 CLOSED, ribbon on J5, FPGA drives the converters directly (3.3 V logic on both sides). Sourcing: ISO7741FDWR is LCSC / JLCPCB only today (DigiKey CA backorder); ISO7742FDWR (C2862403,

CS_ADC, CS_ADC2, MISO back. Six forward lines fit exactly; the CS lines
sit on the default-HIGH part so nothing is selected and nothing drives MISO
when the FPGA side is unpowered. Side 1 runs from +3V3_FPGA (J3 pin
1), side 2 from +3V3 [13]; both 2.25-5.5 V. One 100 nF at each VCC pin
(C100-C103). DESIGN NOTE D2: Default states with J3 unplugged or the FPGA unpowered: ISO_SCLK /

DigiKey 3352 pcs) is the drop-in if it runs out: same footprint, 2 forward
channels, so move SCLK to U44 and MISO to... no: keep U44 as drawn and

plugged at the same time with JP7 open. LAYOUT NOTE L1:
Isolation barrier under the two isolators: no copper on any layer across the
gap except the isolator bodies; GND_FPGA pour under J3 and side 1 only.
Spacing per IEC 60664-1 for the working voltage set by the +/-100 V
electrode side (hv-insulation rule in STIM_Rev1.kicad_dru); the DW body

ISO_MOSI / ISO_ENABLE LOW (PhotoMOS open), ISO_CS_DAC /
ISO_CS_ADC / ISO_CS_ADC2 HIGH. EN1 / EN2 open = outputs enabled
(internal pull-up, DS pin table). JP7 pulls both EN2 low for the J5 bypass;
the side-1 outputs (MISO, FAULT_N) stay enabled, which is fine because J3
is then unplugged.

Revision: 2.1.0-dev Date: Project Name: 28-Oct-2026 Reviewer: Designer:

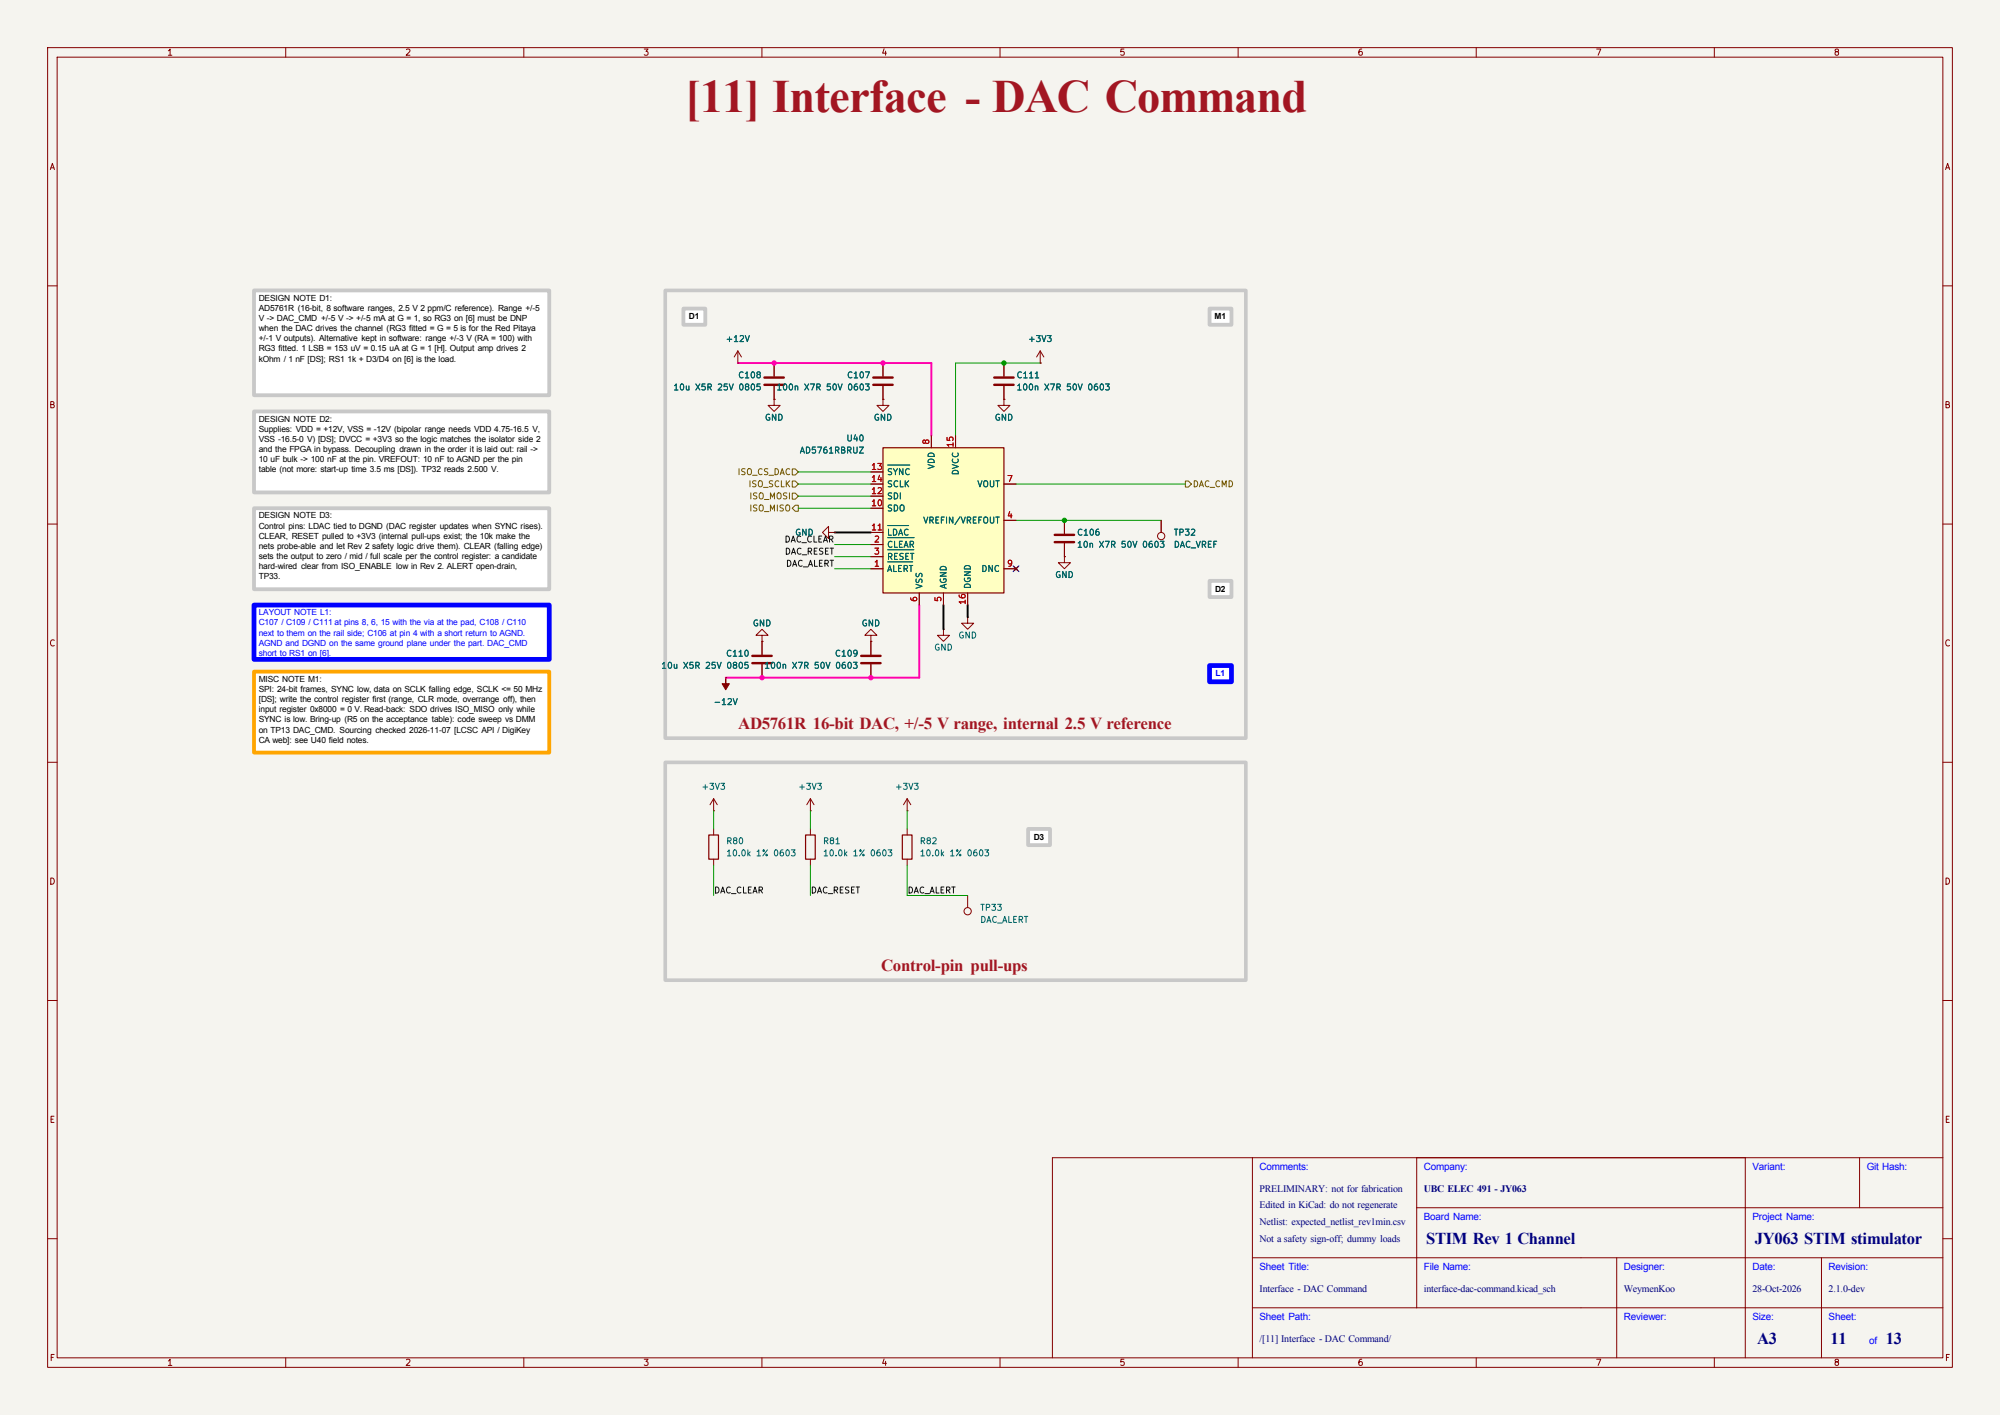
[picture p106: page 11]

DESIGN NOTE D1: AD5761R (16-bit, 8 software ranges, 2.5 V 2 ppm/C reference). Range +/-5 V -> DAC_CMD +/-5 V -> +/-5 mA at G = 1, so RG3 on [6] must be DNP when the DAC drives the channel (RG3 fitted = G = 5 is for the Red Pitaya +/-1 V outputs). Alternative kept in software: range +/-3 V (RA = 100) with RG3 fitted. 1 LSB = 153 uV = 0.15 uA at G = 1 [H]. Output amp drives 2

M1 AD5761R 16-bit DAC, +/-5 V range, internal 2.5 V reference
100n X7R 50V 0603 GND

kOhm / 1 nF [DS]; RS1 1k + D3/D4 on [6] is the load. MISC NOTE M1: SPI: 24-bit frames, SYNC low, data on SCLK falling edge, SCLK <= 50 MHz

on TP13 DAC_CMD. Sourcing checked 2026-11-07 [LCSC API / DigiKey CA web]: see U40 field notes. DESIGN NOTE D2: Supplies: VDD = +12V, VSS = -12V (bipolar range needs VDD 4.75-16.5 V, VSS -16.5-0 V) [DS]; DVCC = +3V3 so the logic matches the isolator side 2

and the FPGA in bypass. Decoupling drawn in the order it is laid out: rail ->
10 uF bulk -> 100 nF at the pin. VREFOUT: 10 nF to AGND per the pin
table (not more: start-up time 3.5 ms [DS]). TP32 reads 2.500 V. DESIGN NOTE D3: Control pins: LDAC tied to DGND (DAC register updates when SYNC rises). CLEAR, RESET pulled to +3V3 (internal pull-ups exist; the 10k make the

nets probe-able and let Rev 2 safety logic drive them). CLEAR (falling edge) sets the output to zero / mid / full scale per the control register: a candidate

hard-wired clear from ISO_ENABLE low in Rev 2. ALERT open-drain, TP33. LAYOUT NOTE L1: C107 / C109 / C111 at pins 8, 6, 15 with the via at the pad, C108 / C110

next to them on the rail side; C106 at pin 4 with a short return to AGND. AGND and DGND on the same ground plane under the part. DAC_CMD

[DS]; write the control register first (range, CLR mode, overrange off), then
input register 0x8000 = 0 V. Read-back: SDO drives ISO_MISO only while SYNC is low. Bring-up (R5 on the acceptance table): code sweep vs DMM

Revision: 2.1.0-dev Date: Project Name: 28-Oct-2026 Reviewer: Designer:

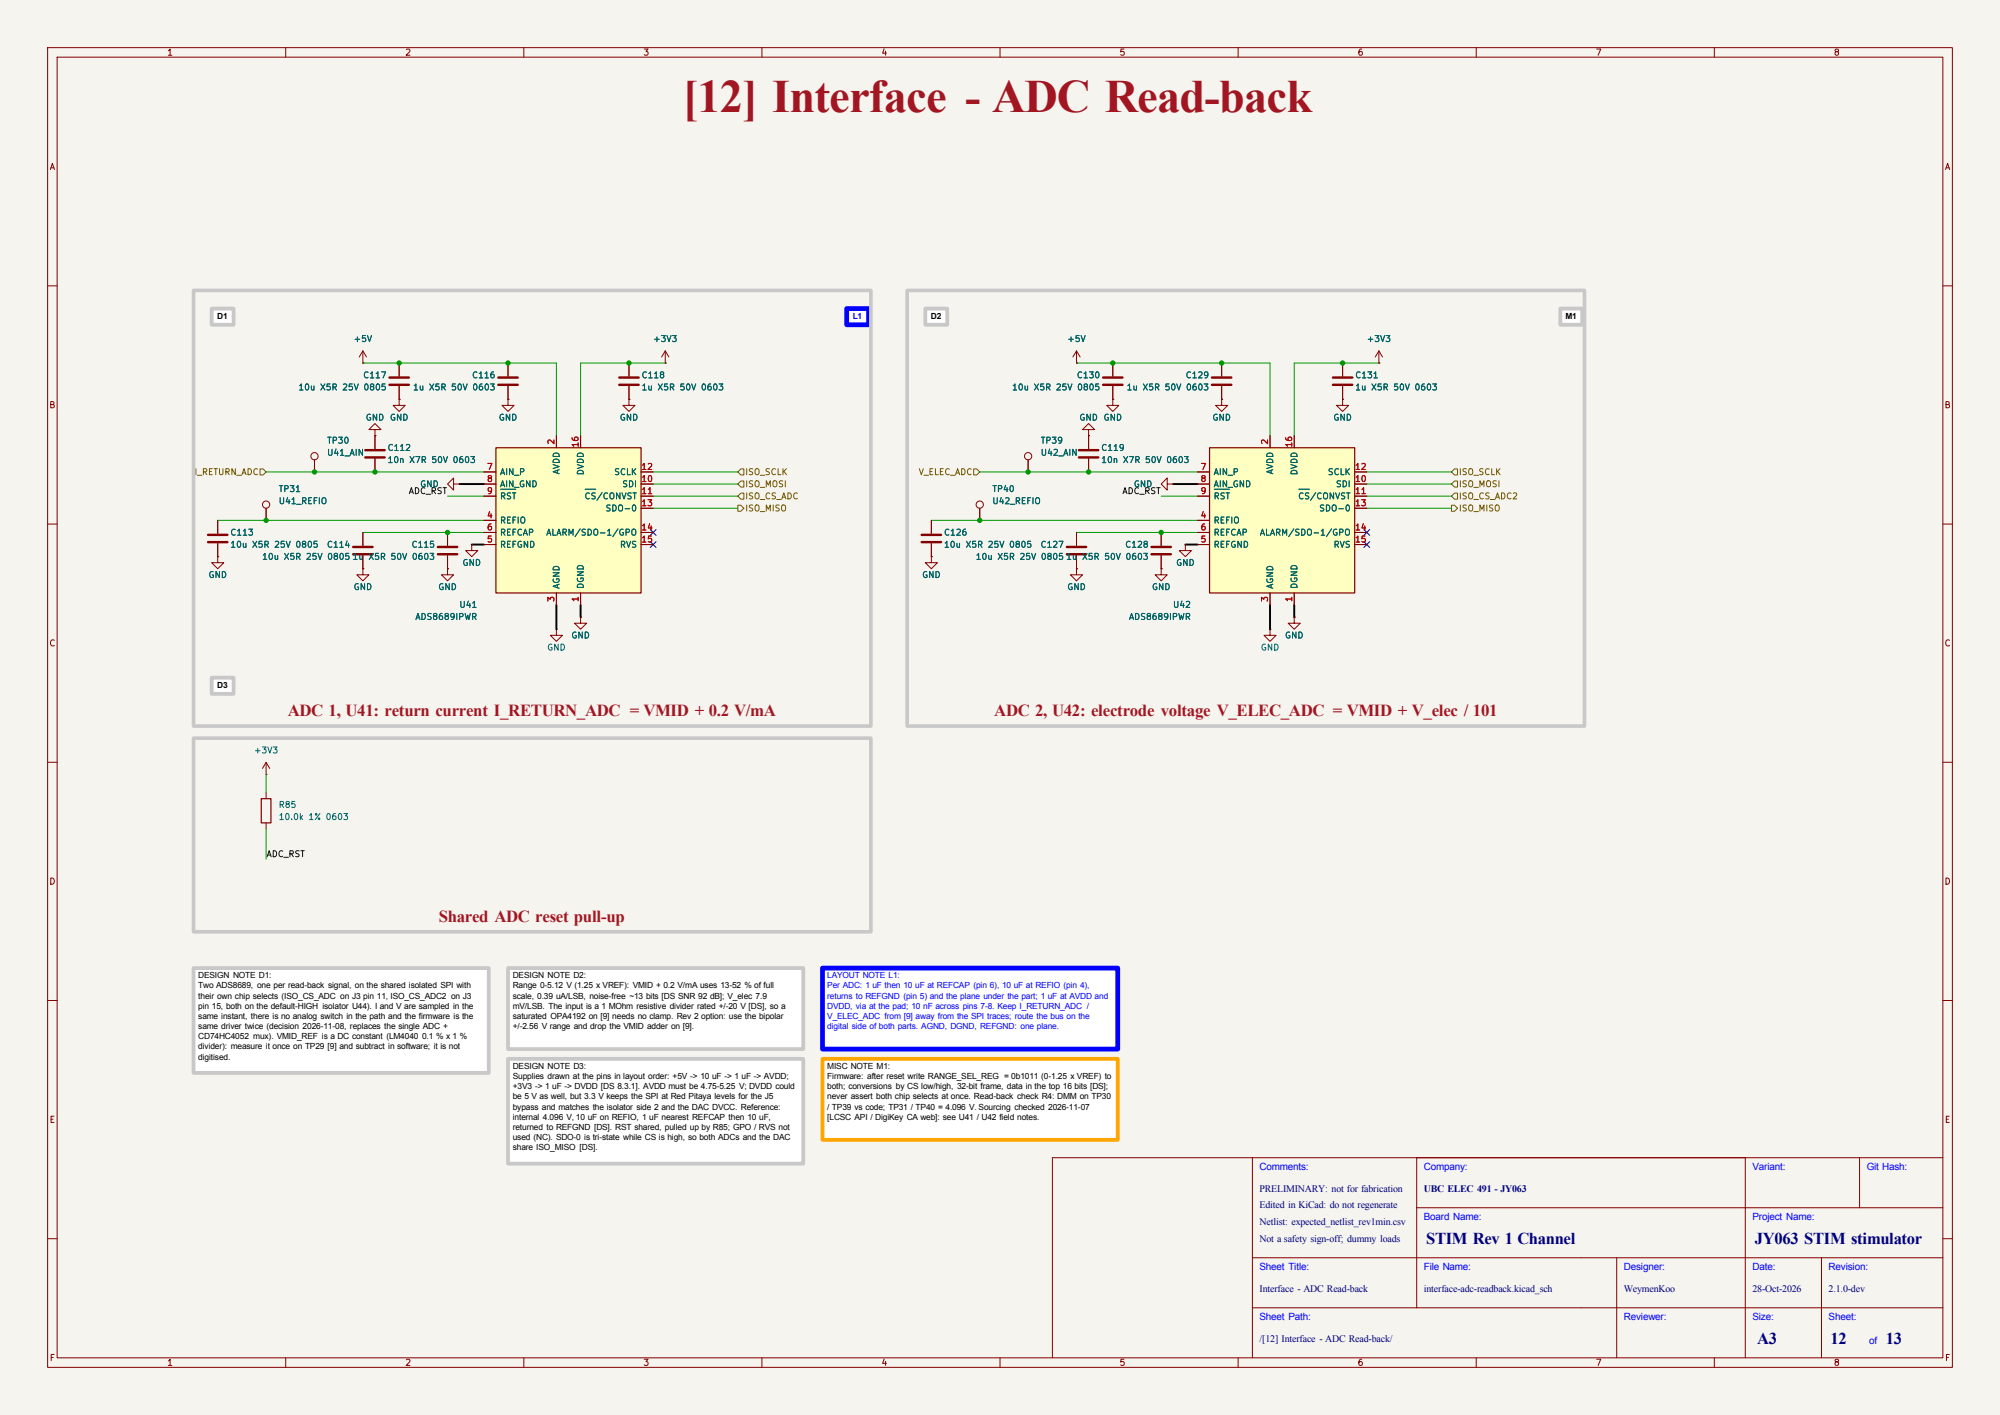
[picture p107: page 12]

L1 [12] Interface - ADC Read-back

Shared ADC reset pull-up

DESIGN NOTE D1: Two ADS8689, one per read-back signal, on the shared isolated SPI with

[LCSC API / DigiKey CA web]: see U41 / U42 field notes. DESIGN NOTE D2: Range 0-5.12 V (1.25 x VREF): VMID + 0.2 V/mA uses 13-52 % of full scale, 0.39 uA/LSB, noise-free ~13 bits [DS SNR 92 dB]; V_elec 7.9 mV/LSB. The input is a 1 MOhm resistive divider rated +/-20 V [DS], so a

LAYOUT NOTE L1: Per ADC: 1 uF then 10 uF at REFCAP (pin 6), 10 uF at REFIO (pin 4), returns to REFGND (pin 5) and the plane under the part; 1 uF at AVDD and DVDD, via at the pad; 10 nF across pins 7-8. Keep I_RETURN_ADC / V_ELEC_ADC from [9] away from the SPI traces; route the bus on the

their own chip selects (ISO_CS_ADC on J3 pin 11, ISO_CS_ADC2 on J3
pin 15, both on the default-HIGH isolator U44). I and V are sampled in the
same instant, there is no analog switch in the path and the firmware is the
same driver twice (decision 2026-11-08, replaces the single ADC + CD74HC4052 mux). VMID_REF is a DC constant (LM4040 0.1 % x 1 %

saturated OPA4192 on [9] needs no clamp. Rev 2 option: use the bipolar +/-2.56 V range and drop the VMID adder on [9].

digital side of both parts. AGND, DGND, REFGND: one plane. MISC NOTE M1: Firmware: after reset write RANGE_SEL_REG = 0b1011 (0-1.25 x VREF) to

divider): measure it once on TP29 [9] and subtract in software; it is not digitised.

DESIGN NOTE D3: Supplies drawn at the pins in layout order: +5V -> 10 uF -> 1 uF -> AVDD; +3V3 -> 1 uF -> DVDD [DS 8.3.1]. AVDD must be 4.75-5.25 V; DVDD could

both; conversions by CS low/high, 32-bit frame, data in the top 16 bits [DS]; never assert both chip selects at once. Read-back check R4: DMM on TP30

be 5 V as well, but 3.3 V keeps the SPI at Red Pitaya levels for the J5
bypass and matches the isolator side 2 and the DAC DVCC. Reference:
internal 4.096 V, 10 uF on REFIO, 1 uF nearest REFCAP then 10 uF, returned to REFGND [DS]. RST shared, pulled up by R85; GPO / RVS not used (NC). SDO-0 is tri-state while CS is high, so both ADCs and the DAC

/ TP39 vs code; TP31 / TP40 = 4.096 V. Sourcing checked 2026-11-07

Revision: 2.1.0-dev Date: Project Name: 28-Oct-2026 Reviewer: Designer:

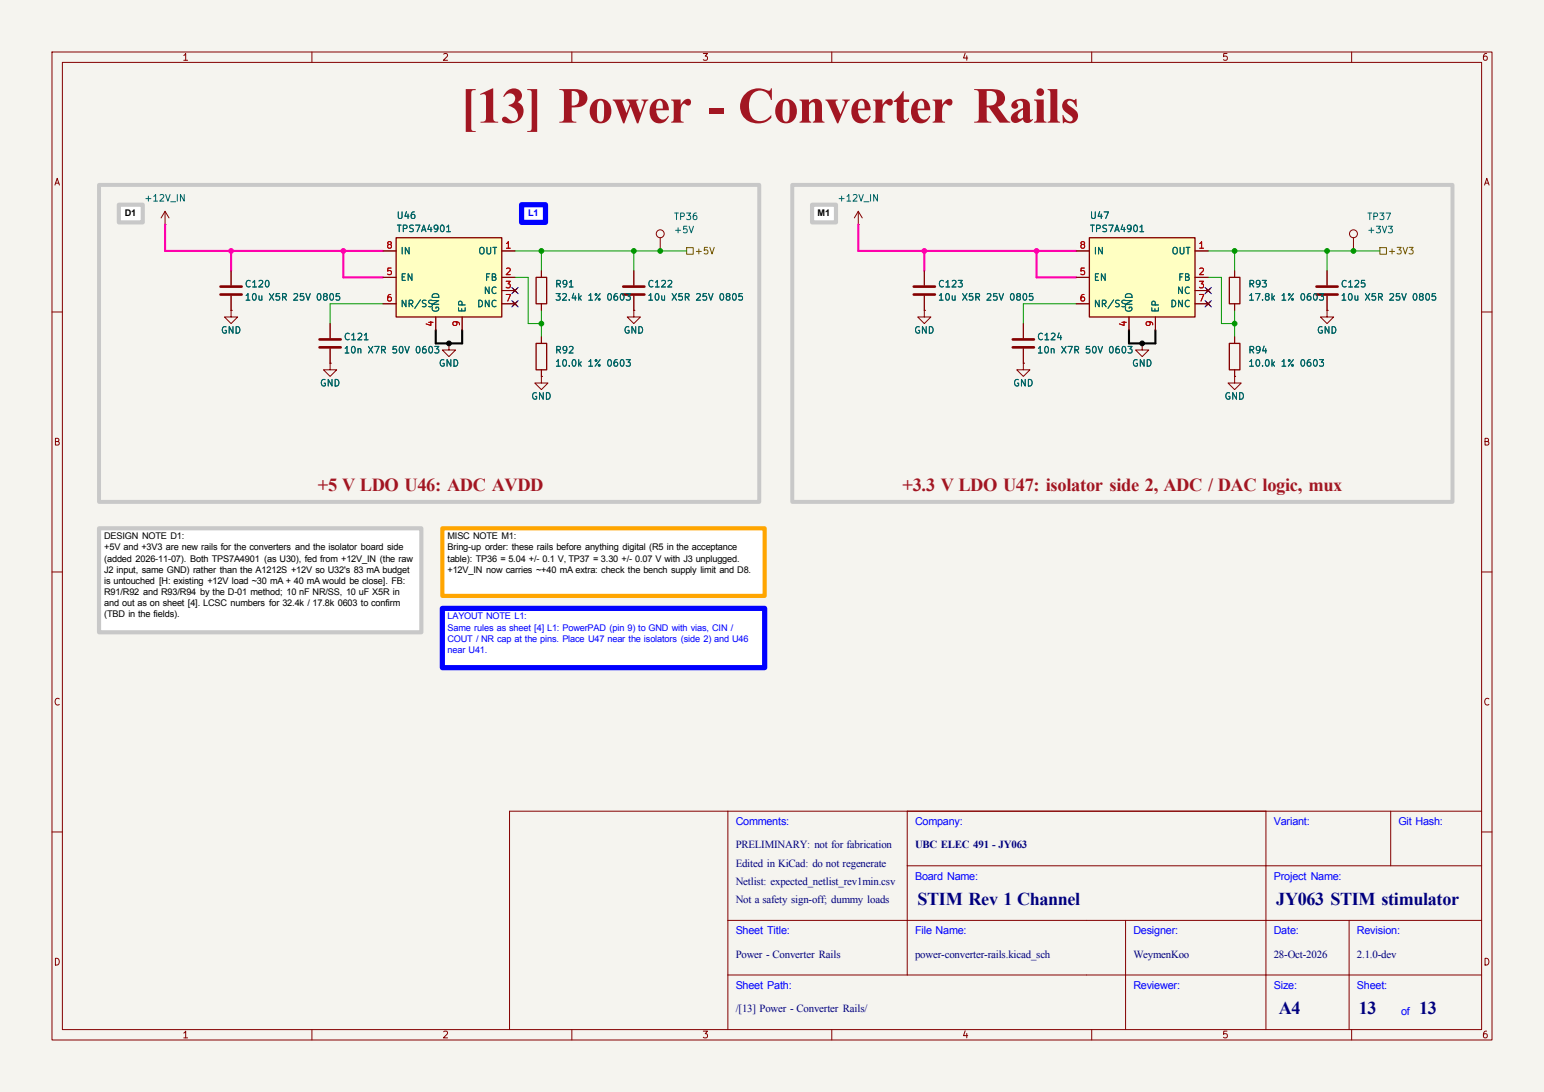
[picture p108: page 13]

D1 DESIGN NOTE D1: +5V and +3V3 are new rails for the converters and the isolator board side

MISC NOTE M1: Bring-up order: these rails before anything digital (R5 in the acceptance

(added 2026-11-07). Both TPS7A4901 (as U30), fed from +12V_IN (the raw
J2 input, same GND) rather than the A1212S +12V so U32's 83 mA budget
is untouched [H: existing +12V load ~30 mA + 40 mA would be close]. FB: R91/R92 and R93/R94 by the D-01 method; 10 nF NR/SS, 10 uF X5R in

table): TP36 = 5.04 +/- 0.1 V, TP37 = 3.30 +/- 0.07 V with J3 unplugged.
+12V_IN now carries ~+40 mA extra: check the bench supply limit and D8. LAYOUT NOTE L1: Same rules as sheet [4] L1: PowerPAD (pin 9) to GND with vias, CIN / COUT / NR cap at the pins. Place U47 near the isolators (side 2) and U46

and out as on sheet [4]. LCSC numbers for 32.4k / 17.8k 0603 to confirm
(TBD in the fields).

Revision: 2.1.0-dev Date: Project Name: 28-Oct-2026 Reviewer: Designer:
