WeymenKoo/STIM-Rev1-Hardware/03_safety_plan/kicad/safety-loop.pdf

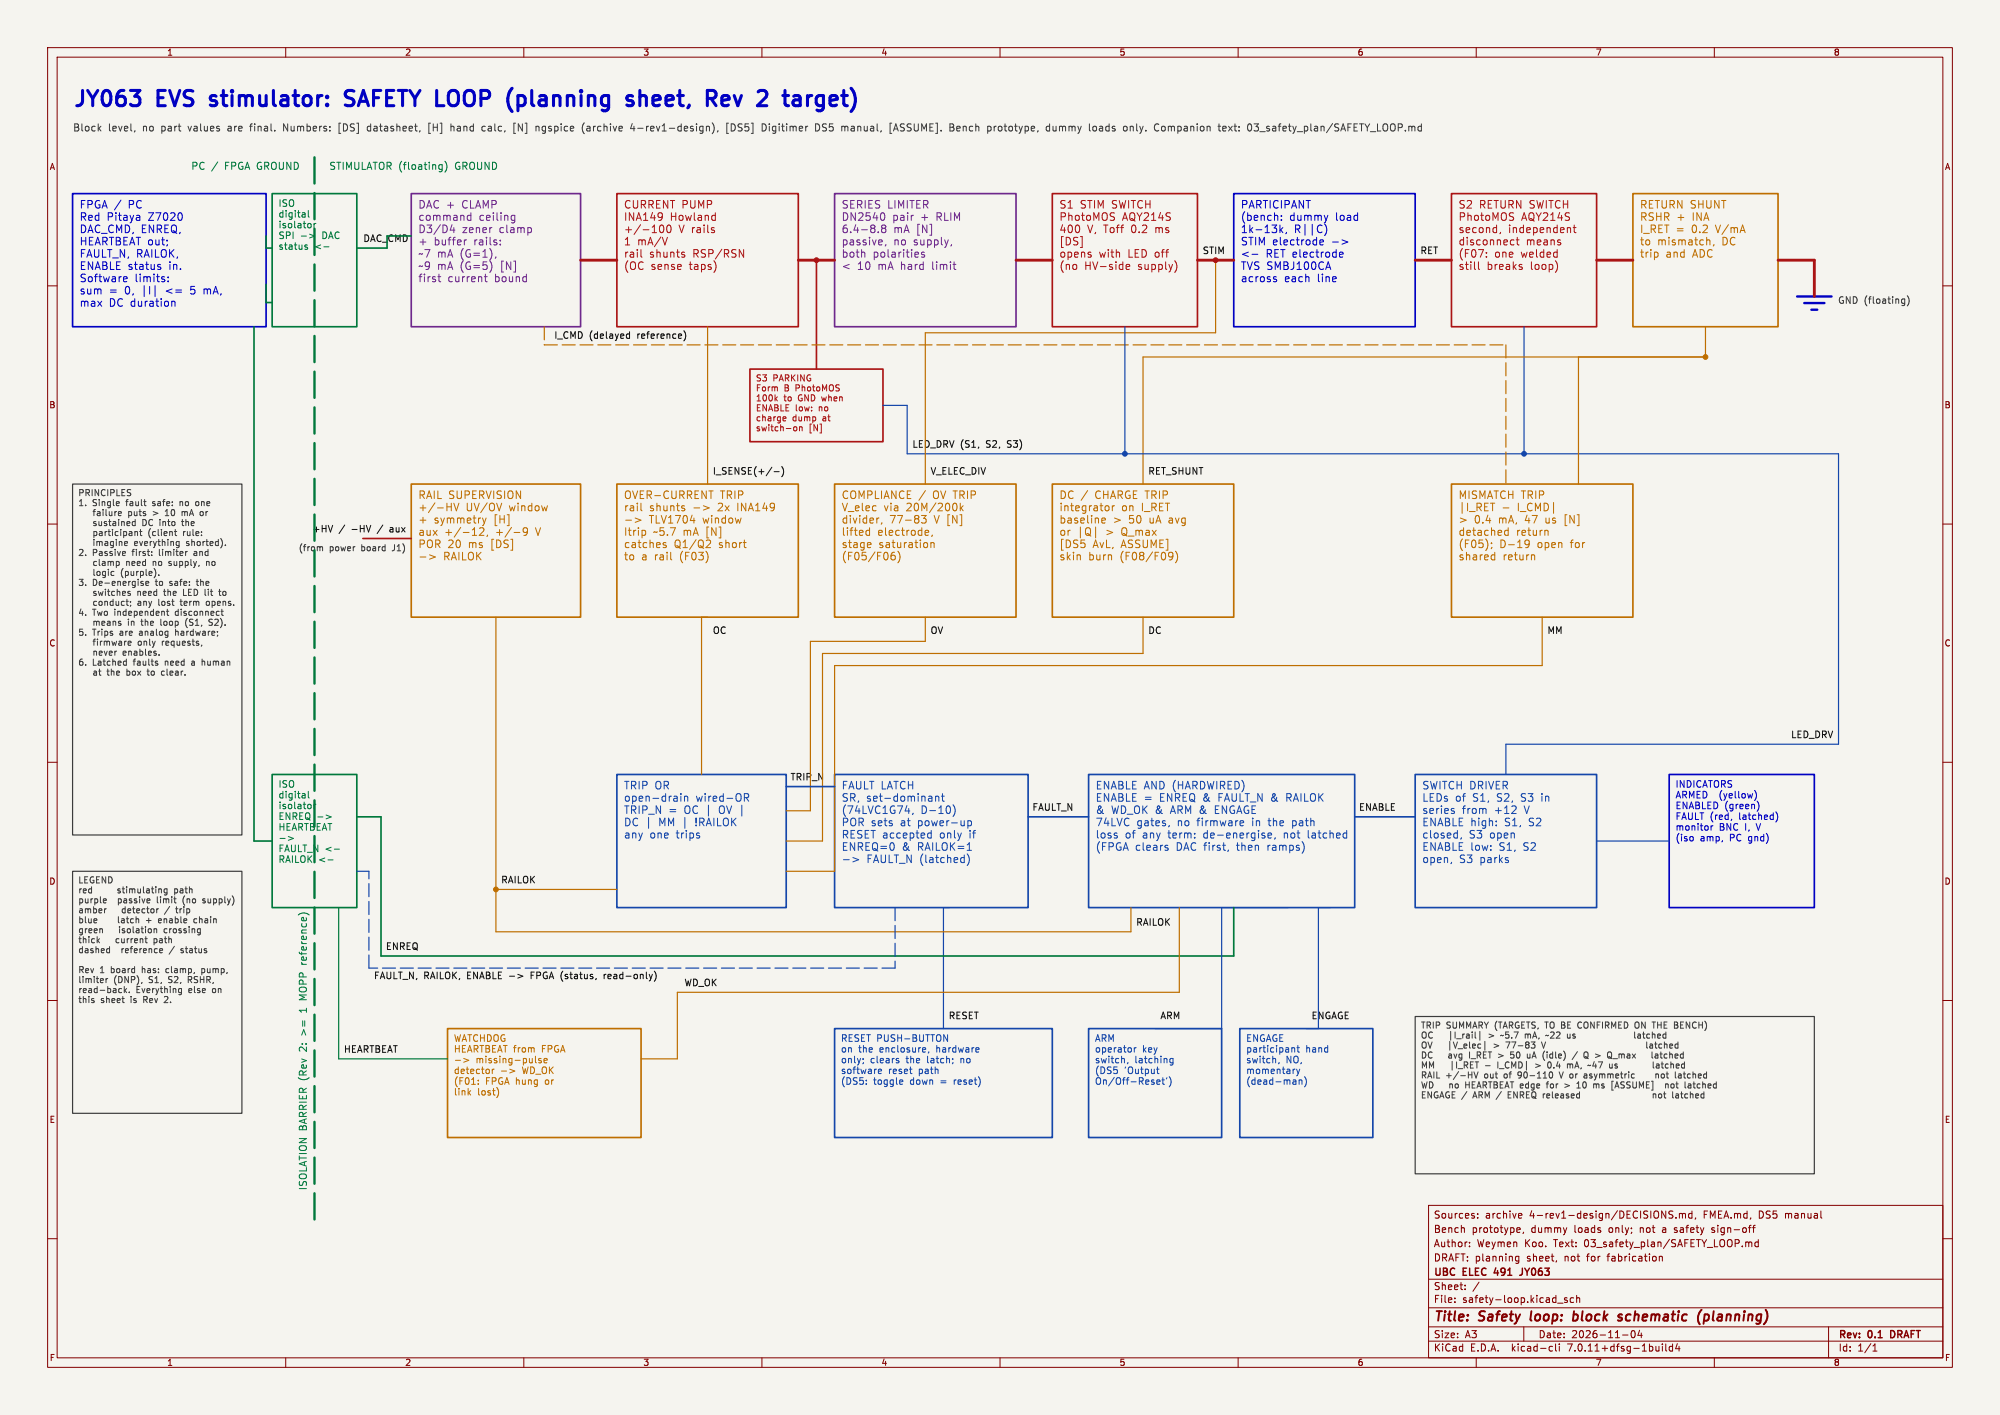
[picture p109: page 1]

DAC + CLAMP
command ceiling
D3/D4 zener clamp + buffer rails: ~7 mA (G=1),

SERIES LIMITER
DN2540 pair + RLIM
passive, no supply,
both polarities < 10 mA hard limit

S1 STIM SWITCH
PhotoMOS AQY214S
400 V, Toff 0.2 ms
opens with LED off

across each line WATCHDOG

rail shunts RSP/RSN

Form B PhotoMOS
100k to GND when ENABLE low: no
I_SENSE(+/-) OC

PRINCIPLES
1. Single fault safe: no one

shared return COMPLIANCE / OV TRIP
V_elec via 20M/200k
lifted electrode,
stage saturation

clamp need no supply, no

switches need the LED lit to

SR, set-dominant
(74LVC1G74, D-10)
POR sets at power-up
RESET accepted only if
ENREQ=0 & RAILOK=1

ENABLE AND (HARDWIRED)
ENABLE = ENREQ & FAULT_N & RAILOK
& WD_OK & ARM & ENGAGE
74LVC gates, no firmware in the path
(FPGA clears DAC first, then ramps) ARM

this sheet is Rev 2.

RESET PUSH-BUTTON
only; clears the latch; no
software reset path
(DS5: toggle down = reset)
