WeymenKoo/STIM-Rev1-Hardware/01_client_board/Client_Prototype_HowlandPump.pdf

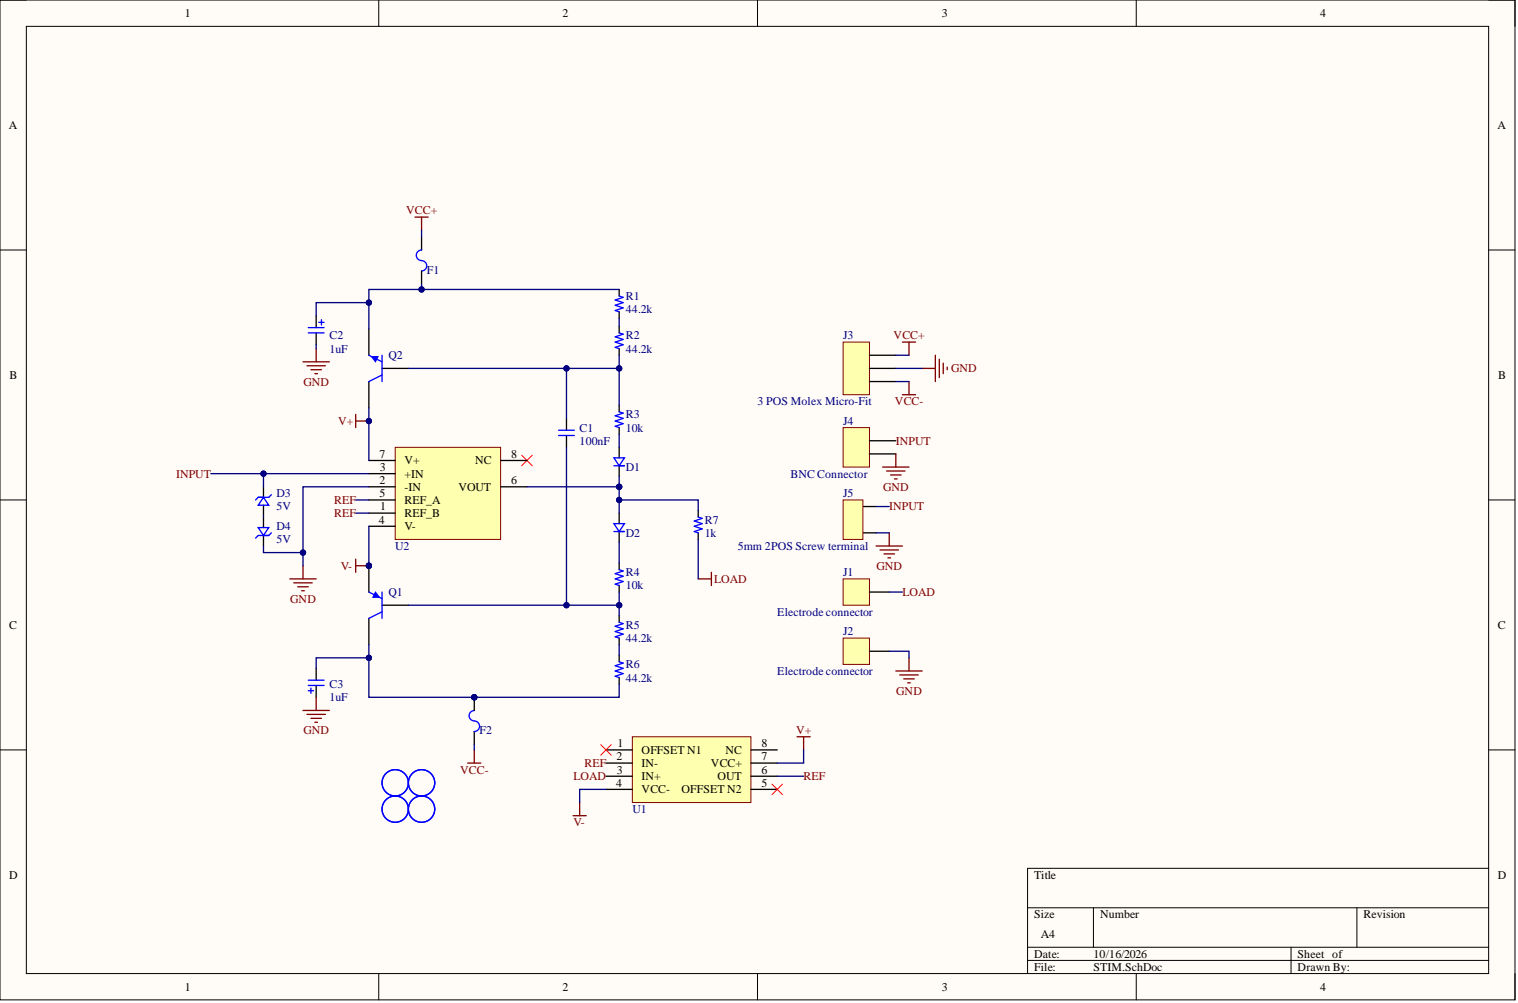
[picture p110: page 1]
