WeymenKoo/STIM-Rev1-Hardware/01_client_board/tests/A1-bias-bootstrap/A1-bias-bootstrap.asc

C1: cap; 100n
C2: cap; 1u
C3: cap; 1u
D1: diode; BAS16
D2: diode; BAS16
D3: zener_ka; DI_BZX84C5V1
D4: zener_ak; DI_BZX84C5V1
F1: res; 0.5
F2: res; 0.5
Q1: pnp_r; MJD350
Q2: npn_r; MJD340
R1: res; 44.2k
R2: res; 44.2k
R3: res; 10k
R4: res; 10k
R5: res; 44.2k
R6: res; 44.2k
R7: res; 1k
RLOAD: res; {RL}
Rsrc: res; 50
U1: TLE2141; TLE2141G
U2: INA149; INA149G
Vneg: voltage; {-Vrail}
Vpos: voltage; {Vrail}
Vwg: voltage; SINE(0 {Ipk*1k} {fsig} {Tset})
Named nets: VCCP, 0, INPUT, VCCN, REF, VP, VN, OUT, LOAD
.include ../../model/client-board-models.lib
.param RL=1k Ipk=5m fsig=300 Tset=1m
.step param Vrail list 30 100
.step param Ipk list 2m 5m
.tran 0 8m 0 1u
.meas tran Ipk_load MAX I(RLOAD) FROM 4m TO 8m
.meas tran Ierr_pct PARAM (Ipk_load-Ipk)/Ipk*100
.meas tran VP_minus_OUT AVG V(VP)-V(OUT) FROM 4m TO 8m
.meas tran VN_minus_OUT AVG V(VN)-V(OUT) FROM 4m TO 8m
.meas tran window_VP_VN AVG V(VP)-V(VN) FROM 4m TO 8m
.meas tran window_min MIN V(VP)-V(VN) FROM 4m TO 8m
.meas tran REF_VN_min MIN V(REF)-V(VN) FROM 4m TO 8m
.meas tran VP_OUT_min MIN V(VP)-V(OUT) FROM 4m TO 8m
.meas tran Irail_pos_mA AVG -1000*I(Vpos) FROM 4m TO 8m
.meas tran Irail_neg_mA AVG 1000*I(Vneg) FROM 4m TO 8m
.meas tran Vout_max MAX V(OUT) FROM 4m TO 8m
