WeymenKoo/STIM-Rev1-Hardware/01_client_board/tests/A2-accuracy-vs-command/A2-accuracy-vs-command.asc

C1: cap; 100n
C2: cap; 1u
C3: cap; 1u
D1: diode; BAS16
D2: diode; BAS16
D3: zener_ka; DI_BZX84C5V1
D4: zener_ak; DI_BZX84C5V1
F1: res; 0.5
F2: res; 0.5
Q1: pnp_r; MJD350
Q2: npn_r; MJD340
R1: res; 44.2k
R2: res; 44.2k
R3: res; 10k
R4: res; 10k
R5: res; 44.2k
R6: res; 44.2k
R7: res; 1k
RLOAD: res; {RL}
Rsrc: res; 50
U1: TLE2141; TLE2141G
U2: INA149; INA149G
Vneg: voltage; {-Vrail}
Vpos: voltage; {Vrail}
Vwg: voltage; {Icmd*1k}
Named nets: VCCP, 0, INPUT, VCCN, REF, VP, VN, OUT, LOAD
.include ../../model/client-board-models.lib
.param RL=1k Icmd=1m
.step param Vrail list 30 100
.step param Icmd list 0.5m 1m 2m 5m -2m -5m
.tran 0 2m 0 1u
.meas tran Iload AVG I(RLOAD) FROM 1.2m TO 2m
.meas tran err_pct PARAM (Iload-Icmd)/Icmd*100
.meas tran Vload AVG V(LOAD) FROM 1.2m TO 2m
