WeymenKoo/STIM-Rev1-Hardware/01_client_board/tests/A3-step-settling/A3-step-settling.asc

C1: cap; 100n
C2: cap; 1u
C3: cap; 1u
D1: diode; BAS16
D2: diode; BAS16
D3: zener_ka; DI_BZX84C5V1
D4: zener_ak; DI_BZX84C5V1
F1: res; 0.5
F2: res; 0.5
Q1: pnp_r; MJD350
Q2: npn_r; MJD340
R1: res; 44.2k
R2: res; 44.2k
R3: res; 10k
R4: res; 10k
R5: res; 44.2k
R6: res; 44.2k
R7: res; 1k
RLOAD: res; {RL}
Rsrc: res; 50
U1: TLE2141; TLE2141G
U2: INA149; INA149G
Vneg: voltage; {-Vrail}
Vpos: voltage; {Vrail}
Vwg: voltage; PWL(0 0 100u 0 101u {Istep*1k} 600u {Istep*1k} 601u {-Istep*1k} 1.1m {-Istep*1k})
Named nets: VCCP, 0, INPUT, VCCN, REF, VP, VN, OUT, LOAD
.include ../../model/client-board-models.lib
.param RL=1k Istep=2m
.step param Vrail list 30 100
.step param Istep list 2m 5m
.tran 0 1.2m 0 20n
.meas tran Ifin AVG I(RLOAD) FROM 300u TO 500u
.meas tran Ipk MAX I(RLOAD) FROM 100u TO 300u
.meas tran OS_pct PARAM (Ipk-Ifin)/Ifin*100
.meas tran t_enter_1pct FIND time WHEN I(RLOAD)=0.99*Istep RISE=1 TD=100u
.meas tran t_last_above FIND time WHEN I(RLOAD)=1.01*Istep FALL=1 TD=100u
.meas tran tset_us_approx PARAM (t_last_above-101u)*1e6
