WeymenKoo/STIM-Rev1-Hardware/01_client_board/tests/A4-frequency-response/A4-frequency-response.asc

C1: cap; 100n
C2: cap; 1u
C3: cap; 1u
D1: diode; BAS16
D2: diode; BAS16
D3: zener_ka; DI_BZX84C5V1
D4: zener_ak; DI_BZX84C5V1
F1: res; 0.5
F2: res; 0.5
Q1: pnp_r; MJD350
Q2: npn_r; MJD340
R1: res; 44.2k
R2: res; 44.2k
R3: res; 10k
R4: res; 10k
R5: res; 44.2k
R6: res; 44.2k
R7: res; 1k
RLOAD: res; {RL}
Rsrc: res; 50
U1: TLE2141; TLE2141G
U2: INA149; INA149G
Vneg: voltage; {-Vrail}
Vpos: voltage; {Vrail}
Vwg: voltage; SINE(0 0 300); AC 1
Named nets: VCCP, 0, INPUT, VCCN, REF, VP, VN, OUT, LOAD
.include ../../model/client-board-models.lib
.param RL=1k
.step param Vrail list 30 100
.ac dec 100 1 10Meg
.meas ac m_1Hz FIND mag(1000*I(RLOAD)) AT 1
.meas ac m_10Hz FIND mag(1000*I(RLOAD)) AT 10
.meas ac m_100Hz FIND mag(1000*I(RLOAD)) AT 100
.meas ac m_300Hz FIND mag(1000*I(RLOAD)) AT 300
.meas ac m_1kHz FIND mag(1000*I(RLOAD)) AT 1k
.meas ac m_10kHz FIND mag(1000*I(RLOAD)) AT 10k
.meas ac dB_10k_vs_1 PARAM 20*log10(m_10kHz/m_1Hz)
.meas ac ph_300Hz FIND ph(1000*I(RLOAD)) AT 300
.meas ac pk MAX mag(1000*I(RLOAD))
