WeymenKoo/STIM-Rev1-Hardware/01_client_board/tests/A5a-output-impedance-ac/A5a-output-impedance-ac.asc

C1: cap; 100n
C2: cap; 1u
C3: cap; 1u
D1: diode; BAS16
D2: diode; BAS16
D3: zener_ka; DI_BZX84C5V1
D4: zener_ak; DI_BZX84C5V1
F1: res; 0.5
F2: res; 0.5
Itest: current; 0; AC 1
Q1: pnp_r; MJD350
Q2: npn_r; MJD340
R1: res; 44.2k
R2: res; 44.2k
R3: res; 10k
R4: res; 10k
R5: res; 44.2k
R6: res; 44.2k
R7: res; 1k
RLOAD: res; {RL}
Rsrc: res; {RS}
U1: TLE2141; TLE2141G
U2: INA149; INA149G
Vneg: voltage; {-Vrail}
Vpos: voltage; {Vrail}
Vwg: voltage; SINE(0 0 300)
Named nets: VCCP, 0, INPUT, VCCN, REF, VP, VN, OUT, LOAD
.include ../../model/client-board-models.lib
.param RL=1G RS=50
.step param Vrail list 30 100
.step param RS list 50 1u
.ac dec 20 1 1Meg
.meas ac Z_1Hz FIND mag(V(LOAD)) AT 1
.meas ac Z_100Hz FIND mag(V(LOAD)) AT 100
.meas ac Z_1kHz FIND mag(V(LOAD)) AT 1k
.meas ac Z_10kHz FIND mag(V(LOAD)) AT 10k
.meas ac C_out_pF_at_10k PARAM 1e12/(2*pi*10k*Z_10kHz)
