WeymenKoo/STIM-Rev1-Hardware/01_client_board/tests/A7-rail-loss/A7-rail-loss.asc

C1: cap; 100n
C2: cap; 1u
C3: cap; 1u
D1: diode; BAS16
D2: diode; BAS16
D3: zener_ka; DI_BZX84C5V1
D4: zener_ak; DI_BZX84C5V1
F1: res; 0.5
F2: res; 0.5
Q1: pnp_r; MJD350
Q2: npn_r; MJD340
R1: res; 44.2k
R2: res; 44.2k
R3: res; 10k
R4: res; 10k
R5: res; 44.2k
R6: res; 44.2k
R7: res; 1k
RLOAD: res; {RL}
Rsrc: res; 50
U1: TLE2141; TLE2141G
U2: INA149; INA149G
Vneg: voltage; PWL(0 {VN0} {TN} {VN0} {TN+1m} {-Vrail})
Vpos: voltage; PWL(0 {VP0} 0.5m {VP0} 1.5m {Vrail} 10m {Vrail} 11m {VPE})
Vwg: voltage; {Icmd*1k}
Named nets: VCCP, 0, INPUT, VCCN, REF, VP, VN, OUT, LOAD
.include ../../model/client-board-models.lib
.param RL=1k Icmd=2m SEQ=1
.step param Vrail list 30 100
.step param SEQ list 1 2 3
.param VP0={if(SEQ==2,Vrail,0)} VPE={if(SEQ==2,0,Vrail)} VN0={if(SEQ==2,-Vrail,0)} TN={if(SEQ==1,5m,0.5m)}
.tran 0 60m 0 1u
.meas tran I_max_mA MAX 1000*I(RLOAD)
.meas tran I_min_mA MIN 1000*I(RLOAD)
.meas tran I_end_mA AVG 1000*I(RLOAD) FROM 40m TO 60m
.meas tran Vload_max MAX V(LOAD)
.meas tran Vload_min MIN V(LOAD)
