WeymenKoo/STIM-Rev1-Hardware/02_rev1_channel/Kicad Projects/STIM_Rev1/STIM_Rev1.kicad_pcb

## KiCad design 02_rev1_channel/Kicad Projects/STIM_Rev1/STIM_Rev1.kicad_pcb (2026-11-05)

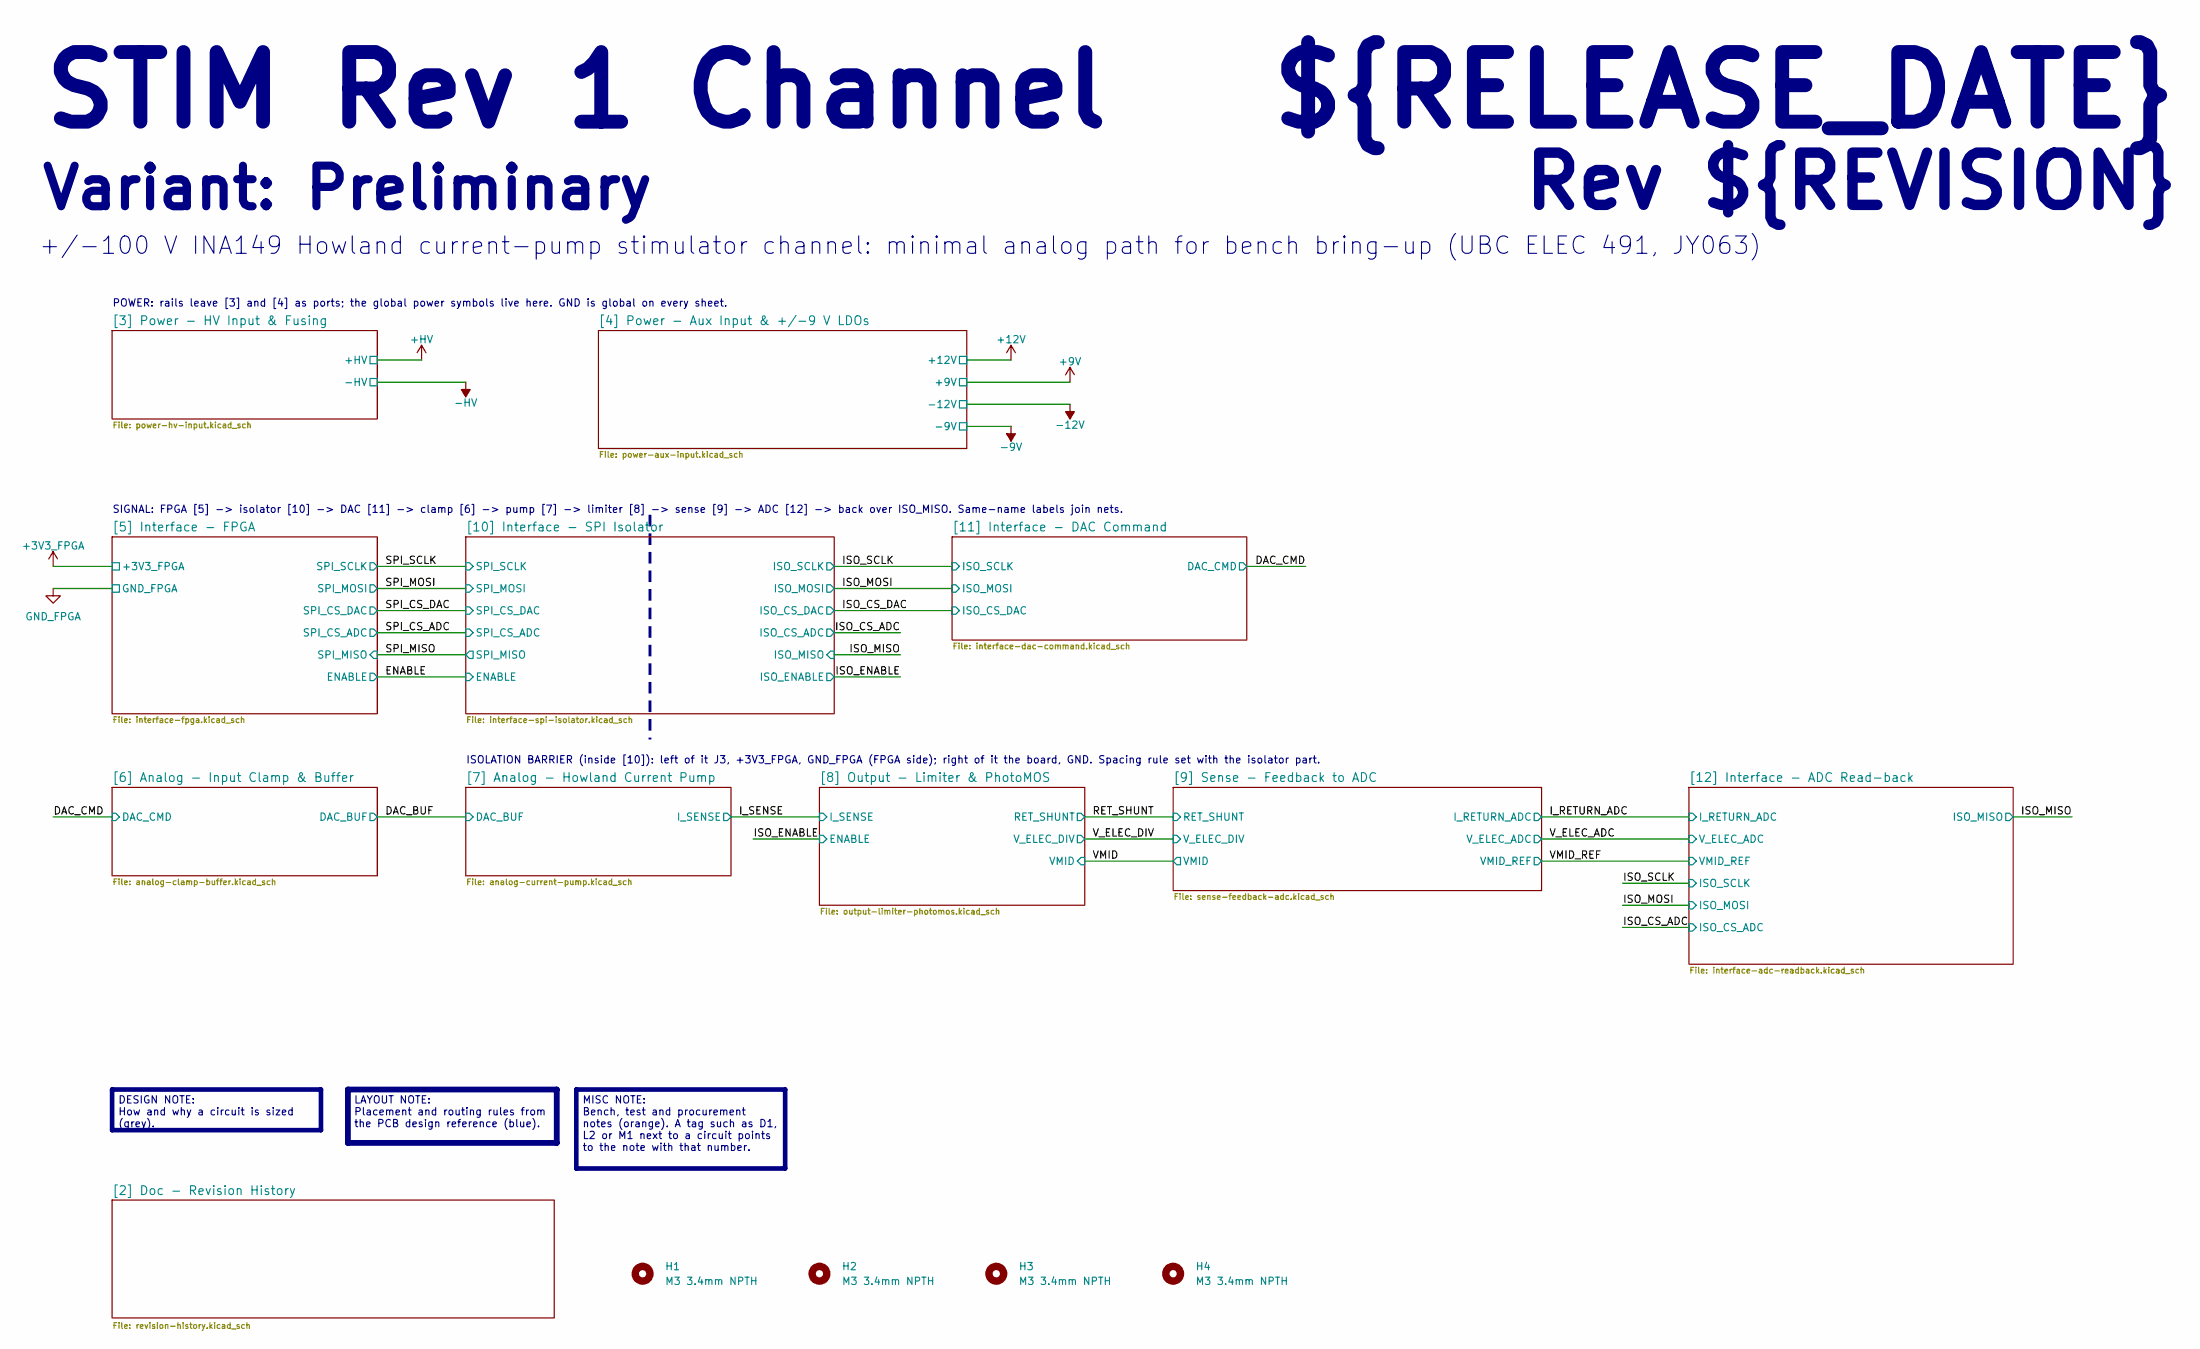
[picture p111: schematic STIM_Rev1.kicad_sch, Doc - Cover]

Parts:
H1, H2, H3, H4: M3 3.4mm NPTH; MountingHole_3.4mm_M3_Keepout6.5mm

Notes on the sheet:
Variant: Preliminary
${RELEASE_DATE}
STIM Rev 1 Channel
+/-100 V INA149 Howland current-pump stimulator channel: minimal analog path for bench bring-up (UBC ELEC 491, JY063)
Rev ${REVISION}
MISC NOTE: Bench, test and procurement notes (orange). A tag such as D1, L2 or M1 next to a circuit points to the note with that number.
LAYOUT NOTE: Placement and routing rules from the PCB design reference (blue).
DESIGN NOTE: How and why a circuit is sized (grey).
POWER: rails leave [3] and [4] as ports; the global power symbols live here. GND is global on every sheet.
ISOLATION BARRIER (inside [10]): left of it J3, +3V3_FPGA, GND_FPGA (FPGA side); right of it the board, GND. Spacing rule set with the isolator part.
SIGNAL: FPGA [5] -> isolator [10] -> DAC [11] -> clamp [6] -> pump [7] -> limiter [8] -> sense [9] -> ADC [12] -> back over ISO_MISO. Same-name labels join nets.

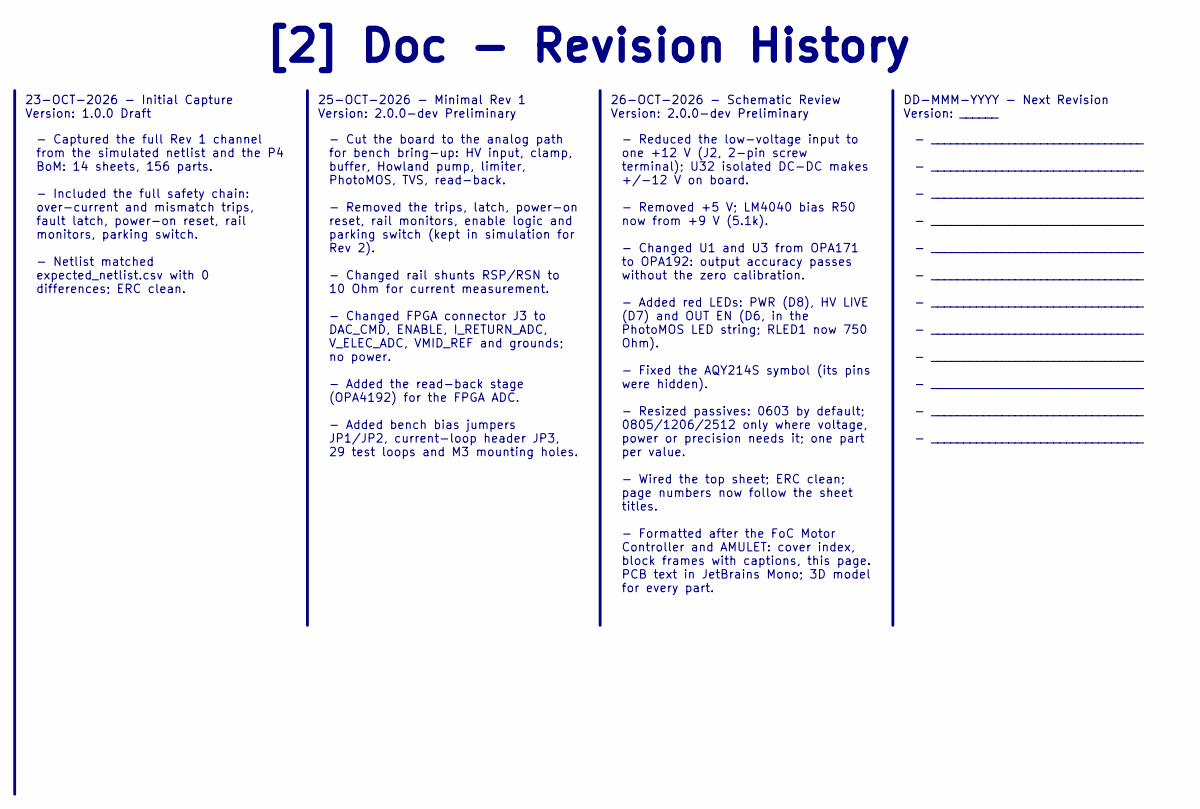
[picture p112: schematic revision-history.kicad_sch, Doc - Revision History]

Notes on the sheet:
23-OCT-2026 - Initial Capture Version: 1.0.0 Draft
25-OCT-2026 - Minimal Rev 1 Version: 2.0.0-dev Preliminary
- Cut the board to the analog path for bench bring-up: HV input, clamp, buffer, Howland pump, limiter, PhotoMOS, TVS, read-back. - Removed the trips, latch, power-on reset, rail monitors, enable logic and parking switch (kept in simulation for Rev 2). - Changed rail shunts RSP/RSN to 10 Ohm for cur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
26-OCT-2026 - Schematic Review Version: 2.0.0-dev Preliminary
[2] Doc - Revision History
- _________________________________ - _________________________________ - _________________________________ - _________________________________ - _________________________________ - _________________________________ - _________________________________ - _________________________________ - _________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
DD-MMM-YYYY - Next Revision Version: ______
- Captured the full Rev 1 channel from the simulated netlist and the P4 BoM: 14 sheets, 156 parts. - Included the full safety chain: over-current and mismatch trips, fault latch, power-on reset, rail monitors, parking switch. - Netlist matched expected_netlist.csv with 0 differences; ERC clean.
- Reduced the low-voltage input to one +12 V (J2, 2-pin screw terminal); U32 isolated DC-DC makes +/-12 V on board. - Removed +5 V; LM4040 bias R50 now from +9 V (5.1k). - Changed U1 and U3 from OPA171 to OPA192: output accuracy passes without the zero calibration. - Added red LEDs: PWR (D8), HV LI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

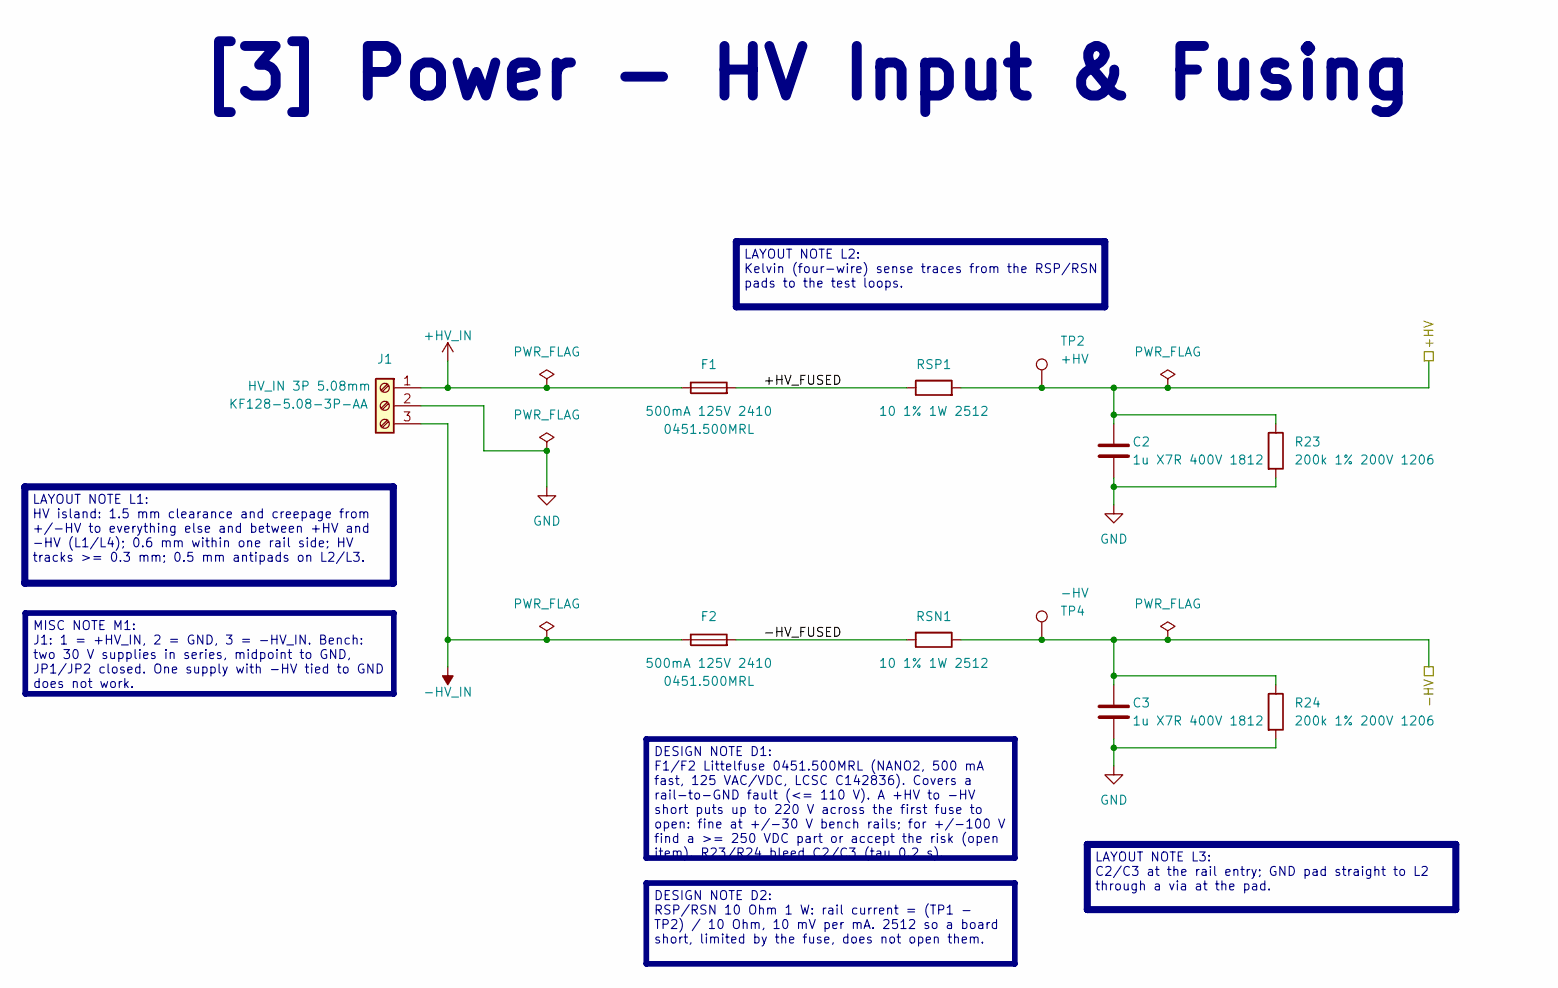
[picture p113: schematic power-hv-input.kicad_sch, Power - HV Input & Fusing]

Parts:
C2, C3: 1u X7R 400V 1812; C_1812_4532Metric; MPN FE2CX105M501LFL; LCSC C19267793
F1, F2: 500mA 125V 2410; Fuse_2410_6125Metric_SST; MPN 0451.500MRL; LCSC C142836
J1: HV_IN 3P 5.08mm; TerminalBlock_Phoenix_MKDS-1,5-3-5.08_1x03_P5.08mm_Horizont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; MPN KF128-5.08-3P-AA; LCSC C474953
R23, R24: 200k 1% 200V 1206; R_1206_3216Metric; MPN 1206W4F2003T5E; LCSC C17954
RSN1: 10 1% 1W 2512; R_2512_6332Metric; MPN 25121WF100JT4E; LCSC C47019
RSP1: 10 1% 1W 2512; R_2512_6332Metric; MPN 25121WF100JT4E; LCSC C47019
TP2: +HV; TestPoint_Keystone_5000-5004_Miniature
TP4: -HV; TestPoint_Keystone_5000-5004_Miniature

Connections:
+HV: C2.1, R23.1, RSP1.2, TP2.1 (1_1); also elsewhere on the board
+HV_IN: F1.1, J1.1; also elsewhere on the board
-HV: C3.1, R24.1, RSN1.1, TP4.1 (1_1); also elsewhere on the board
-HV_IN: F2.1, J1.3; also elsewhere on the board
/[3] Power - HV Input & Fusing/+HV_FUSED: F1.2, RSP1.1
/[3] Power - HV Input & Fusing/-HV_FUSED: F2.2, RSN1.2

Notes on the sheet:
[3] Power - HV Input & Fusing
DESIGN NOTE D1: F1/F2 Littelfuse 0451.500MRL (NANO2, 500 mA fast, 125 VAC/VDC, LCSC C142836). Covers a rail-to-GND fault (<= 110 V). A +HV to -HV short puts up to 220 V across the first fuse to open: fine at +/-30 V bench rails; for +/-100 V find a >= 250 VDC part or accept the risk (open item). R2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
DESIGN NOTE D2: RSP/RSN 10 Ohm 1 W: rail current = (TP1 - TP2) / 10 Ohm, 10 mV per mA. 2512 so a board short, limited by the fuse, does not open them.
LAYOUT NOTE L1: HV island: 1.5 mm clearance and creepage from +/-HV to everything else and between +HV and -HV (L1/L4); 0.6 mm within one rail side; HV tracks >= 0.3 mm; 0.5 mm antipads on L2/L3.
LAYOUT NOTE L3: C2/C3 at the rail entry; GND pad straight to L2 through a via at the pad.
LAYOUT NOTE L2: Kelvin (four-wire) sense traces from the RSP/RSN pads to the test loops.
MISC NOTE M1: J1: 1 = +HV_IN, 2 = GND, 3 = -HV_IN. Bench: two 30 V supplies in series, midpoint to GND, JP1/JP2 closed. One supply with -HV tied to GND does not work.

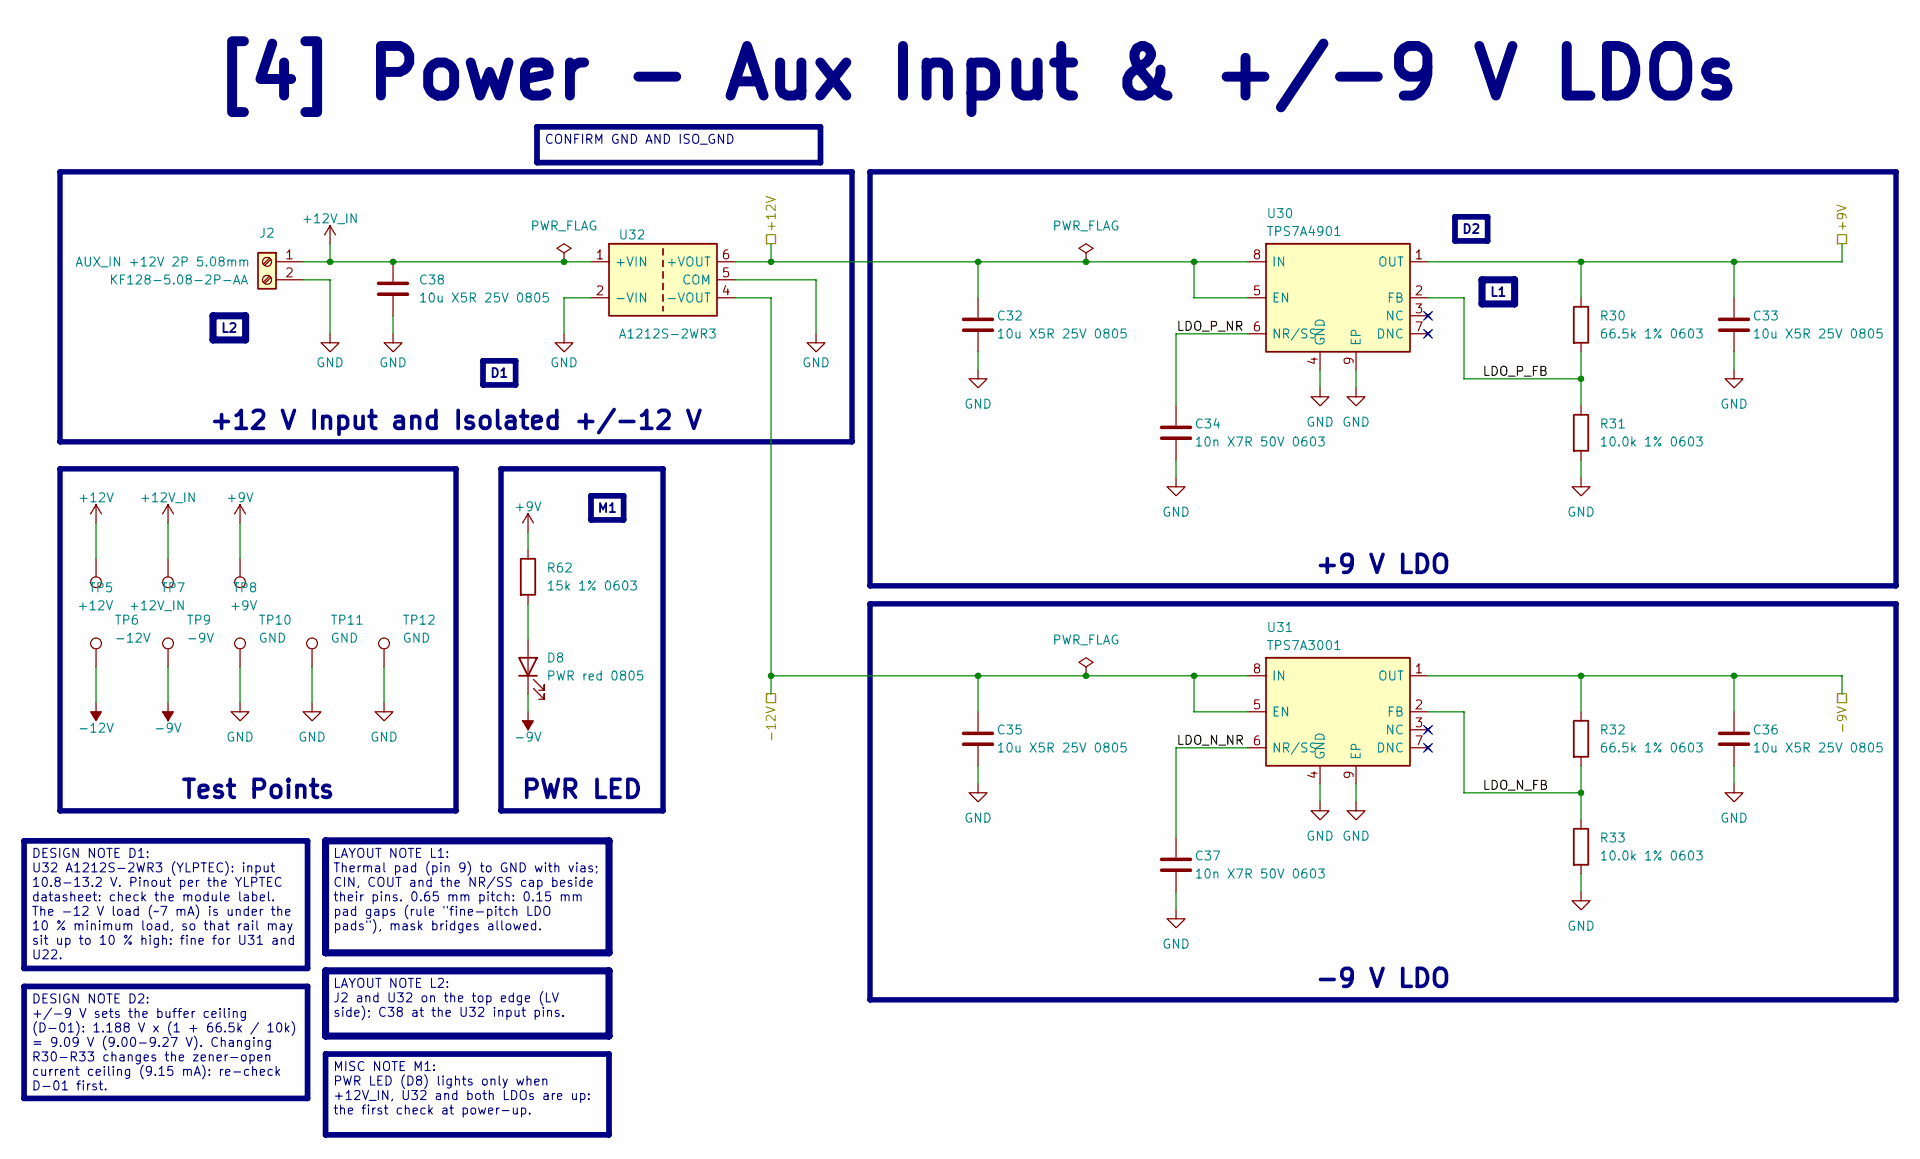
[picture p114: schematic power-aux-input.kicad_sch, Power - Aux Input & +/-9 V LDOs]

Parts:
C32, C33, C35, C36, C38: 10u X5R 25V 0805; C_0805_2012Metric; MPN CL21A106KAYNNNE; LCSC C15850
C34, C37: 10n X7R 50V 0603; C_0603_1608Metric; MPN CL10B103KB8NNNC; LCSC C1589
D8: PWR red 0805; LED_0805_2012Metric; MPN NCD0805R1; LCSC C84256
J2: AUX_IN +12V 2P 5.08mm; TerminalBlock_Phoenix_MKDS-1,5-2-5.08_1x02_P5.08mm_Horizont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; MPN KF128-5.08-2P-AA; LCSC C474952
R30, R32: 66.5k 1% 0603; R_0603_1608Metric; MPN 0603WAF6652T5E; LCSC C23225
R31, R33: 10.0k 1% 0603; R_0603_1608Metric; MPN 0603WAF1002T5E; LCSC C25804
R62: 15k 1% 0603; R_0603_1608Metric; MPN 0603WAF1502T5E; LCSC C22809
TP5: +12V; TestPoint_Keystone_5000-5004_Miniature
TP6: -12V; TestPoint_Keystone_5000-5004_Miniature
TP7: +12V_IN; TestPoint_Keystone_5000-5004_Miniature
TP8: +9V; TestPoint_Keystone_5000-5004_Miniature
TP9: -9V; TestPoint_Keystone_5000-5004_Miniature
TP10, TP11, TP12: GND; TestPoint_Keystone_5000-5004_Miniature
U30: TPS7A4901; Texas_DGN0008D_VSSOP-8-1EP_3x3mm_P0.65mm_EP2x2.94mm_Mask1.5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
U31: TPS7A3001; Texas_DGN0008D_VSSOP-8-1EP_3x3mm_P0.65mm_EP2x2.94mm_Mask1.5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
U32: A1212S-2WR3; Converter_DCDC_A_S-2WR3_SIP-6_P2.54mm; MPN A1212S-2WR3; LCSC C5369434

Connections:
+9V: C33.1, R30.1, R62.1, TP8.1 (1_1), U30.1 (OUT); also elsewhere on the board
+12V: C32.1, TP5.1 (1_1), U30.5 (EN), U30.8 (IN), U32.6 (+VOUT); also elsewhere on the board
+12V_IN: C38.1, J2.1, TP7.1 (1_1), U32.1 (+VIN)
-9V: C36.1, D8.1 (K), R32.1, TP9.1 (1_1), U31.1 (OUT); also elsewhere on the board
-12V: C35.1, TP6.1 (1_1), U31.5 (EN), U31.8 (IN), U32.4 (-VOUT); also elsewhere on the board
/[4] Power - Aux Input & +/-9 V LDOs/LDO_N_FB: R32.2, R33.1, U31.2 (FB)
/[4] Power - Aux Input & +/-9 V LDOs/LDO_N_NR: C37.1, U31.6 (NR/SS)
/[4] Power - Aux Input & +/-9 V LDOs/LDO_P_FB: R30.2, R31.1, U30.2 (FB)
/[4] Power - Aux Input & +/-9 V LDOs/LDO_P_NR: C34.1, U30.6 (NR/SS)
unnamed: D8.2 (A), R62.2

Notes on the sheet:
Test Points
PWR LED
-9 V LDO
CONFIRM GND AND ISO_GND
+9 V LDO
LAYOUT NOTE L1: Thermal pad (pin 9) to GND with vias; CIN, COUT and the NR/SS cap beside their pins. 0.65 mm pitch: 0.15 mm pad gaps (rule "fine-pitch LDO pads"), mask bridges allowed.
LAYOUT NOTE L2: J2 and U32 on the top edge (LV side); C38 at the U32 input pins.
DESIGN NOTE D1: U32 A1212S-2WR3 (YLPTEC): input 10.8-13.2 V. Pinout per the YLPTEC datasheet: check the module label. The -12 V load (~7 mA) is under the 10 % minimum load, so that rail may sit up to 10 % high: fine for U31 and U22.
MISC NOTE M1: PWR LED (D8) lights only when +12V_IN, U32 and both LDOs are up: the first check at power-up.
DESIGN NOTE D2: +/-9 V sets the buffer ceiling (D-01): 1.188 V x (1 + 66.5k / 10k) = 9.09 V (9.00-9.27 V). Changing R30-R33 changes the zener-open current ceiling (9.15 mA): re-check D-01 first.
[4] Power - Aux Input & +/-9 V LDOs
+12 V Input and Isolated +/-12 V

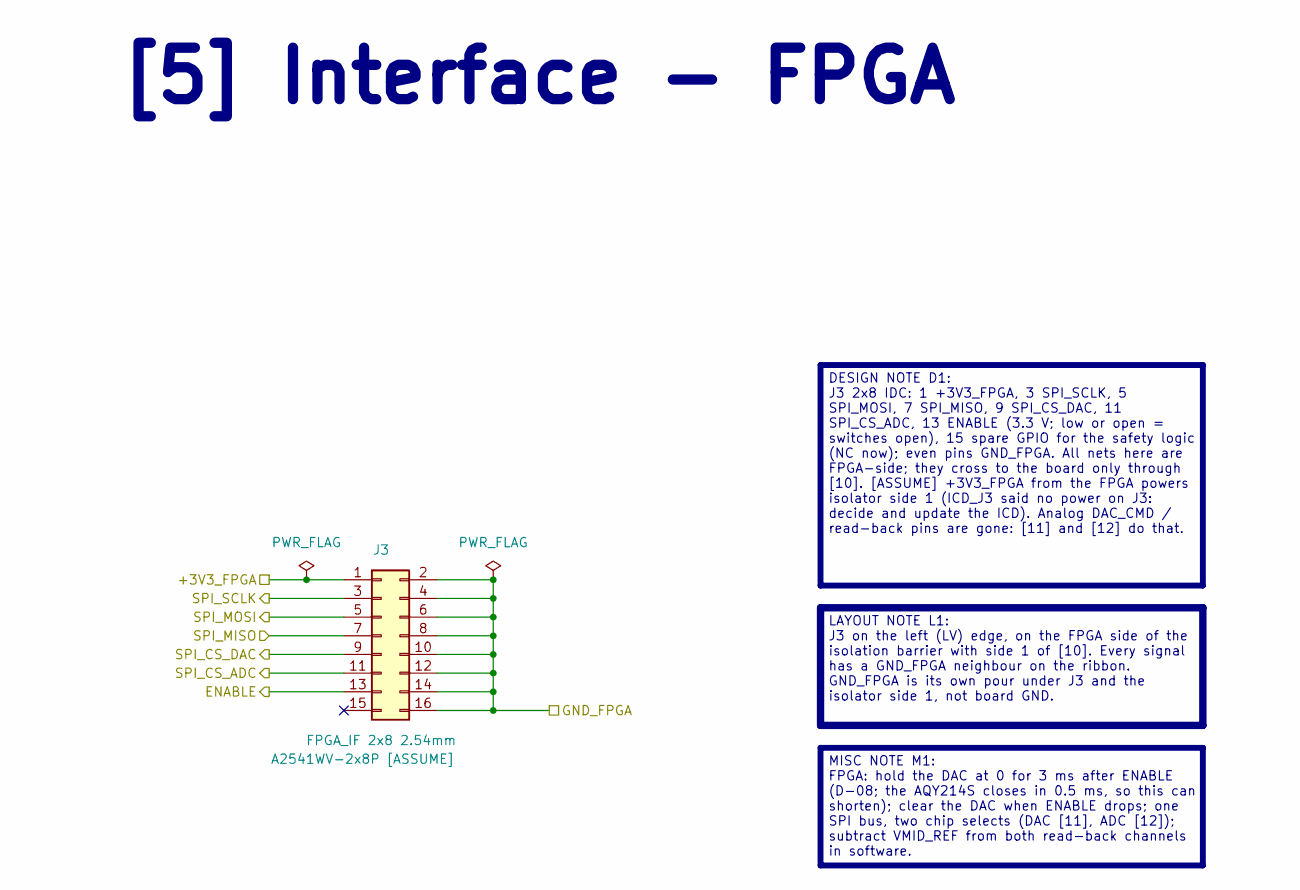
[picture p115: schematic interface-fpga.kicad_sch, Interface - FPGA]

Parts:
J3: FPGA_IF 2x8 2.54mm; IDC-Header_2x08_P2.54mm_Vertical; MPN A2541WV-2x8P [ASSUME]; JLC Extended

Connections:
/ENABLE: J3.3; also elsewhere on the board
/I_RETURN_ADC: J3.5; also elsewhere on the board
/VMID_REF: J3.9; also elsewhere on the board
/V_ELEC_ADC: J3.7; also elsewhere on the board

Notes on the sheet:
[5] Interface - FPGA
LAYOUT NOTE L1: J3 on the left (LV) edge, on the FPGA side of the isolation barrier with side 1 of [10]. Every signal has a GND_FPGA neighbour on the ribbon. GND_FPGA is its own pour under J3 and the isolator side 1, not board GND.
DESIGN NOTE D1: J3 2x8 IDC: 1 +3V3_FPGA, 3 SPI_SCLK, 5 SPI_MOSI, 7 SPI_MISO, 9 SPI_CS_DAC, 11 SPI_CS_ADC, 13 ENABLE (3.3 V; low or open = switches open), 15 spare GPIO for the safety logic (NC now); even pins GND_FPGA. All nets here are FPGA-side; they cross to the board only through [10]. [ASSUME]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
MISC NOTE M1: FPGA: hold the DAC at 0 for 3 ms after ENABLE (D-08; the AQY214S closes in 0.5 ms, so this can shorten); clear the DAC when ENABLE drops; one SPI bus, two chip selects (DAC [11], ADC [12]); subtract VMID_REF from both read-back channels in software.

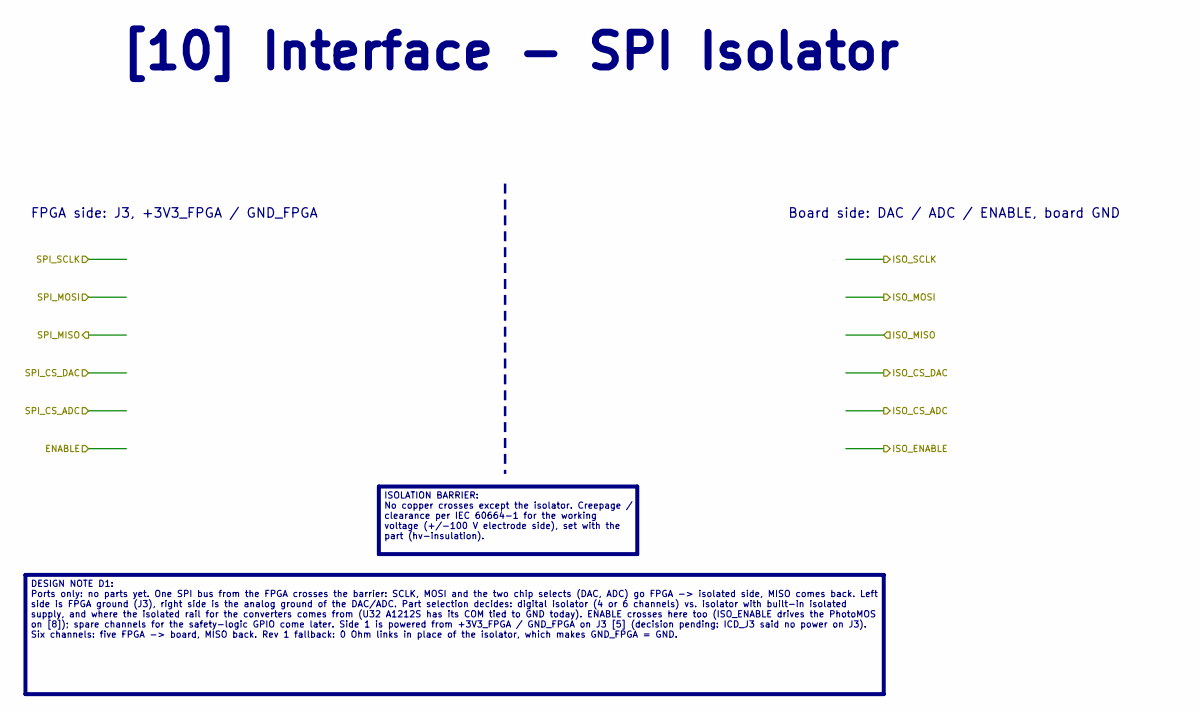
[picture p116: schematic interface-spi-isolator.kicad_sch, Interface - SPI Isolator]

Notes on the sheet:
ISOLATION BARRIER: No copper crosses except the isolator. Creepage / clearance per IEC 60664-1 for the working voltage (+/-100 V electrode side), set with the part (hv-insulation).
FPGA side: J3, +3V3_FPGA / GND_FPGA
Board side: DAC / ADC / ENABLE, board GND
DESIGN NOTE D1: Ports only: no parts yet. One SPI bus from the FPGA crosses the barrier: SCLK, MOSI and the two chip selects (DAC, ADC) go FPGA -> isolated side, MISO comes back. Left side is FPGA ground (J3), right side is the analog ground of the DAC/ADC. Part selection decides: digital isolator 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
[10] Interface - SPI Isolator

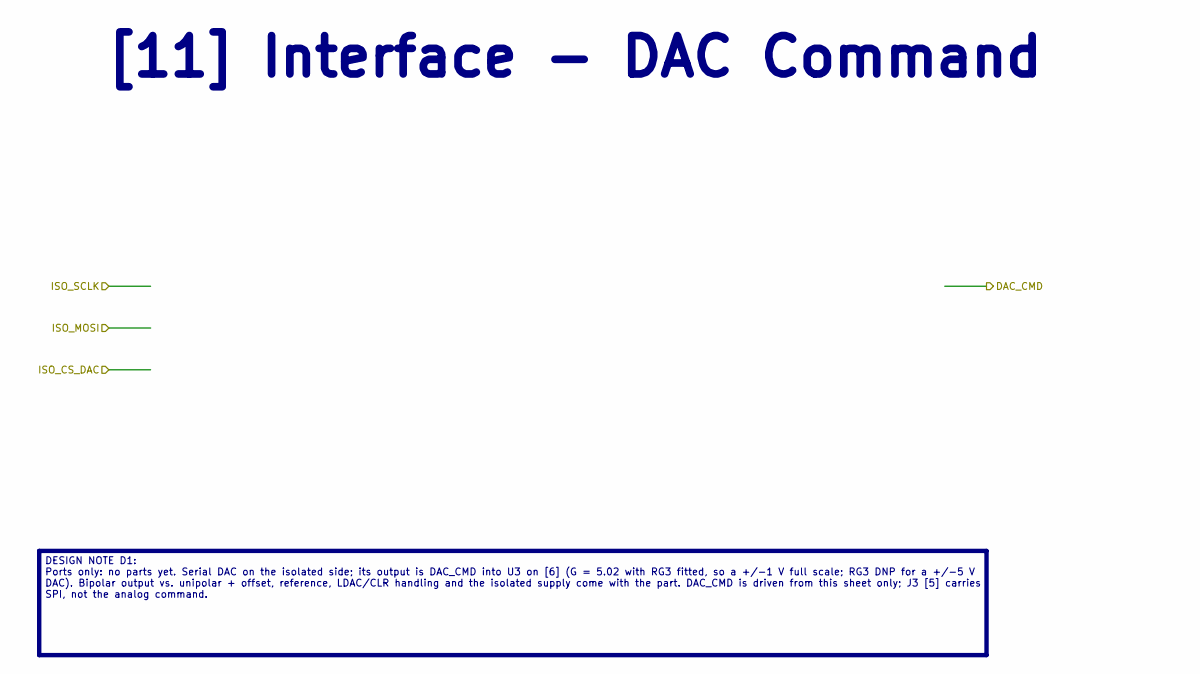
[picture p117: schematic interface-dac-command.kicad_sch, Interface - DAC Command]

Notes on the sheet:
[11] Interface - DAC Command
DESIGN NOTE D1: Ports only: no parts yet. Serial DAC on the isolated side; its output is DAC_CMD into U3 on [6] (G = 5.02 with RG3 fitted, so a +/-1 V full scale; RG3 DNP for a +/-5 V DAC). Bipolar output vs. unipolar + offset, reference, LDAC/CLR handling and the isolated supply come with the part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

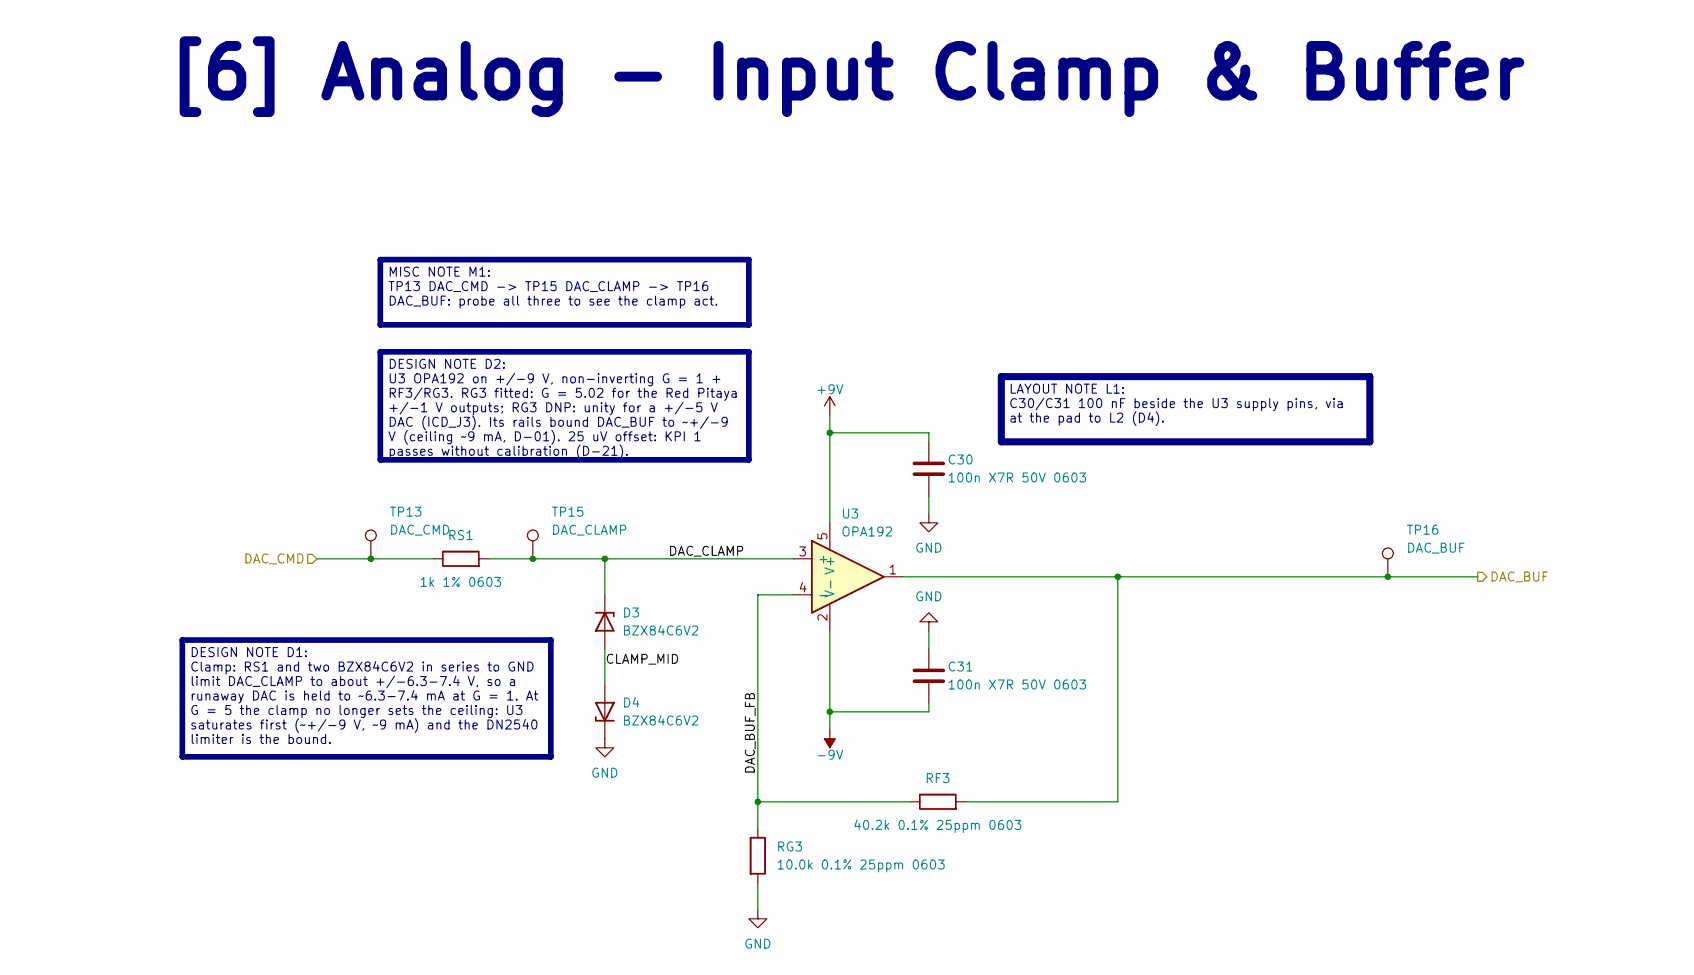
[picture p118: schematic analog-clamp-buffer.kicad_sch, Analog - Input Clamp & Buffer]

Parts:
C30, C31: 100n X7R 50V 0603; C_0603_1608Metric; MPN CL10B104KB8NNNC; LCSC C1591
D3, D4: BZX84C6V2; SOT-23; MPN BZX84C6V2LT1G; LCSC C82470
RF3: 40.2k 0.1% 25ppm 0603; R_0603_1608Metric; MPN RT0603BRD0740K2L; LCSC C723489
RG3: 10.0k 0.1% 25ppm 0603; R_0603_1608Metric; MPN RT0603BRD0710KL; LCSC C95204
RS1: 1k 1% 0603; R_0603_1608Metric; MPN 0603WAF1001T5E; LCSC C21190
TP13: DAC_CMD; TestPoint_Keystone_5000-5004_Miniature
TP15: DAC_CLAMP; TestPoint_Keystone_5000-5004_Miniature
TP16: DAC_BUF; TestPoint_Keystone_5000-5004_Miniature
U3: OPA192; SOT-23-5; MPN OPA192IDBVR; LCSC C139648

Connections:
+9V: C30.1, U3.5 (V+); also elsewhere on the board
-9V: C31.1, U3.2 (V-); also elsewhere on the board
/DAC_BUF: RF3.2, TP16.1 (1_1), U3.1; also elsewhere on the board
/[6] Analog - Input Clamp & Buffer/CLAMP_MID: D3.1 (A), D4.1 (A)
/[6] Analog - Input Clamp & Buffer/DAC_BUF_FB: RF3.1, RG3.1, U3.4 (-)
/[6] Analog - Input Clamp & Buffer/DAC_CLAMP: D3.3 (K), RS1.2, TP15.1 (1_1), U3.3 (+)

Notes on the sheet:
[6] Analog - Input Clamp & Buffer
LAYOUT NOTE L1: C30/C31 100 nF beside the U3 supply pins, via at the pad to L2 (D4).
DESIGN NOTE D1: Clamp: RS1 and two BZX84C6V2 in series to GND limit DAC_CLAMP to about +/-6.3-7.4 V, so a runaway DAC is held to ~6.3-7.4 mA at G = 1. At G = 5 the clamp no longer sets the ceiling: U3 saturates first (~+/-9 V, ~9 mA) and the DN2540 limiter is the bound.
MISC NOTE M1: TP13 DAC_CMD -> TP15 DAC_CLAMP -> TP16 DAC_BUF: probe all three to see the clamp act.
DESIGN NOTE D2: U3 OPA192 on +/-9 V, non-inverting G = 1 + RF3/RG3. RG3 fitted: G = 5.02 for the Red Pitaya +/-1 V outputs; RG3 DNP: unity for a +/-5 V DAC (ICD_J3). Its rails bound DAC_BUF to ~+/-9 V (ceiling ~9 mA, D-01). 25 uV offset: KPI 1 passes without calibration (D-21).

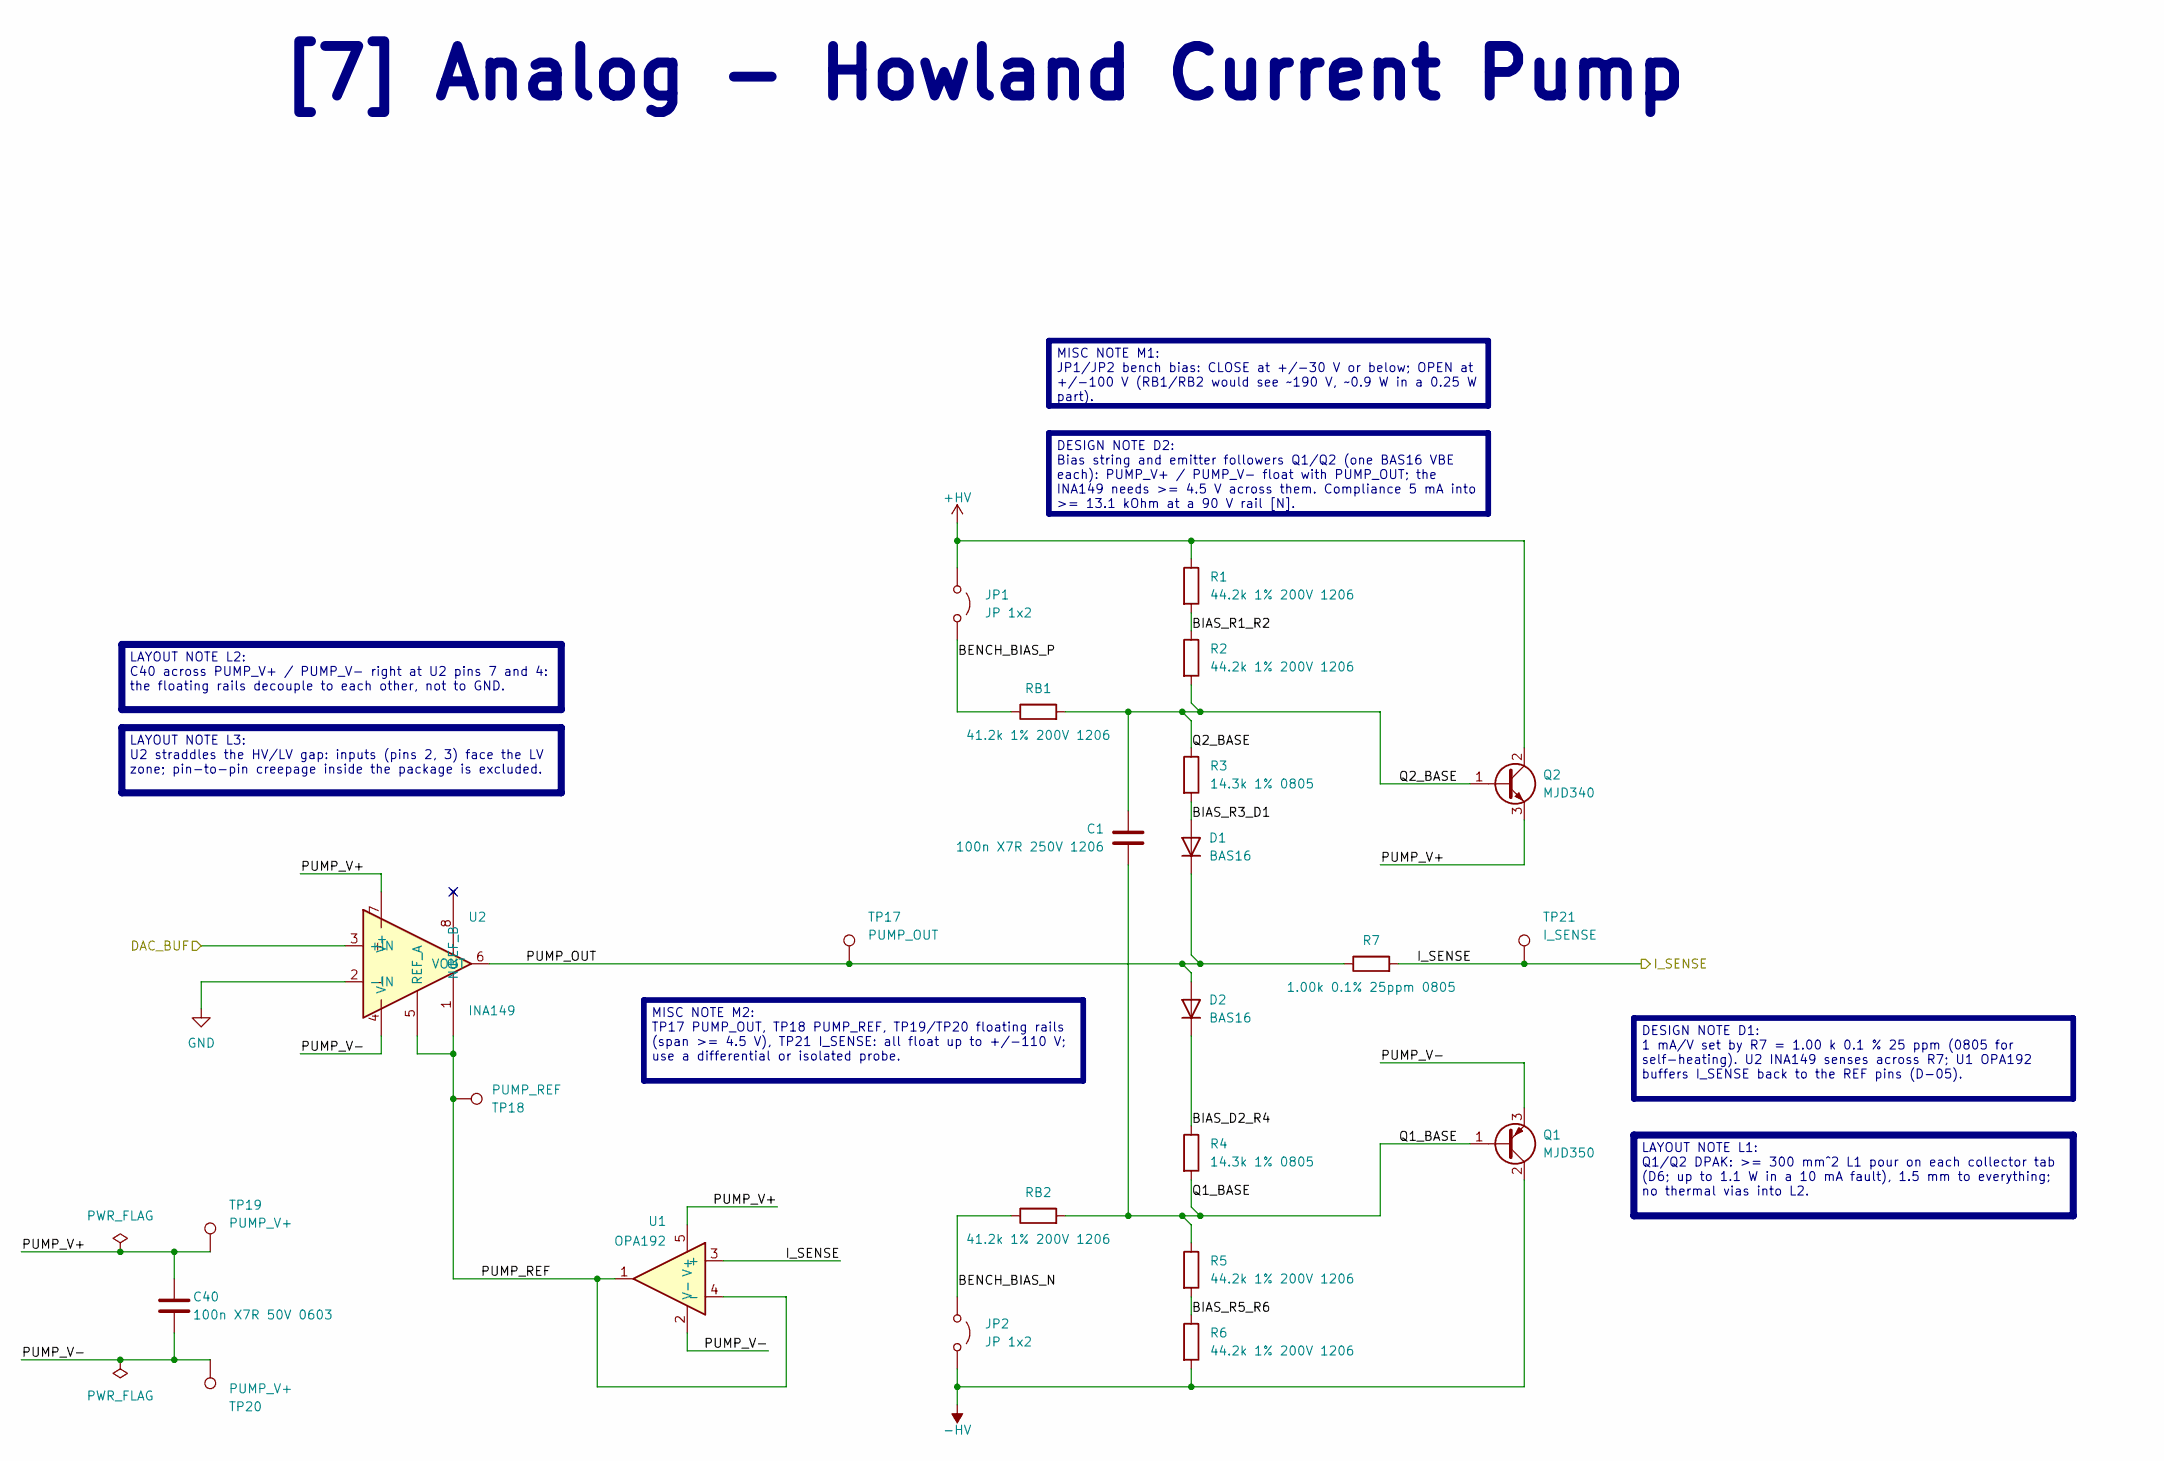
[picture p119: schematic analog-current-pump.kicad_sch, Analog - Howland Current Pump]

Parts:
C1: 100n X7R 250V 1206; C_1206_3216Metric; MPN TCC1206X7R104M251FT; LCSC C282822
C40: 100n X7R 50V 0603; C_0603_1608Metric; MPN CL10B104KB8NNNC; LCSC C1591
D1, D2: BAS16; SOT-23; MPN BAS16 A6; LCSC C8489
JP1, JP2: JP 1x2; PinHeader_1x02_P2.54mm_Vertical
Q1: MJD350; TO-252-2; MPN MJD350-13; LCSC C460225
Q2: MJD340; TO-252-2; MPN MJD340-13; LCSC C443830
R1, R2, R5, R6: 44.2k 1% 200V 1206; R_1206_3216Metric; MPN CL1206FN44K2PS; LCSC C53284084
R3, R4: 14.3k 1% 0805; R_0805_2012Metric; MPN 0805W8F1432T5E; LCSC C17456
R7: 1.00k 0.1% 25ppm 0805; R_0805_2012Metric; MPN RT0805BRD071KL; LCSC C110774
RB1, RB2: 41.2k 1% 200V 1206; R_1206_3216Metric; MPN 1206W4F4122T5E; LCSC C247267
TP17: PUMP_OUT; TestPoint_Keystone_5000-5004_Miniature
TP18: PUMP_REF; TestPoint_Keystone_5000-5004_Miniature
TP19, TP20: PUMP_V+; TestPoint_Keystone_5000-5004_Miniature
TP21: I_SENSE; TestPoint_Keystone_5000-5004_Miniature
U1: OPA192; SOT-23-5; MPN OPA192IDBVR; LCSC C139648
U2: INA149; SOIC-8_3.9x4.9mm_P1.27mm; MPN INA149AIDR; LCSC C183089

Connections:
+HV: JP1.1 (A), Q2.2 (C), R1.1; also elsewhere on the board
-HV: JP2.2 (B), Q1.2 (C), R6.2; also elsewhere on the board
/DAC_BUF: U2.3 (+IN); also elsewhere on the board
/[7] Analog - Howland Current Pump/BENCH_BIAS_N: JP2.1 (A), RB2.1
/[7] Analog - Howland Current Pump/BENCH_BIAS_P: JP1.2 (B), RB1.1
/[7] Analog - Howland Current Pump/BIAS_D2_R4: D2.3 (K), R4.1
/[7] Analog - Howland Current Pump/BIAS_R1_R2: R1.2, R2.1
/[7] Analog - Howland Current Pump/BIAS_R3_D1: D1.1 (A), R3.2
/[7] Analog - Howland Current Pump/BIAS_R5_R6: R5.2, R6.1
/[7] Analog - Howland Current Pump/I_SENSE: R7.2, TP21.1 (1_1), U1.3 (+); also elsewhere on the board
/[7] Analog - Howland Current Pump/PUMP_OUT: D1.3 (K), D2.1 (A), R7.1, TP17.1 (1_1), U2.6 (VOUT); also elsewhere on the board
/[7] Analog - Howland Current Pump/PUMP_REF: TP18.1 (1_1), U1.1, U1.4 (-), U2.1 (REF_B), U2.5 (REF_A)
/[7] Analog - Howland Current Pump/PUMP_V+: C40.1, Q2.3 (E), TP19.1 (1_1), U1.5 (V+), U2.7 (V+)
/[7] Analog - Howland Current Pump/PUMP_V-: C40.2, Q1.3 (E), TP20.1 (1_1), U1.2 (V-), U2.4 (V-)
/[7] Analog - Howland Current Pump/Q1_BASE: C1.2, Q1.1 (B), R4.2, R5.1, RB2.2; also elsewhere on the board
/[7] Analog - Howland Current Pump/Q2_BASE: C1.1, Q2.1 (B), R2.2, R3.1, RB1.2; also elsewhere on the board

Notes on the sheet:
MISC NOTE M2: TP17 PUMP_OUT, TP18 PUMP_REF, TP19/TP20 floating rails (span >= 4.5 V), TP21 I_SENSE: all float up to +/-110 V; use a differential or isolated probe.
MISC NOTE M1: JP1/JP2 bench bias: CLOSE at +/-30 V or below; OPEN at +/-100 V (RB1/RB2 would see ~190 V, ~0.9 W in a 0.25 W part).
LAYOUT NOTE L2: C40 across PUMP_V+ / PUMP_V- right at U2 pins 7 and 4: the floating rails decouple to each other, not to GND.
LAYOUT NOTE L1: Q1/Q2 DPAK: >= 300 mm^2 L1 pour on each collector tab (D6; up to 1.1 W in a 10 mA fault), 1.5 mm to everything; no thermal vias into L2.
DESIGN NOTE D1: 1 mA/V set by R7 = 1.00 k 0.1 % 25 ppm (0805 for self-heating). U2 INA149 senses across R7; U1 OPA192 buffers I_SENSE back to the REF pins (D-05).
DESIGN NOTE D2: Bias string and emitter followers Q1/Q2 (one BAS16 VBE each): PUMP_V+ / PUMP_V- float with PUMP_OUT; the INA149 needs >= 4.5 V across them. Compliance 5 mA into >= 13.1 kOhm at a 90 V rail [N].
LAYOUT NOTE L3: U2 straddles the HV/LV gap: inputs (pins 2, 3) face the LV zone; pin-to-pin creepage inside the package is excluded.
[7] Analog - Howland Current Pump
