WeymenKoo/STIM-Rev1-Hardware/(commit log)

2026-11-05 STIM Rev 1 hardware: working simulations, KiCad project and test records
    Snapshot of the shared workspace for the team and the client:
    - 01_client_board: LTspice model of the client's STIM board, acceptance
    tests A1-A7 with records, bench rig, sim-vs-bench table, deck 2
    - 02_rev1_channel: KiCad project STIM_Rev1 (2.1.0-dev, placed, unrouted),
    design definition, FPGA interface contract ICD_J3, gate sims G1/G2
    - 03_safety_plan: FMEA, safety-loop architecture and KiCad sketch, deck 1
    - 04_demo: DR1 demo plan
    Internal planning notes, review files and the frozen October tree are
    excluded via .gitignore and stay local only.
    [STIM_Rev1.kicad_pcb, STIM_Rev1.kicad_sch, analog-clamp-buffer.kicad_sch, analog-current-pump.kicad_sch, interface-adc-readback.kicad_sch, interface-dac-command.kicad_sch, interface-fpga.kicad_sch, interface-spi-isolator.kicad_sch]
2026-11-07 Client board B0 bring-up and bench tests
    - B0 bring-up records: +/-5 V and +/-5.75/6 V heat runs (CSV, PNG), photos, README
    - Bench scripts: bringup, relay, TBS scope driver, B0 window/figure, session log
    - Bench preflight CSVs (TBS generator flatness, probe comp)
    - BENCH-B0-SUMMARY.docx and updated BENCH-SESSION_30V.docx
    [B0_pm05p0V.csv, B0_pm05p0V_run2_raw.csv, B0_pm05p0V_run2_startup.csv, B0_pm05p0V_run2_startup_raw.csv, B0_pm05p0V_run2_trend.csv, B0_pm05p0V_run2_wave.csv, B0_pm05p75V_heat2_noRL_raw.csv, B0_pm05p75V_heat2_noRL_startup.csv]
2026-11-08 Rev 1 schematic: AD5761R DAC, two ADS8689 ADCs, ISO7741 isolators, converter rails (sheets 10-13)
    - [10] two TI ISO7741 (U43 F default-low: ENABLE/SCLK/MOSI + spare FAULT_N back; U44 default-high:
    CS_DAC/CS_ADC/CS_ADC2 + MISO back), J5 board-side twin of J3 and JP7 output-enable jumper for a
    no-rework bypass, 100 nF at every VCC pin.
    - [11] U40 AD5761RBRUZ on +/-12 V, +/-5 V range, LDAC low, CLEAR/RESET/ALERT pull-ups, VREF cap,
    decoupling drawn at the pins (rail -> 10 uF -> 100 nF -> pin).
    - [12] U41/U42 ADS8689IPWR on I_RETURN_ADC and V_ELEC_ADC (0-5.12 V range), reference and supply
    caps at the pins, shared RST pull-up; VMID_REF no longer digitised (TP29, software constant).
    - [13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
    [STIM_Rev1.kicad_sch, interface-adc-readback.kicad_sch, interface-dac-command.kicad_sch, interface-fpga.kicad_sch, interface-spi-isolator.kicad_sch, power-converter-rails.kicad_sch, sourcing_converters_isolators_2026-11-07.csv]
